dbalsom/seequa_chameleon/kicad/reference_images/under_sram_01.jpg

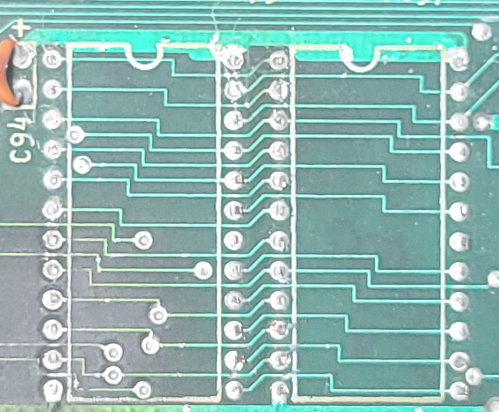
kicad/reference_images/under_sram_01.jpg
