dbalsom/seequa_chameleon/kicad/reference_images/under_6845.jpg

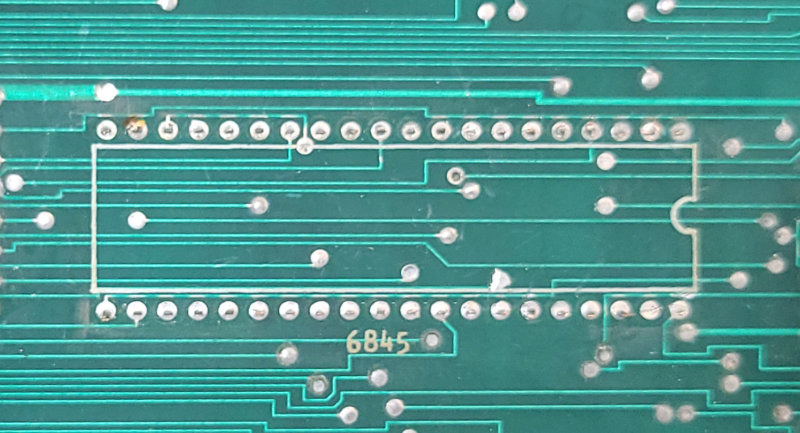
kicad/reference_images/under_6845.jpg
