dbalsom/seequa_chameleon/README.md

# The Seequa Chameleon

chameleon

The Chameleon was an interesting PC clone luggable. 

It had a Z80 and 8088 CPU, which could be switched between, allowing a Chameleon owner to use both MS-DOS and CP/M.

Forgoing the usual ISA expansion slots, it included a number of peripherals directly on the motherboard, including an integrated CGA-compatible video card with some interesting additions such as font SRAM and palette registers.

This project aims to produce schematics for the Chameleon by tracing out the motherboard in Kicad.

## Requirements

This project requires [KiCad version 9](https://www.kicad.org/download/).

## More info

For more info on the Chameleon, see the excellent [seequa.org](https://seequa.org/)

## Special Thanks

Thanks to Matthew Jones for nerd-sniping me with this fascinating and wonky machine.
