dbalsom/seequa_chameleon/kicad/reference_images/chameleon_front_04.jpg

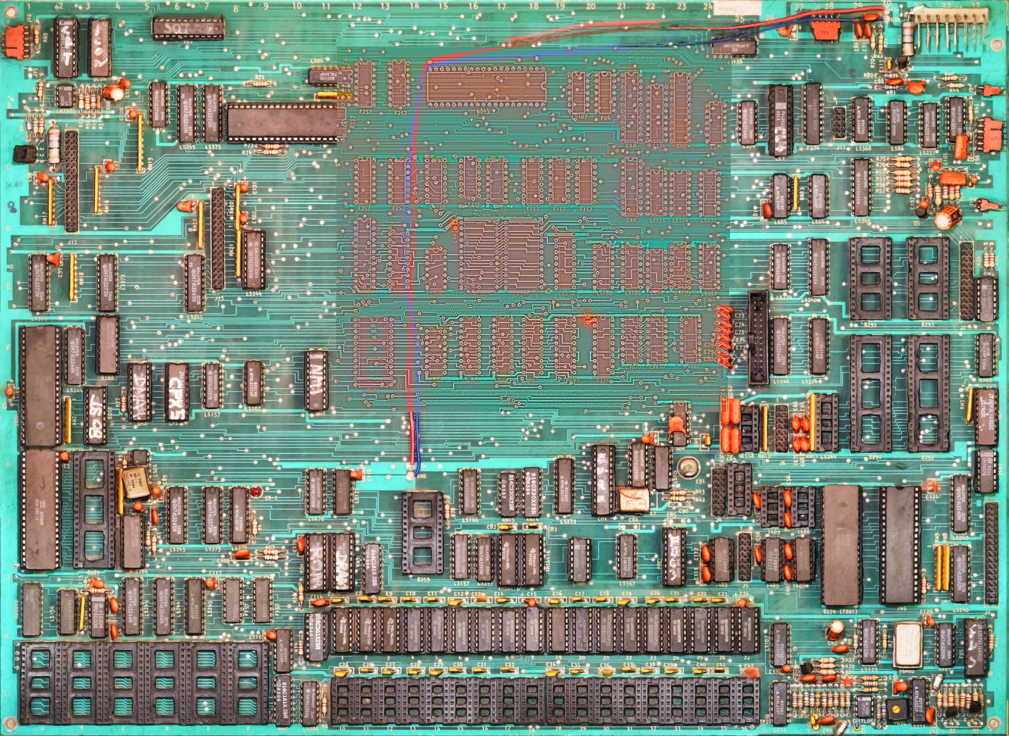
kicad/reference_images/chameleon_front_04.jpg
