dbalsom/seequa_chameleon/kicad/reference_images/chameleon_front_05.jpg

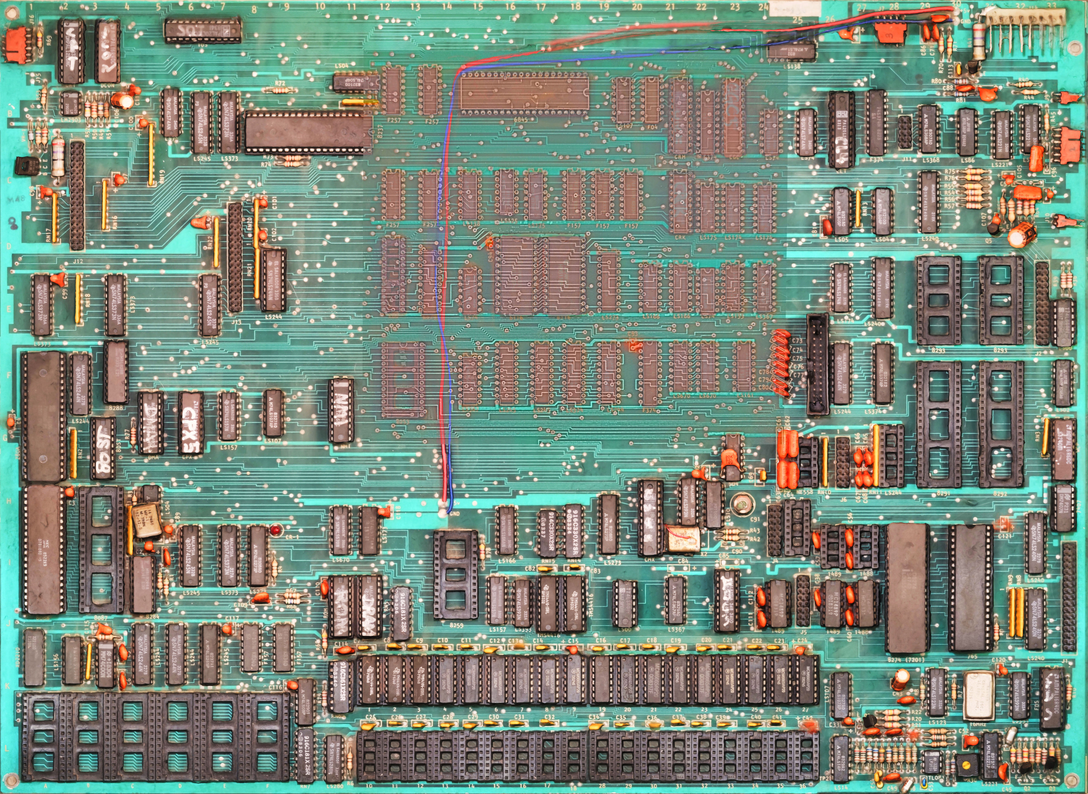
kicad/reference_images/chameleon_front_05.jpg
