dbalsom/seequa_chameleon/kicad/reference_images/chameleon_front_06.jpg

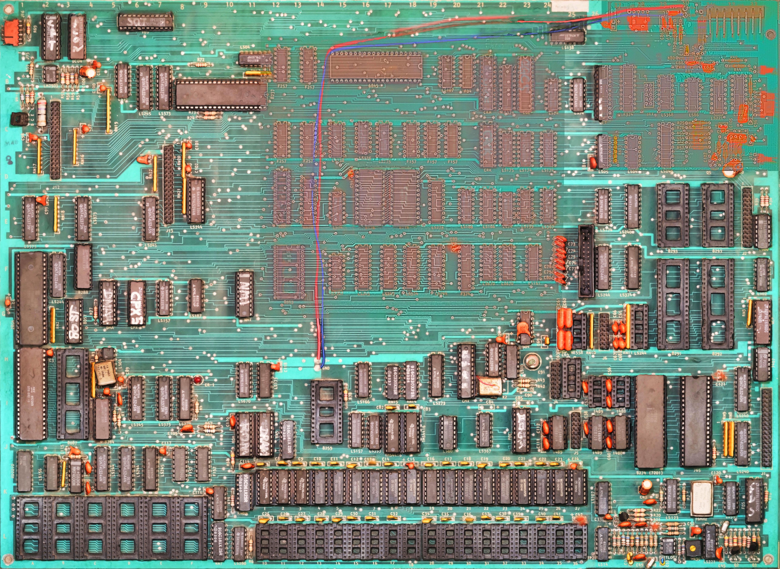
kicad/reference_images/chameleon_front_06.jpg
