dbalsom/seequa_chameleon/kicad/reference_images/schematic_background.png

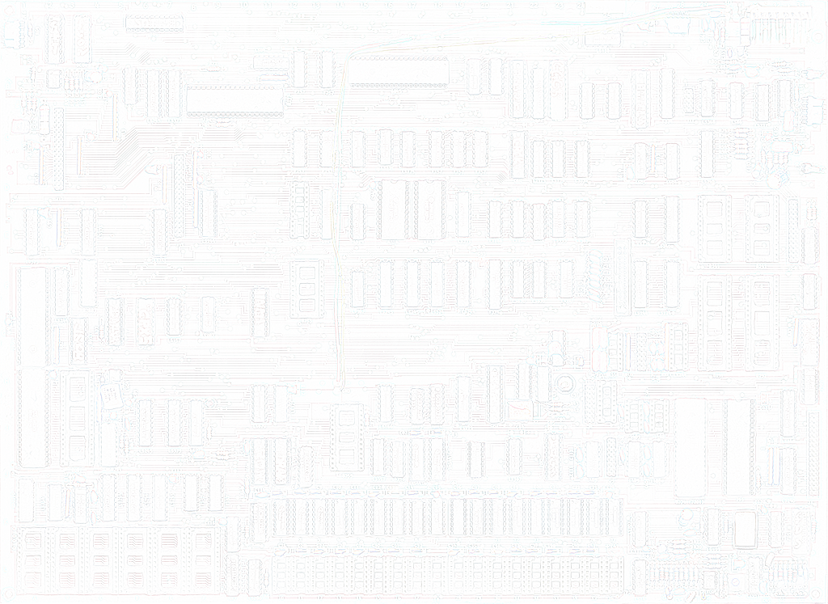
kicad/reference_images/schematic_background.png
