dbalsom/seequa_chameleon/kicad/reference_images/under_cpu_01.jpg

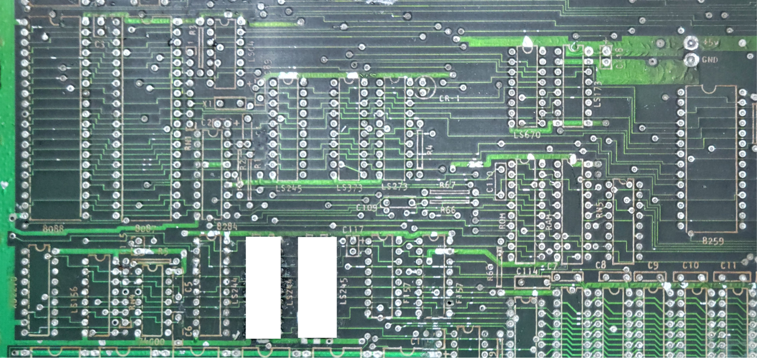
kicad/reference_images/under_cpu_01.jpg
