dbalsom/seequa_chameleon/kicad/reference_images/under_roms_01.jpg

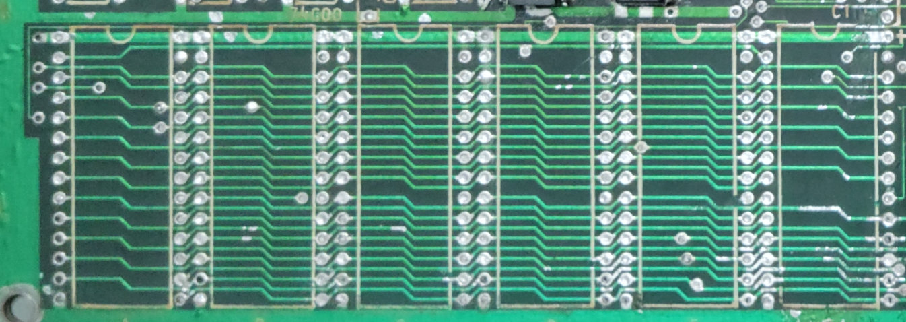
kicad/reference_images/under_roms_01.jpg
