dbalsom/seequa_chameleon/kicad/reference_images/under_tape_01.jpg

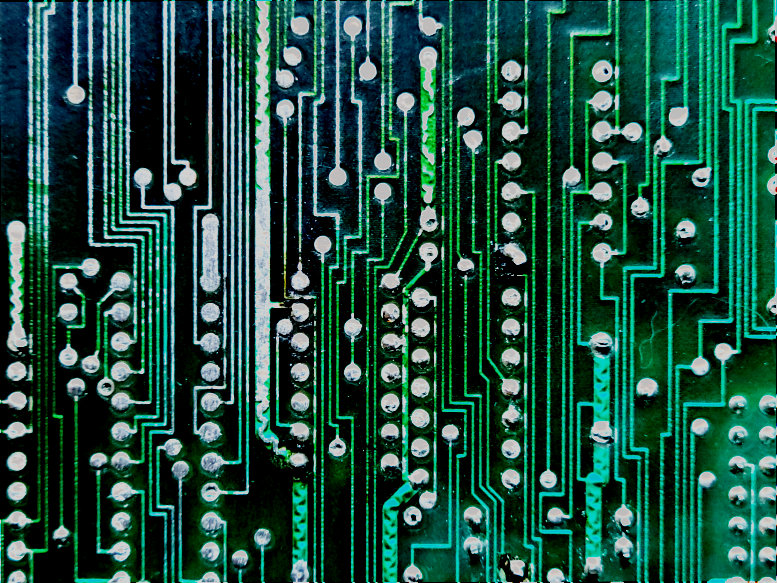
kicad/reference_images/under_tape_01.jpg
