dbalsom/seequa_chameleon/kicad/composite_video.kicad_sch

## KiCad design kicad/composite_video.kicad_sch (2026-05-13)

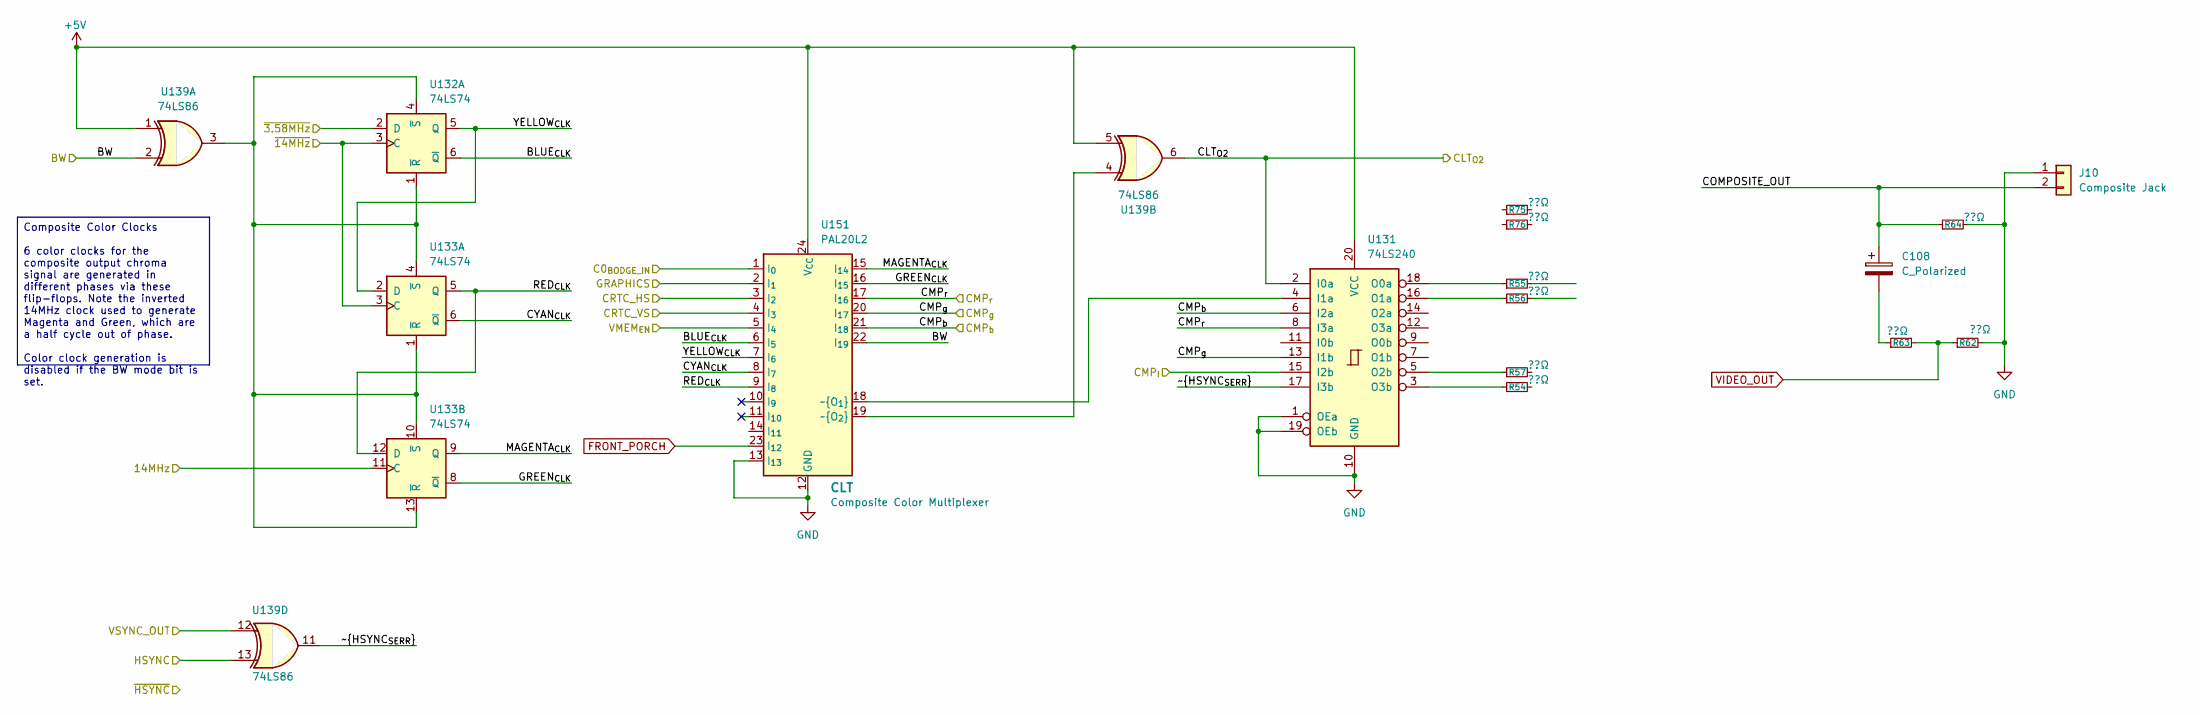
[picture p10: schematic composite_video.kicad_sch]

Parts:
C108: C_Polarized
J10: Composite Jack; PinHeader_1x02_P2.54mm_Horizontal
R54, R55, R56, R57, R62, R63, R64, R75, R76: ??Ω; R_Seequa_Resistor
U131: 74LS240; DIP-20_W7.62mm
U132, U133: 74LS74; DIP-14_W7.62mm
U139: 74LS86; DIP-14_W7.62mm
U151: PAL20L2; DIP-24_W7.62mm

Connections:
14MHz: U133.11 (C)
+5V: U131.20 (VCC), U139.1, U139.5, U151.24 (V_{CC})
BLUE_{CLK}: U132.6 (~Q), U151.6 (I_{5})
BW: U139.2, U151.22 (I_{19})
C0_{BODGE_IN}: U151.1 (I_{0})
CLT_{O2}: U131.2 (I0a), U139.6
CMP_{I}: U131.15 (I2b)
CMP_{b}: U131.6 (I2a), U151.21 (I_{18})
CMP_{g}: U131.13 (I1b), U151.20 (I_{17})
CMP_{r}: U131.8 (I3a), U151.17 (I_{16})
COMPOSITE_OUT: C108.1, J10.2, R64.1
CRTC_HS: U151.3 (I_{2})
CRTC_VS: U151.4 (I_{3})
CYAN_{CLK}: U133.6 (~Q), U151.8 (I_{7})
FRONT_PORCH: U151.23 (I_{12})
GND: J10.1, R62.2, R64.2, U131.1 (OEa), U131.10 (GND), U131.19 (OEb), U151.12 (GND), U151.13 (I_{13})
GRAPHICS: U151.2 (I_{1})
GREEN_{CLK}: U133.8 (~Q), U151.16 (I_{15})
HSYNC: U139.13
MAGENTA_{CLK}: U133.9 (Q), U151.15 (I_{14})
unnamed: C108.2, R63.1
unnamed: R54.1, U131.3 (O3b)
unnamed: R55.1, U131.18 (O0a)
unnamed: R56.1, U131.16 (O1a)
unnamed: R57.1, U131.5 (O2b)
unnamed: U131.4 (I1a), U151.18 (~O_{1})
unnamed: U132.1 (~R), U132.4 (~S), U133.1 (~R), U133.4 (~S), U133.10 (~S), U133.13 (~R), U139.3
unnamed: U139.4, U151.19 (~O_{2})
RED_{CLK}: U133.5 (Q), U133.12 (D), U151.9 (I_{8})
VIDEO_OUT: R62.1, R63.2
VMEM_{EN}: U151.5 (I_{4})
VSYNC_OUT: U139.12
YELLOW_{CLK}: U132.5 (Q), U133.2 (D), U151.7 (I_{6})
~3.58MHz: U132.2 (D)
~14MHz: U132.3 (C), U133.3 (C)
~HSYNC_{SERR}: U131.17 (I3b), U139.11

Notes on the sheet:
Composite Color Clocks 6 color clocks for the composite output chroma signal are generated in different phases via these flip-flops. Note the inverted 14MHz clock used to generate Magenta and Green, which are a half cycle out of phase. Color clock generation is disabled if the BW mode bit is set.
