dbalsom/seequa_chameleon/kicad/cpu.kicad_sch

## KiCad design kicad/cpu.kicad_sch (2026-05-13)

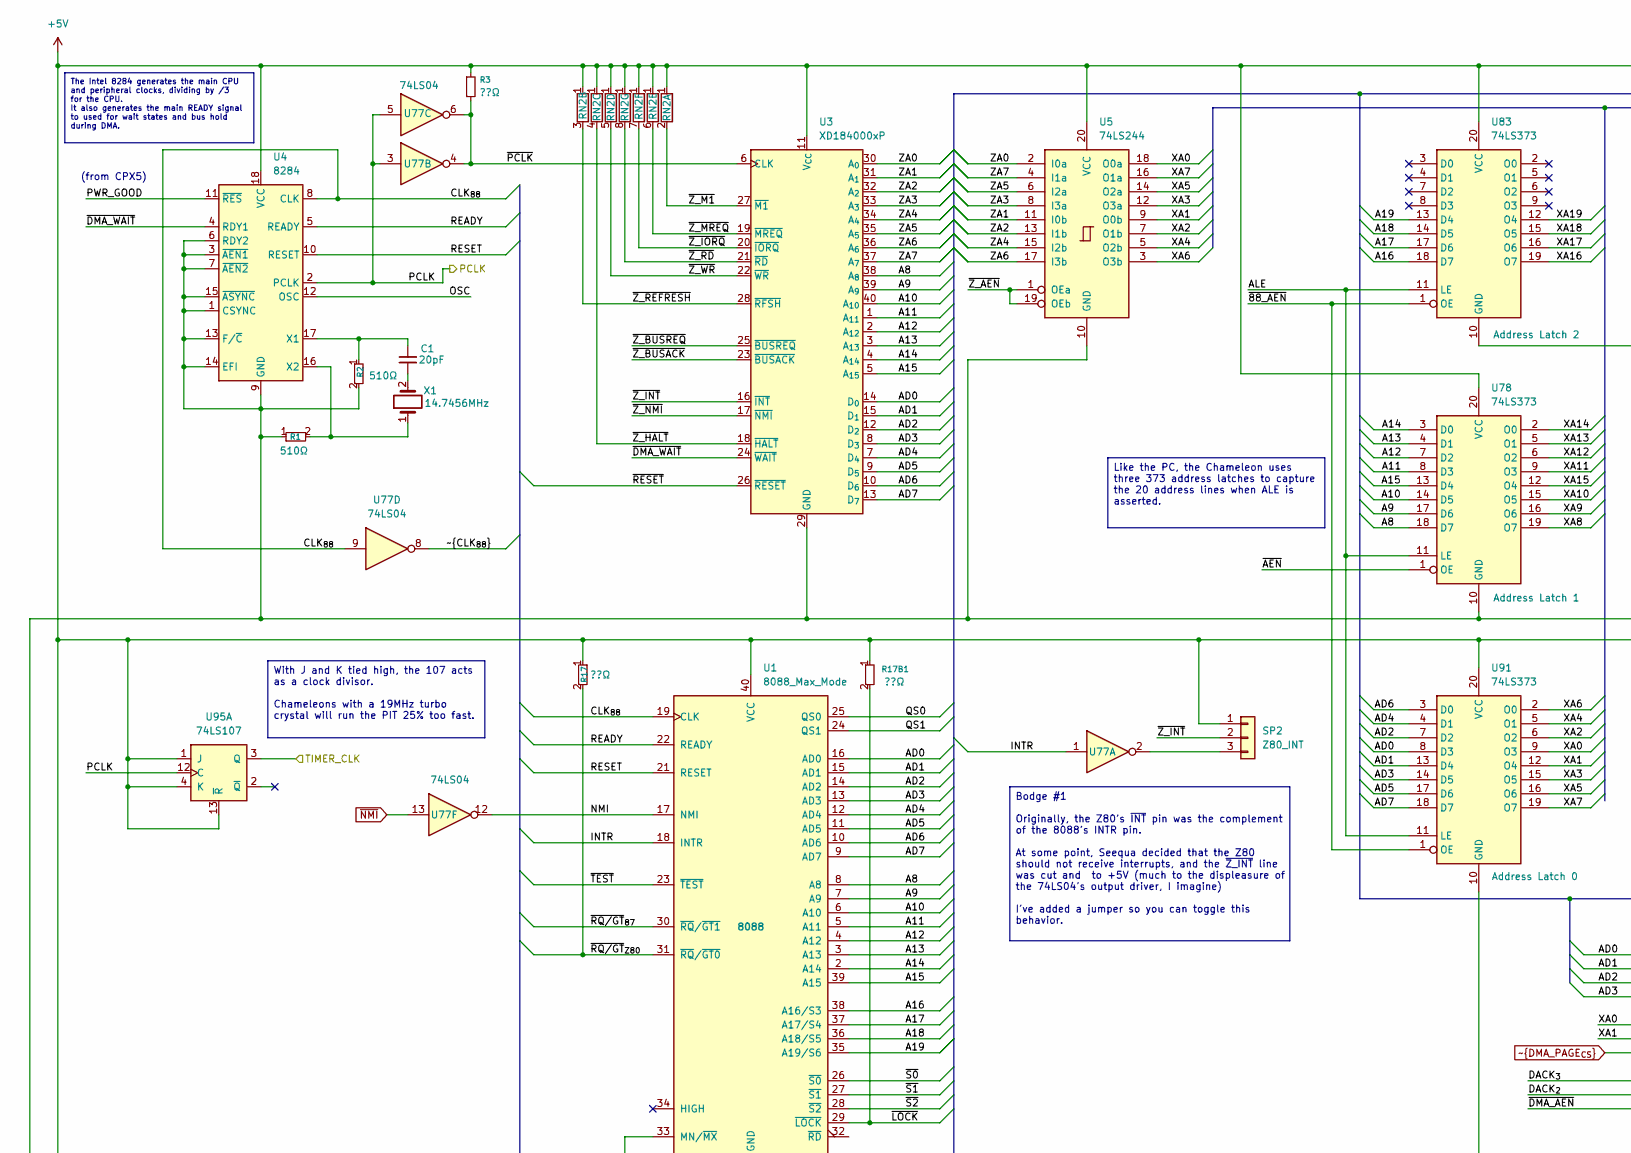
[picture p11: schematic cpu.kicad_sch, part in row 1, column 1]

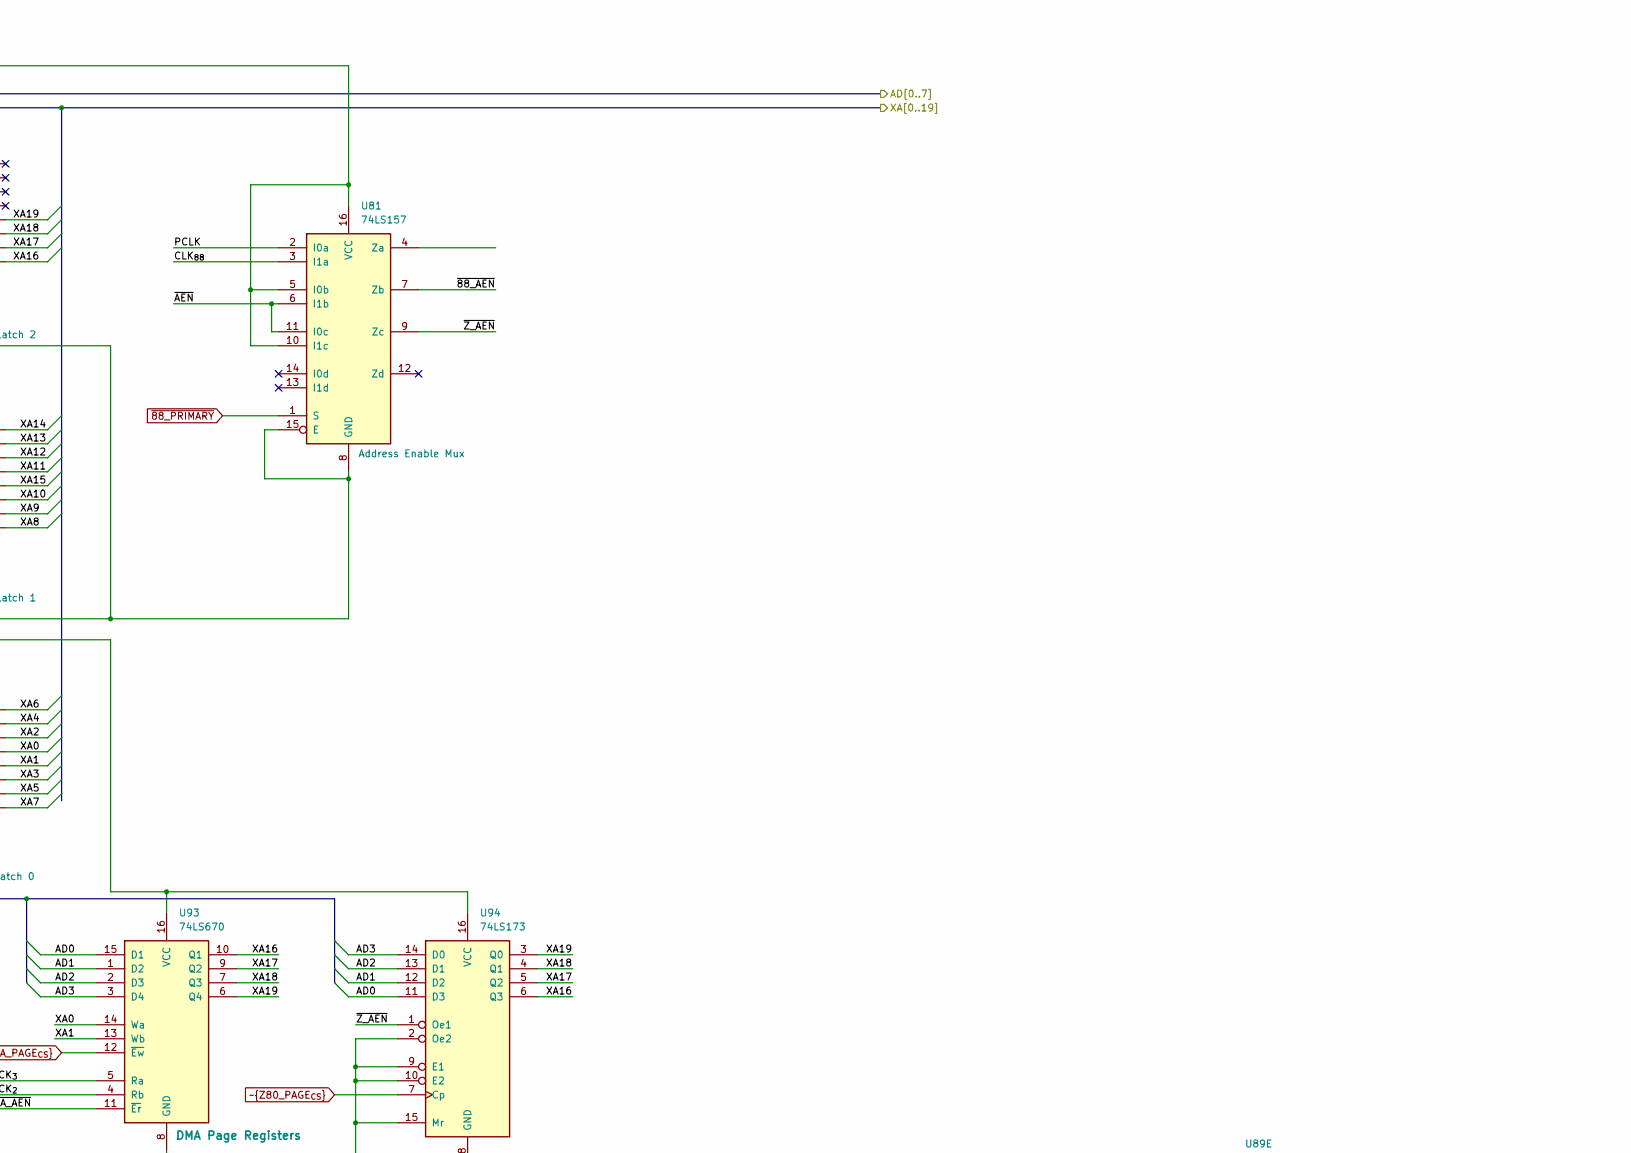
[picture p12: schematic cpu.kicad_sch, part in row 1, column 2]

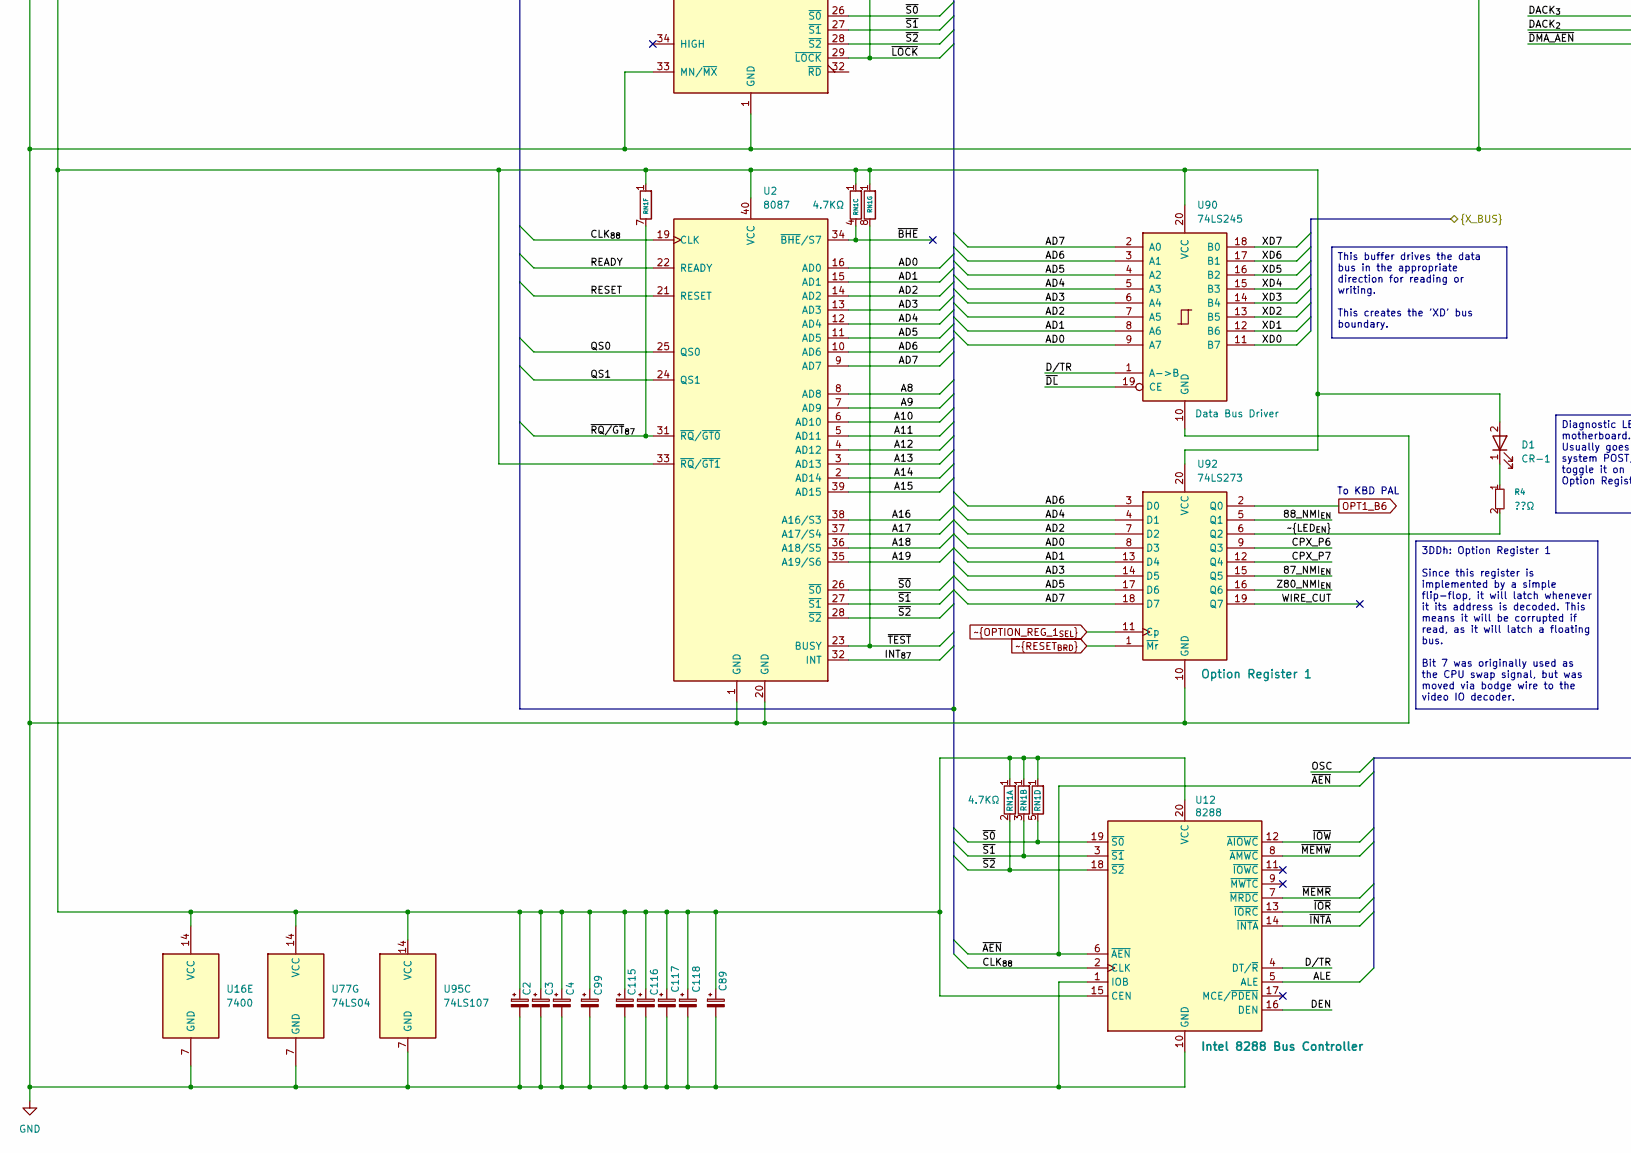
[picture p13: schematic cpu.kicad_sch, part in row 2, column 1]

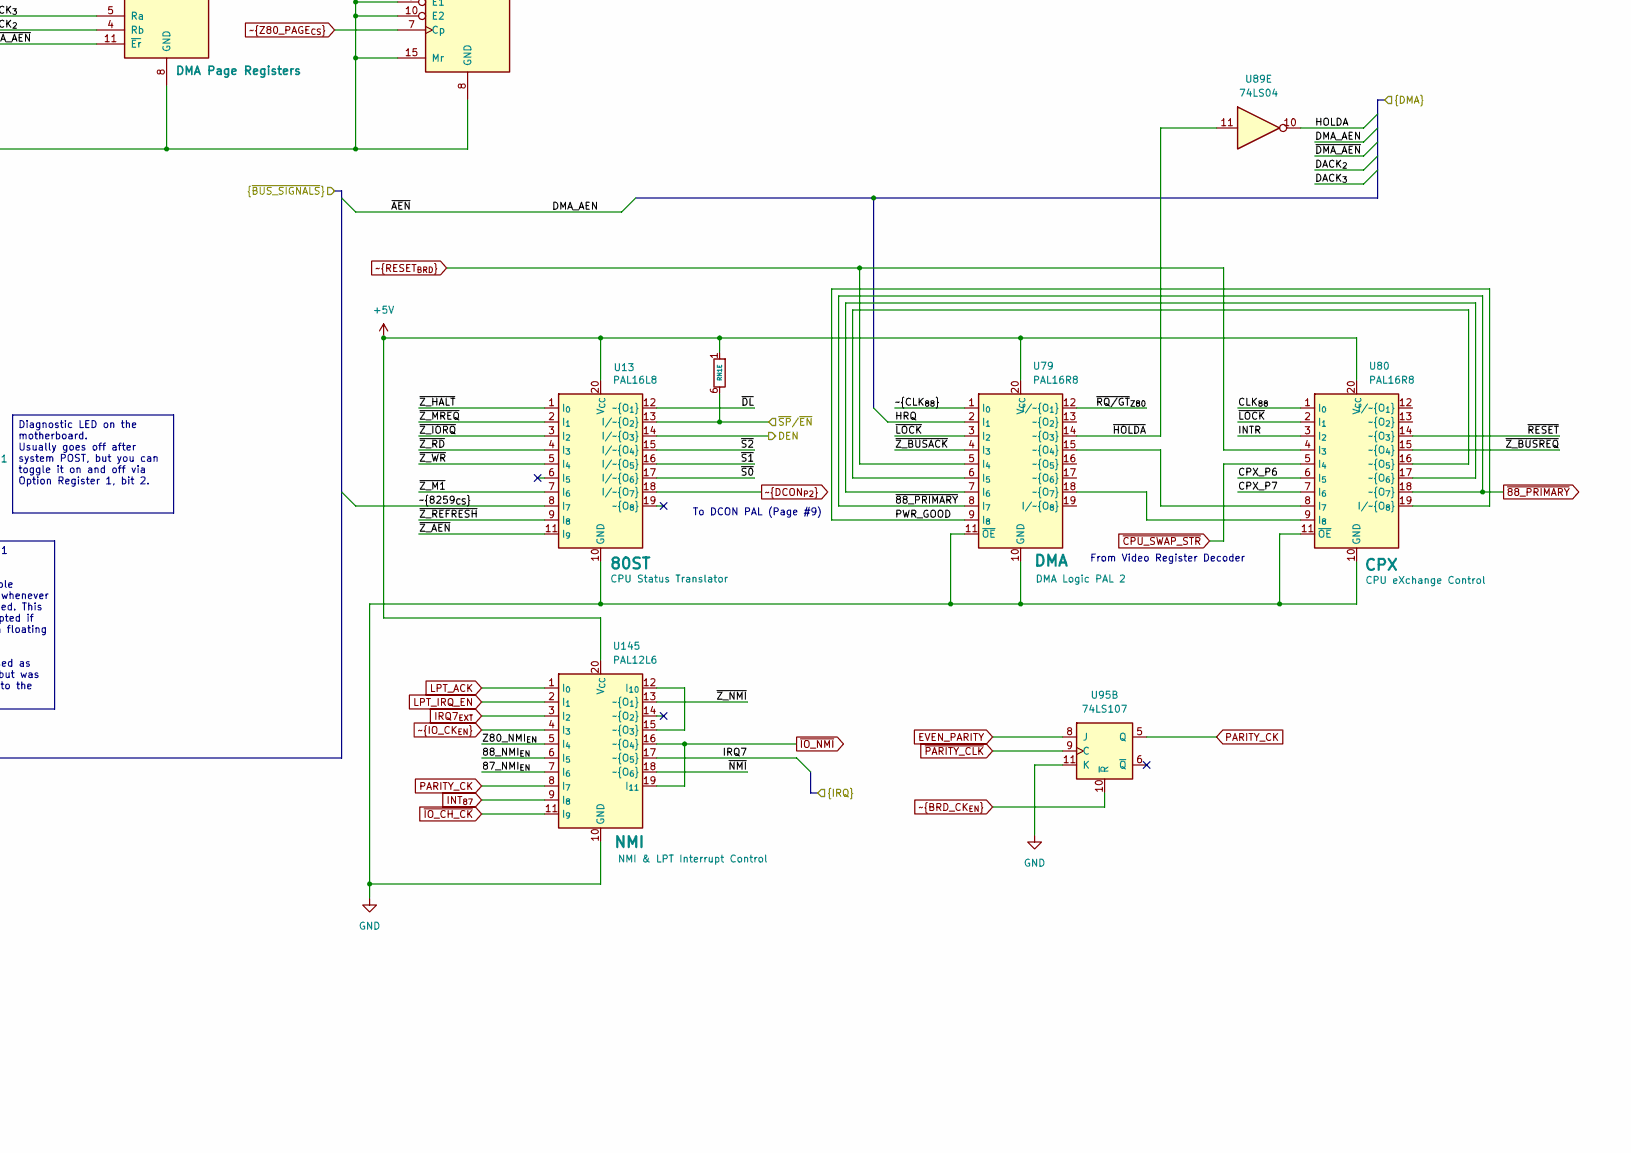
[picture p14: schematic cpu.kicad_sch, part in row 2, column 2]

Parts:
C1: 20pF; C_Seequa_Clock_Cap_6.35mm
C2, C3, C4, C99, C115, C116, C117, C118: 0.1uF; C_Seequa_Bypass_2.54mm
C89: C_Bypass_3.8mm; C_Seequa_Bypass_3.8mm
D1: CR-1; LED_D3.0mm
R1, R2: 510Ω; R_Seequa_Resistor
R3, R4, R17, R17B1: ??Ω; R_Seequa_Resistor
RN1: 4.7KΩ; R_Array_SIP8
RN2: 4.7K; R_Array_SIP8
SP2: Z80_INT; PinHeader_1x03_P2.54mm_Vertical
U1: 8088_Max_Mode; DIP-40_W15.24mm_Socket
U2: 8087; DIP-40_W15.24mm
U3: XD184000xP; DIP-40_W15.24mm
U4: 8284; DIP-18_W7.62mm
U5: 74LS244; DIP-20_W7.62mm
U12: 8288; DIP-20_W7.62mm
U13: PAL16L8; DIP-20_W7.62mm
U16: 7400; DIP-14_W7.62mm
U77, U89: 74LS04; DIP-14_W7.62mm
U78, U83, U91: 74LS373; DIP-20_W7.62mm
U79, U80: PAL16R8; DIP-20_W7.62mm
U81: 74LS157; DIP-16_W7.62mm
U90: 74LS245; DIP-20_W7.62mm
U92: 74LS273; DIP-20_W7.62mm
U93: 74LS670; DIP-16_W7.62mm
U94: 74LS173; DIP-16_W7.62mm
U95: 74LS107; DIP-14_W7.62mm
U145: PAL12L6; DIP-20_W7.62mm
X1: 14.7456MHz; Crystal_HC49-U_Vertical

Connections:
87_NMI_{EN}: U92.15 (Q5), U145.7 (I_{6})
88_NMI_{EN}: U92.5 (Q1), U145.6 (I_{5})
+5V: C2.1, C3.1, C4.1, C89.1, C99.1, C115.1, C116.1, C117.1, C118.1, D1.2 (A), R3.1, R17.1, R17B1.1, RN1.1 (R1), RN2.1 (R1), SP2.1, U1.40 (VCC), U2.33 (~RQ/~GT1), U2.40 (VCC), U3.11 (V_{CC}), U4.18 (VCC), U5.20 (VCC), U12.15 (CEN), U12.20 (VCC), U13.20 (V_{CC}), U16.14 (VCC), U77.14 (VCC), U78.20 (VCC), U79.20 (V_{CC}), U80.20 (V_{CC}), U81.5 (I0b), U81.10 (I1c), U81.16 (VCC), U83.20 (VCC), U90.20 (VCC), U91.20 (VCC), U92.20 (VCC), U93.16 (VCC), U94.16 (VCC), U95.1 (J), U95.4 (K), U95.13 (~R), U95.14 (VCC), U145.20 (V_{CC})
A8: U1.8 (A8), U2.8 (AD8), U3.38 (A_{8}), U78.18 (D7)
A9: U1.7 (A9), U2.7 (AD9), U3.39 (A_{9}), U78.17 (D6)
A10: U1.6 (A10), U2.6 (AD10), U3.40 (A_{10}), U78.14 (D5)
A11: U1.5 (A11), U2.5 (AD11), U3.1 (A_{11}), U78.8 (D3)
A12: U1.4 (A12), U2.4 (AD12), U3.2 (A_{12}), U78.7 (D2)
A13: U1.3 (A13), U2.3 (AD13), U3.3 (A_{13}), U78.4 (D1)
A14: U1.2 (A14), U2.2 (AD14), U3.4 (A_{14}), U78.3 (D0)
A15: U1.39 (A15), U2.39 (AD15), U3.5 (A_{15}), U78.13 (D4)
A16: U1.38 (A16/S3), U2.38 (A16/S3), U83.18 (D7)
A17: U1.37 (A17/S4), U2.37 (A17/S4), U83.17 (D6)
A18: U1.36 (A18/S5), U2.36 (A18/S5), U83.14 (D5)
A19: U1.35 (A19/S6), U2.35 (A19/S6), U83.13 (D4)
AD0: U1.16 (AD0), U2.16 (AD0), U3.14 (D_{0}), U90.9 (A7), U91.8 (D3), U92.8 (D3), U93.15 (D1), U94.11 (D3)
AD1: U1.15 (AD1), U2.15 (AD1), U3.15 (D_{1}), U90.8 (A6), U91.13 (D4), U92.13 (D4), U93.1 (D2), U94.12 (D2)
AD2: U1.14 (AD2), U2.14 (AD2), U3.12 (D_{2}), U90.7 (A5), U91.7 (D2), U92.7 (D2), U93.2 (D3), U94.13 (D1)
AD3: U1.13 (AD3), U2.13 (AD3), U3.8 (D_{3}), U90.6 (A4), U91.14 (D5), U92.14 (D5), U93.3 (D4), U94.14 (D0)
AD4: U1.12 (AD4), U2.12 (AD4), U3.7 (D_{4}), U90.5 (A3), U91.4 (D1), U92.4 (D1)
AD5: U1.11 (AD5), U2.11 (AD5), U3.9 (D_{5}), U90.4 (A2), U91.17 (D6), U92.17 (D6)
AD6: U1.10 (AD6), U2.10 (AD6), U3.10 (D_{6}), U90.3 (A1), U91.3 (D0), U92.3 (D0)
AD7: U1.9 (AD7), U2.9 (AD7), U3.13 (D_{7}), U90.2 (A0), U91.18 (D7), U92.18 (D7)
ALE: U12.5 (ALE), U78.11 (LE), U83.11 (LE), U91.11 (LE)
CLK_{88}: U1.19 (CLK), U2.19 (CLK), U4.8 (CLK), U12.2 (CLK), U77.9, U80.1 (I_{0}), U81.3 (I1a)
CPX_P6: U80.6 (I_{5}), U92.9 (Q3)
CPX_P7: U80.7 (I_{6}), U92.12 (Q4)
DACK_{2}: U93.4 (Rb)
DACK_{3}: U93.5 (Ra)
DEN: U12.16 (DEN), U13.14 (I/~O_{3})
DMA_AEN: U12.6 (~AEN), U78.1 (OE), U81.6 (I1b), U81.11 (I0c)
D/TR: U12.4 (DT/~R), U90.1 (A->B)
EVEN_PARITY: U95.8 (J)
GND: C2.2, C3.2, C4.2, C89.2, C99.2, C115.2, C116.2, C117.2, C118.2, R1.1, R2.2, U1.1 (GND), U1.20 (GND), U1.33 (MN/~MX), U2.1 (GND), U2.20 (GND), U3.29 (GND), U4.1 (CSYNC), U4.3 (~AEN1), U4.6 (RDY2), U4.7 (~AEN2), U4.9 (GND), U4.13 (F/~C), U4.14 (EFI), U4.15 (~ASYNC), U5.10 (GND), U12.1 (IOB), U12.10 (GND), U13.10 (GND), U16.7 (GND), U77.7 (GND), U78.10 (GND), U79.10 (GND), U79.11 (~OE), U80.10 (GND), U80.11 (~OE), U81.8 (GND), U81.15 (E), U83.10 (GND), U90.10 (GND), U91.10 (GND), U92.10 (GND), U93.8 (GND), U94.2 (Oe2), U94.8 (GND), U94.9 (E1), U94.10 (E2), U94.15 (Mr), U95.7 (GND), U95.11 (K), U145.10 (GND)
HOLDA: U89.10
HRQ: U79.2 (I_{1})
INTR: U1.18 (INTR), U77.1, U80.3 (I_{2})
INT_{87}: U2.32 (INT), U145.9 (I_{8})
IRQ7: U145.17 (~O_{5})
IRQ7_{EXT}: U145.3 (I_{2})
LPT_ACK: U145.1 (I_{0})
LPT_IRQ_EN: U145.2 (I_{1})
NMI: U1.17 (NMI), U77.12
unnamed: C1.1, X1.2
unnamed: C1.2, R2.1, U4.17 (X1)
unnamed: D1.1 (K), R4.1
unnamed: R1.2, U4.16 (X2), X1.1
unnamed: SP2.3, U77.2
unnamed: U79.6 (I_{5}), U80.16 (~O_{5})
unnamed: U79.7 (I_{6}), U80.17 (~O_{6})
unnamed: U79.15 (~O_{4}), U80.8 (I_{7})
unnamed: U79.18 (~O_{7}), U80.9 (I_{8})
unnamed: U145.12 (I_{10}), U145.15 (~O_{3})
OPT1_B6: U92.2 (Q0)
OSC: U4.12 (OSC)
PARITY_CK: U95.5 (Q), U145.8 (I_{7})
PCLK: U4.2 (PCLK), U77.3, U77.5, U81.2 (I0a), U95.12 (C)
PWR_GOOD: U4.11 (~RES), U79.9 (I_{8}), U80.19 (I/~O_{8})
QS0: U1.25 (QS0), U2.25 (QS0)
QS1: U1.24 (QS1), U2.24 (QS1)
READY: U1.22 (READY), U2.22 (READY), U4.5 (READY)
RESET: U1.21 (RESET), U2.21 (RESET), U4.10 (RESET)
TIMER_CLK: U95.3 (Q)
WIRE_CUT: U92.19 (Q7)
XA0: U5.18 (O0a), U91.9 (O3), U93.14 (Wa)
XA1: U5.9 (O0b), U91.12 (O4), U93.13 (Wb)
XA2: U5.7 (O1b), U91.6 (O2)
XA3: U5.12 (O3a), U91.15 (O5)
XA4: U5.5 (O2b), U91.5 (O1)
XA5: U5.14 (O2a), U91.16 (O6)
XA6: U5.3 (O3b), U91.2 (O0)
XA7: U5.16 (O1a), U91.19 (O7)
XA8: U78.19 (O7)
XA9: U78.16 (O6)
XA10: U78.15 (O5)
XA11: U78.9 (O3)
XA12: U78.6 (O2)
XA13: U78.5 (O1)
XA14: U78.2 (O0)
XA15: U78.12 (O4)
XA16: U83.19 (O7), U93.10 (Q1), U94.6 (Q3)
XA17: U83.16 (O6), U93.9 (Q2), U94.5 (Q2)
XA18: U83.15 (O5), U93.7 (Q3), U94.4 (Q1)
XA19: U83.12 (O4), U93.6 (Q4), U94.3 (Q0)
XD0: U90.11 (B7)
XD1: U90.12 (B6)
XD2: U90.13 (B5)
XD3: U90.14 (B4)
XD4: U90.15 (B3)
XD5: U90.16 (B2)
XD6: U90.17 (B1)
XD7: U90.18 (B0)
Z80_NMI_{EN}: U92.16 (Q6), U145.5 (I_{4})
ZA0: U3.30 (A_{0}), U5.2 (I0a)
ZA1: U3.31 (A_{1}), U5.11 (I0b)
ZA2: U3.32 (A_{2}), U5.13 (I1b)
ZA3: U3.33 (A_{3}), U5.8 (I3a)
ZA4: U3.34 (A_{4}), U5.15 (I2b)
ZA5: U3.35 (A_{5}), U5.6 (I2a)
ZA6: U3.36 (A_{6}), U5.17 (I3b)
ZA7: U3.37 (A_{7}), U5.4 (I1a)
~88_AEN: U81.7 (Zb), U83.1 (OE), U91.1 (OE)
~88_PRIMARY: U79.8 (I_{7}), U80.18 (~O_{7}), U81.1 (S)
~8259_{CS}: U13.8 (I_{7})
~BHE: RN1.4 (R3.2), U2.34 (~BHE/S7)
~BRD_CK_{EN}: U95.10 (~R)
~CLK_{88}: U77.8, U79.1 (I_{0})
~CPU_SWAP_STR: U80.5 (I_{4})
~DCON_{P2}: U13.18 (I/~O_{7})
~DL: U13.12 (~O_{1}), U90.19 (CE)
~DMA_AEN: U93.11 (~Er)
~DMA_PAGE_{CS}: U93.12 (~Ew)
~DMA_WAIT: U3.24 (~WAIT), U4.4 (RDY1)
~HOLDA: U79.14 (~O_{3}), U89.11
~INTA: U12.14 (~INTA)
~IOR: U12.13 (~IORC)
~IOW: U12.12 (~AIOWC)
~IO_CH_CK: U145.11 (I_{9})
~IO_CK_{EN}: U145.4 (I_{3})
~IO_NMI: U145.16 (~O_{4}), U145.19 (I_{11})
~LED_{EN}: R4.2, U92.6 (Q2)
~LOCK: R17B1.2, U1.29 (~LOCK), U79.3 (I_{2}), U80.2 (I_{1})
~MEMR: U12.7 (~MRDC)
~MEMW: U12.8 (~AMWC)
~NMI: U77.13, U145.18 (~O_{6})
~OPTION_REG_1_{SEL}: U92.11 (Cp)
~PARITY_CLK: U95.9 (C)
~PCLK: R3.2, U3.6 (CLK), U77.4, U77.6
~RESET_{BRD}: U79.5 (I_{4}), U80.4 (I_{3}), U92.1 (~Mr)
~RESET: U3.26 (~RESET), U80.14 (~O_{3})
~RQ/GT_{87}: RN1.7 (R6.2), U1.30 (~RQ/~GT1), U2.31 (~RQ/~GT0)
~RQ/GT_{Z80}: R17.2, U1.31 (~RQ/~GT0), U79.12 (I/~O_{1})
~S0: RN1.5 (R4.2), U1.26 (~S0), U2.26 (~S0), U12.19 (~S0), U13.17 (I/~O_{6})
~S1: RN1.3 (R2.2), U1.27 (~S1), U2.27 (~S1), U12.3 (~S1), U13.16 (I/~O_{5})
~S2: RN1.2 (R1.2), U1.28 (~S2), U2.28 (~S2), U12.18 (~S2), U13.15 (I/~O_{4})
~SP/~EN: RN1.6 (R5.2), U13.13 (I/~O_{2})
~TEST: RN1.8 (R7.2), U1.23 (~TEST), U2.23 (BUSY)
~Z80_PAGE_{CS}: U94.7 (Cp)
~Z_AEN: U5.1 (OEa), U5.19 (OEb), U13.11 (I_{9}), U81.9 (Zc), U94.1 (Oe1)
~Z_BUSACK: U3.23 (~BUSACK), U79.4 (I_{3})
~Z_BUSREQ: U3.25 (~BUSREQ), U80.15 (~O_{4})
~Z_HALT: RN2.4 (R3.2), U3.18 (~HALT), U13.1 (I_{0})
~Z_INT: SP2.2, U3.16 (~INT)
~Z_IORQ: RN2.7 (R6.2), U3.20 (~IORQ), U13.3 (I_{2})
~Z_M1: RN2.2 (R1.2), U3.27 (~M1), U13.7 (I_{6})
~Z_MREQ: RN2.6 (R5.2), U3.19 (~MREQ), U13.2 (I_{1})
~Z_NMI: U3.17 (~NMI), U145.13 (~O_{1})
~Z_RD: RN2.8 (R7.2), U3.21 (~RD), U13.4 (I_{3})
~Z_REFRESH: RN2.3 (R2.2), U3.28 (~RFSH), U13.9 (I_{8})
~Z_WR: RN2.5 (R4.2), U3.22 (~WR), U13.5 (I_{4})

Notes on the sheet:
To KBD PAL
From Video Register Decoder
To DCON PAL (Page #9)
(from CPX5)
With J and K tied high, the 107 acts as a clock divisor. Chameleons with a 19MHz turbo crystal will run the PIT 25% too fast.
3DDh: Option Register 1 Since this register is implemented by a simple flip-flop, it will latch whenever it its address is decoded. This means it will be corrupted if read, as it will latch a floating bus. Bit 7 was originally used as the CPU swap signal, but was moved via bodge wire to the video I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
The Intel 8284 generates the main CPU and peripheral clocks, dividing by /3 for the CPU. It also generates the main READY signal to used for wait states and bus hold during DMA.
Diagnostic LED on the motherboard. Usually goes off after system POST, but you can toggle it on and off via Option Register 1, bit 2.
Like the PC, the Chameleon uses three 373 address latches to capture the 20 address lines when ALE is asserted.
Bodge #1 Originally, the Z80's ~{INT} pin was the complement of the 8088's INTR pin. At some point, Seequa decided that the Z80 should not receive interrupts, and the ~{Z_INT} line was cut and to +5V (much to the displeasure of the 74LS04's output driver, I imagine) I've added a jumper so you can t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
This buffer drives the data bus in the appropriate direction for reading or writing. This creates the 'XD' bus boundary.
