dbalsom/seequa_chameleon/kicad/crtc.kicad_sch

## KiCad design kicad/crtc.kicad_sch (2026-05-13)

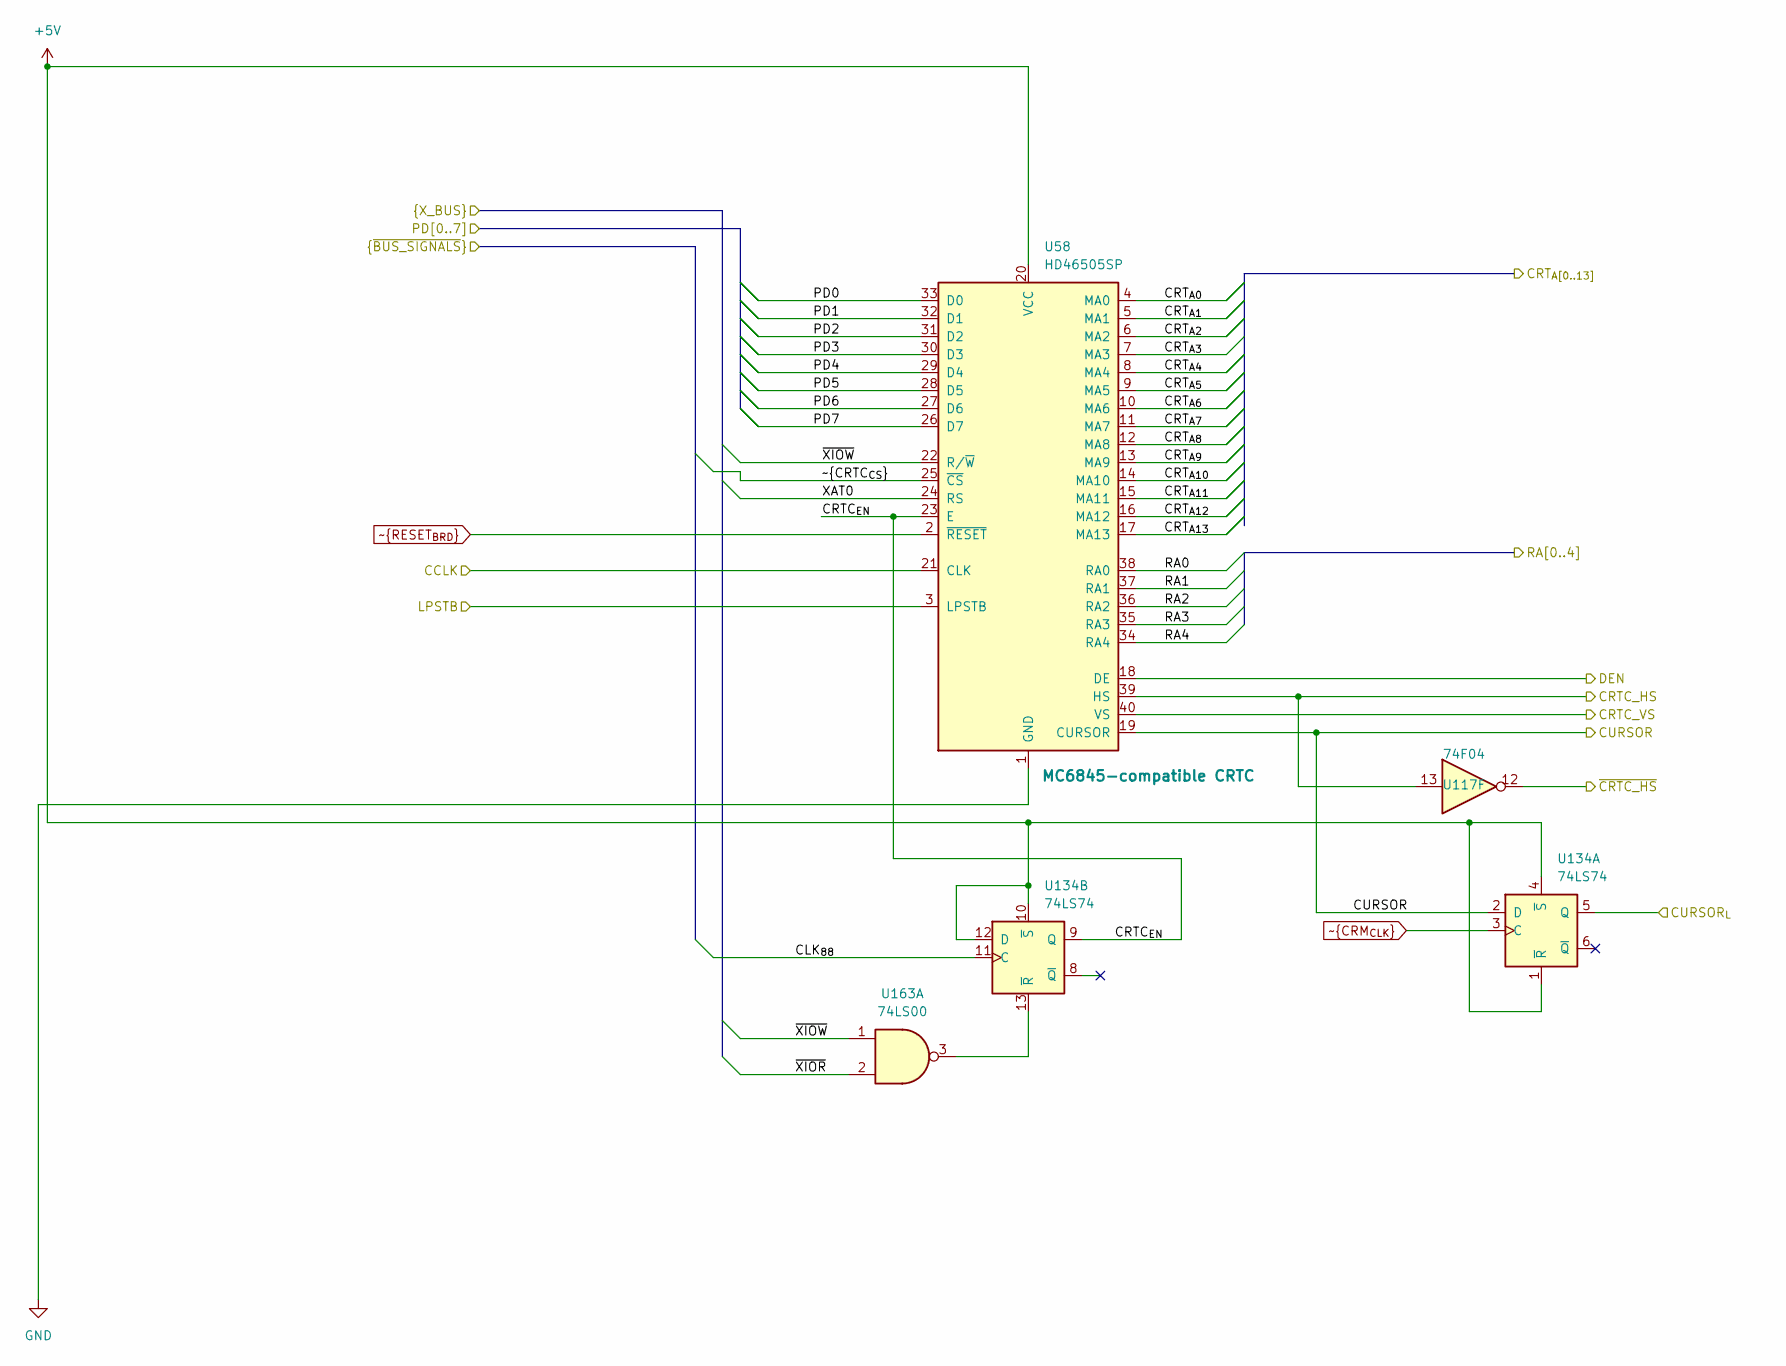
[picture p15: schematic crtc.kicad_sch]

Parts:
U58: HD46505SP; DIP-40_W15.24mm
U117: 74F04; DIP-14_W7.62mm
U134: 74LS74; DIP-14_W7.62mm
U163: 74LS00; DIP-14_W7.62mm_Socket

Connections:
+5V: U58.20 (VCC), U134.1 (~R), U134.4 (~S), U134.10 (~S), U134.12 (D)
CCLK: U58.21 (CLK)
CLK_{88}: U134.11 (C)
CRTC_HS: U58.39 (HS), U117.13
CRTC_VS: U58.40 (VS)
CRTC_{EN}: U58.23 (E), U134.9 (Q)
CRT_{A0}: U58.4 (MA0)
CRT_{A1}: U58.5 (MA1)
CRT_{A2}: U58.6 (MA2)
CRT_{A3}: U58.7 (MA3)
CRT_{A4}: U58.8 (MA4)
CRT_{A5}: U58.9 (MA5)
CRT_{A6}: U58.10 (MA6)
CRT_{A7}: U58.11 (MA7)
CRT_{A8}: U58.12 (MA8)
CRT_{A9}: U58.13 (MA9)
CRT_{A10}: U58.14 (MA10)
CRT_{A11}: U58.15 (MA11)
CRT_{A12}: U58.16 (MA12)
CRT_{A13}: U58.17 (MA13)
CURSOR: U58.19 (CURSOR), U134.2 (D)
CURSOR_{L}: U134.5 (Q)
DEN: U58.18 (DE)
GND: U58.1 (GND)
LPSTB: U58.3 (LPSTB)
unnamed: U134.13 (~R), U163.3
PD0: U58.33 (D0)
PD1: U58.32 (D1)
PD2: U58.31 (D2)
PD3: U58.30 (D3)
PD4: U58.29 (D4)
PD5: U58.28 (D5)
PD6: U58.27 (D6)
PD7: U58.26 (D7)
RA0: U58.38 (RA0)
RA1: U58.37 (RA1)
RA2: U58.36 (RA2)
RA3: U58.35 (RA3)
RA4: U58.34 (RA4)
XAT0: U58.24 (RS)
~CRM_{CLK}: U134.3 (C)
~CRTC_HS: U117.12
~CRTC_{CS}: U58.25 (~CS)
~RESET_{BRD}: U58.2 (~RESET)
~XIOR: U163.2
~XIOW: U58.22 (R/~W), U163.1
