dbalsom/seequa_chameleon/kicad/dma.kicad_sch

## KiCad design kicad/dma.kicad_sch (2026-05-13)

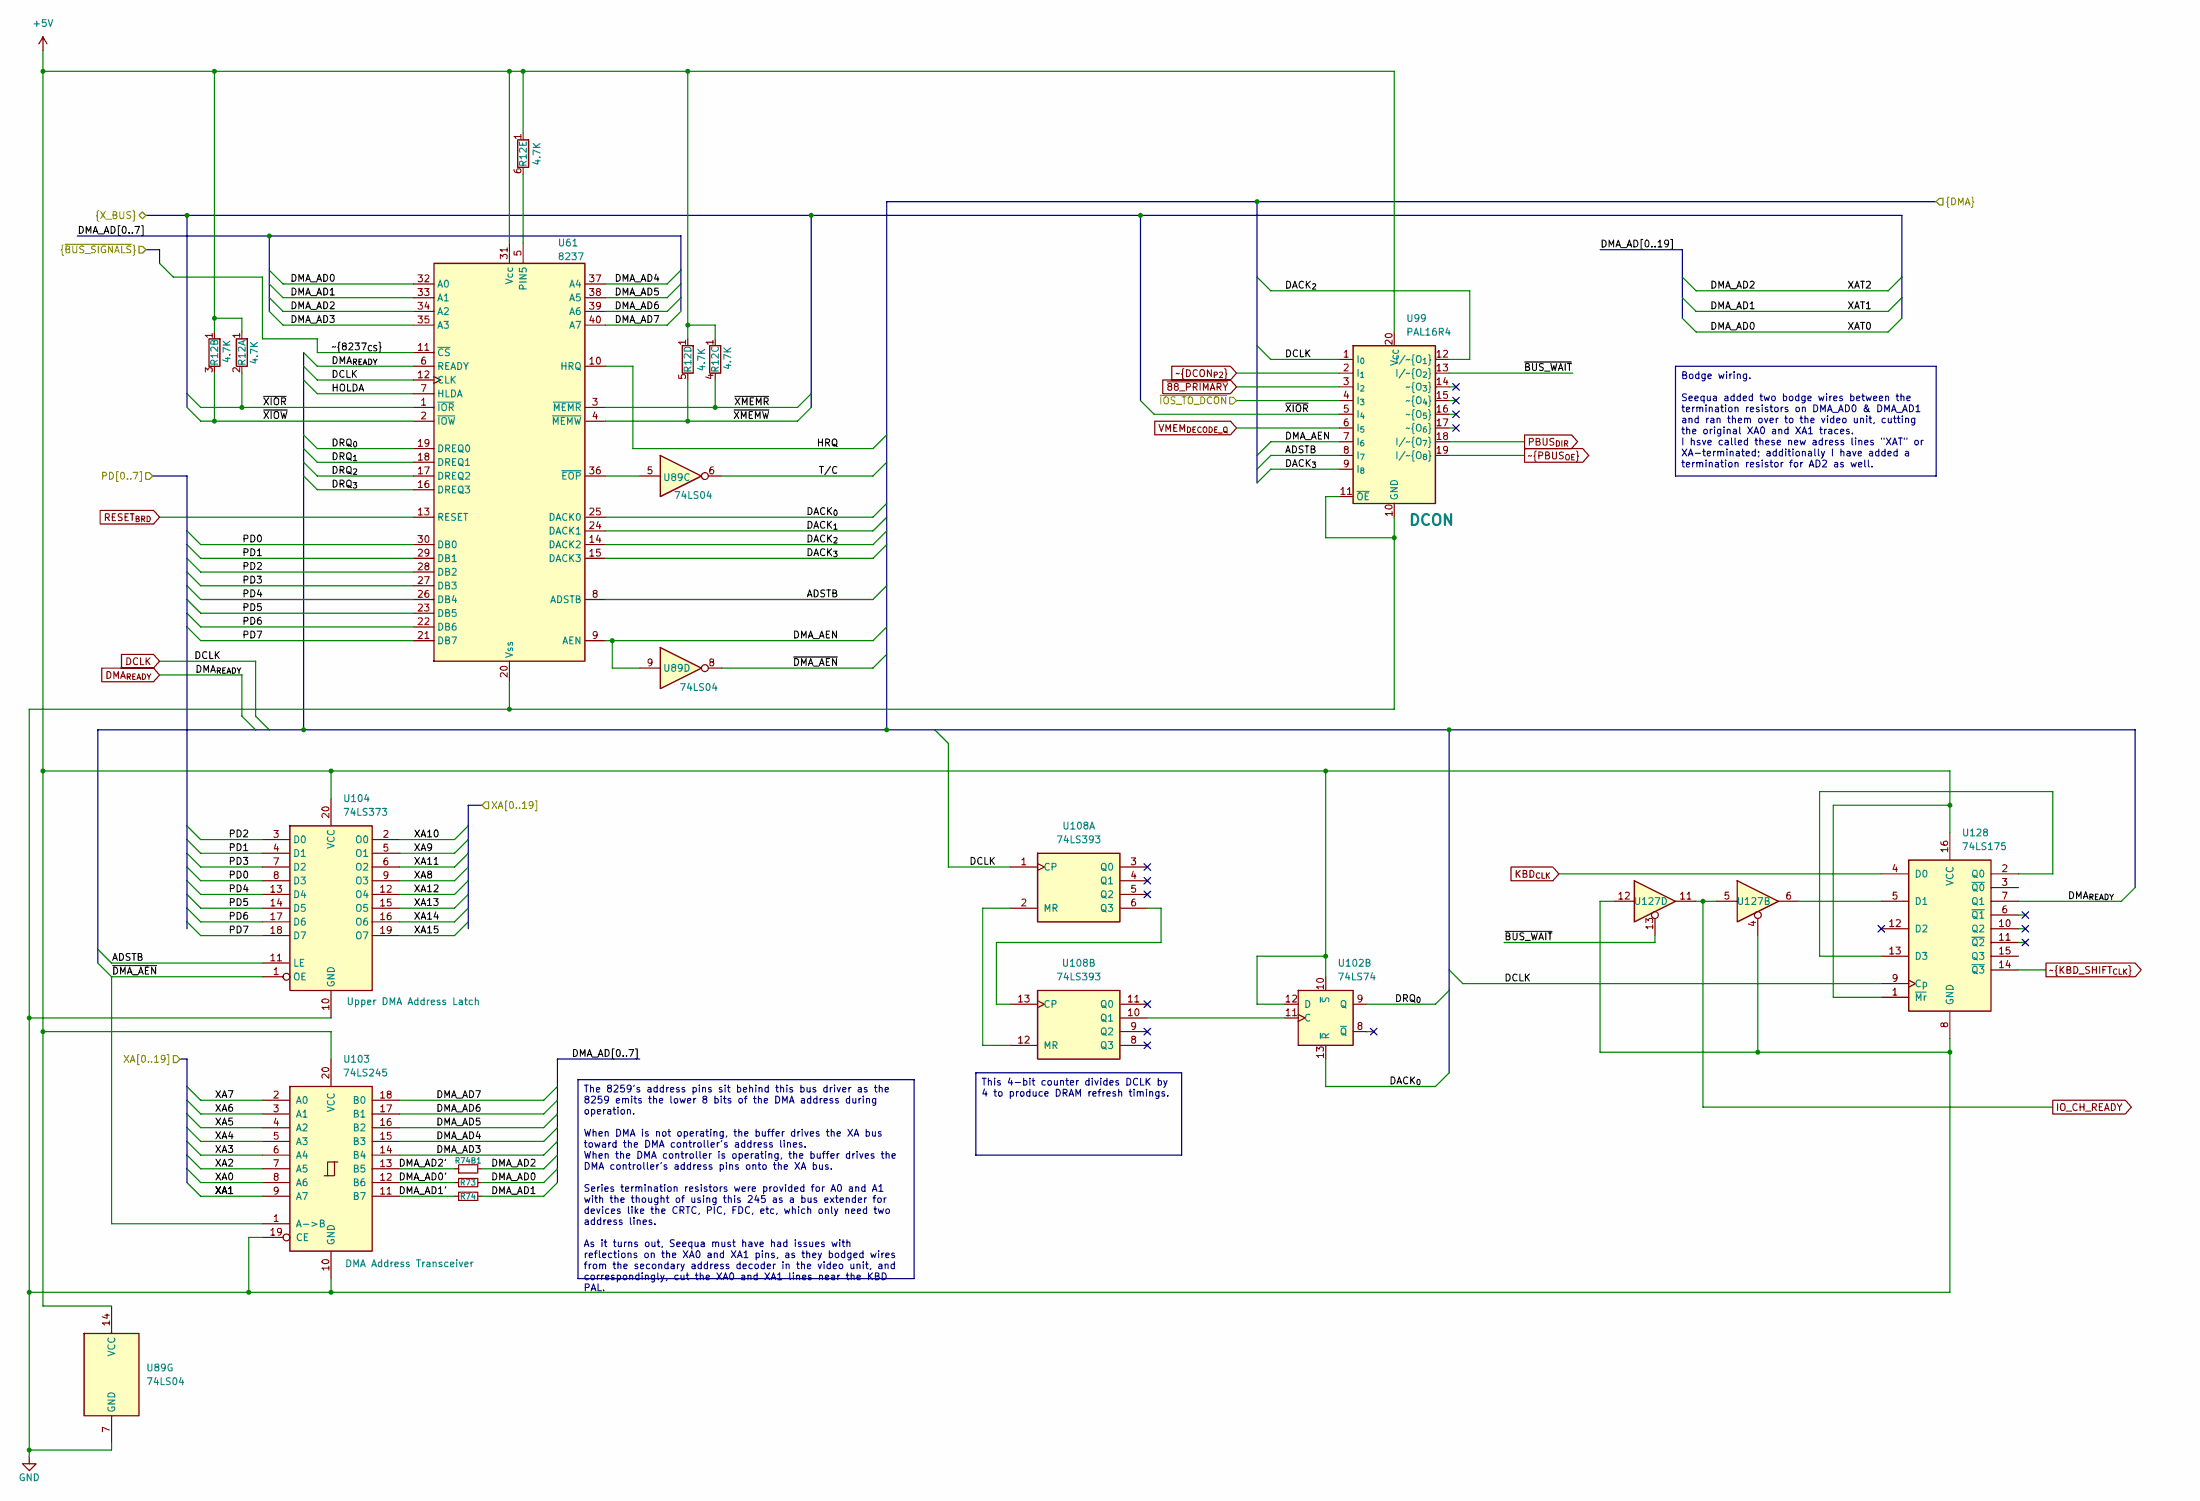
[picture p16: schematic dma.kicad_sch]

Parts:
R12: 4.7K; R_Array_SIP6
R73, R74, R74B1: R_Small; R_Seequa_Resistor
U61: 8237; DIP-40_W15.24mm
U89: 74LS04; DIP-14_W7.62mm
U99: PAL16R4; DIP-20_W7.62mm
U102: 74LS74; DIP-14_W7.62mm
U103: 74LS245; DIP-20_W7.62mm
U104: 74LS373; DIP-20_W7.62mm
U108: 74LS393; DIP-14_W7.62mm
U127: 74LS125; DIP-14_W7.62mm
U128: 74LS175; DIP-16_W7.62mm

Connections:
+5V: R12.1 (R1), U61.31 (Vcc), U89.14 (VCC), U99.20 (V_{CC}), U102.10 (~S), U102.12 (D), U103.20 (VCC), U104.20 (VCC), U128.1 (~Mr), U128.16 (VCC)
ADSTB: U61.8 (ADSTB), U99.8 (I_{7}), U104.11 (LE)
DACK_{0}: U61.25 (DACK0), U102.13 (~R)
DACK_{1}: U61.24 (DACK1)
DACK_{2}: U61.14 (DACK2), U99.12 (I/~O_{1})
DACK_{3}: U61.15 (DACK3), U99.9 (I_{8})
DCLK: U61.12 (CLK), U99.1 (I_{0}), U108.1 (CP), U128.9 (Cp)
DMA_AD0: R73.2, U61.32 (A0)
DMA_AD0': R73.1, U103.12 (B6)
DMA_AD1: R74.2, U61.33 (A1)
DMA_AD1': R74.1, U103.11 (B7)
DMA_AD2: R74B1.2, U61.34 (A2)
DMA_AD2': R74B1.1, U103.13 (B5)
DMA_AD3: U61.35 (A3), U103.14 (B4)
DMA_AD4: U61.37 (A4), U103.15 (B3)
DMA_AD5: U61.38 (A5), U103.16 (B2)
DMA_AD6: U61.39 (A6), U103.17 (B1)
DMA_AD7: U61.40 (A7), U103.18 (B0)
DMA_AEN: U61.9 (AEN), U89.9, U99.7 (I_{6})
DMA_{READY}: U61.6 (READY), U128.7 (Q1)
DRQ_{0}: U61.19 (DREQ0), U102.9 (Q)
DRQ_{1}: U61.18 (DREQ1)
DRQ_{2}: U61.17 (DREQ2)
DRQ_{3}: U61.16 (DREQ3)
GND: U61.20 (Vss), U89.7 (GND), U99.10 (GND), U99.11 (~OE), U103.10 (GND), U103.19 (CE), U104.10 (GND), U127.4, U127.12, U128.8 (GND)
HOLDA: U61.7 (HLDA)
HRQ: U61.10 (HRQ)
IO_CH_READY: U127.5, U127.11
KBD_{CLK}: U128.4 (D0)
unnamed: R12.6 (R5.2), U61.5 (PIN5)
unnamed: U61.36 (~EOP), U89.5
unnamed: U102.11 (C), U108.10 (Q1)
unnamed: U108.2 (MR), U108.12 (MR)
unnamed: U108.6 (Q3), U108.13 (CP)
unnamed: U127.6, U128.5 (D1)
unnamed: U128.2 (Q0), U128.13 (D3)
PBUS_{DIR}: U99.18 (I/~O_{7})
PD0: U61.30 (DB0), U104.8 (D3)
PD1: U61.29 (DB1), U104.4 (D1)
PD2: U61.28 (DB2), U104.3 (D0)
PD3: U61.27 (DB3), U104.7 (D2)
PD4: U61.26 (DB4), U104.13 (D4)
PD5: U61.23 (DB5), U104.14 (D5)
PD6: U61.22 (DB6), U104.17 (D6)
PD7: U61.21 (DB7), U104.18 (D7)
RESET_{BRD}: U61.13 (RESET)
T/C: U89.6
VMEM_{DECODE_Q}: U99.6 (I_{5})
XA0: U103.8 (A6)
XA1: U103.9 (A7)
XA2: U103.7 (A5)
XA3: U103.6 (A4)
XA4: U103.5 (A3)
XA5: U103.4 (A2)
XA6: U103.3 (A1)
XA7: U103.2 (A0)
XA8: U104.9 (O3)
XA9: U104.5 (O1)
XA10: U104.2 (O0)
XA11: U104.6 (O2)
XA12: U104.12 (O4)
XA13: U104.15 (O5)
XA14: U104.16 (O6)
XA15: U104.19 (O7)
~88_PRIMARY: U99.3 (I_{2})
~8237_{CS}: U61.11 (~CS)
~BUS_WAIT: U99.13 (I/~O_{2}), U127.13
~DCON_{P2}: U99.2 (I_{1})
~DMA_AEN: U89.8, U103.1 (A->B), U104.1 (OE)
~IOS_TO_DCON: U99.4 (I_{3})
~KBD_SHIFT_{CLK}: U128.14 (~Q3)
~PBUS_{OE}: U99.19 (I/~O_{8})
~XIOR: R12.2 (R1.2), U61.1 (~IOR), U99.5 (I_{4})
~XIOW: R12.3 (R2.2), U61.2 (~IOW)
~XMEMR: R12.4 (R3.2), U61.3 (~MEMR)
~XMEMW: R12.5 (R4.2), U61.4 (~MEMW)

Notes on the sheet:
The 8259's address pins sit behind this bus driver as the 8259 emits the lower 8 bits of the DMA address during operation. When DMA is not operating, the buffer drives the XA bus toward the DMA controller's address lines. When the DMA controller is operating, the buffer drives the DMA controller's 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
This 4-bit counter divides DCLK by 4 to produce DRAM refresh timings.
Bodge wiring. Seequa added two bodge wires between the termination resistors on DMA_AD0 & DMA_AD1 and ran them over to the video unit, cutting the original XA0 and XA1 traces. I hsve called these new adress lines "XAT" or XA-terminated; additionally I have added a termination resistor for AD2 as we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
