dbalsom/seequa_chameleon/kicad/expansion_headers.kicad_sch

## KiCad design kicad/expansion_headers.kicad_sch (2026-05-13)

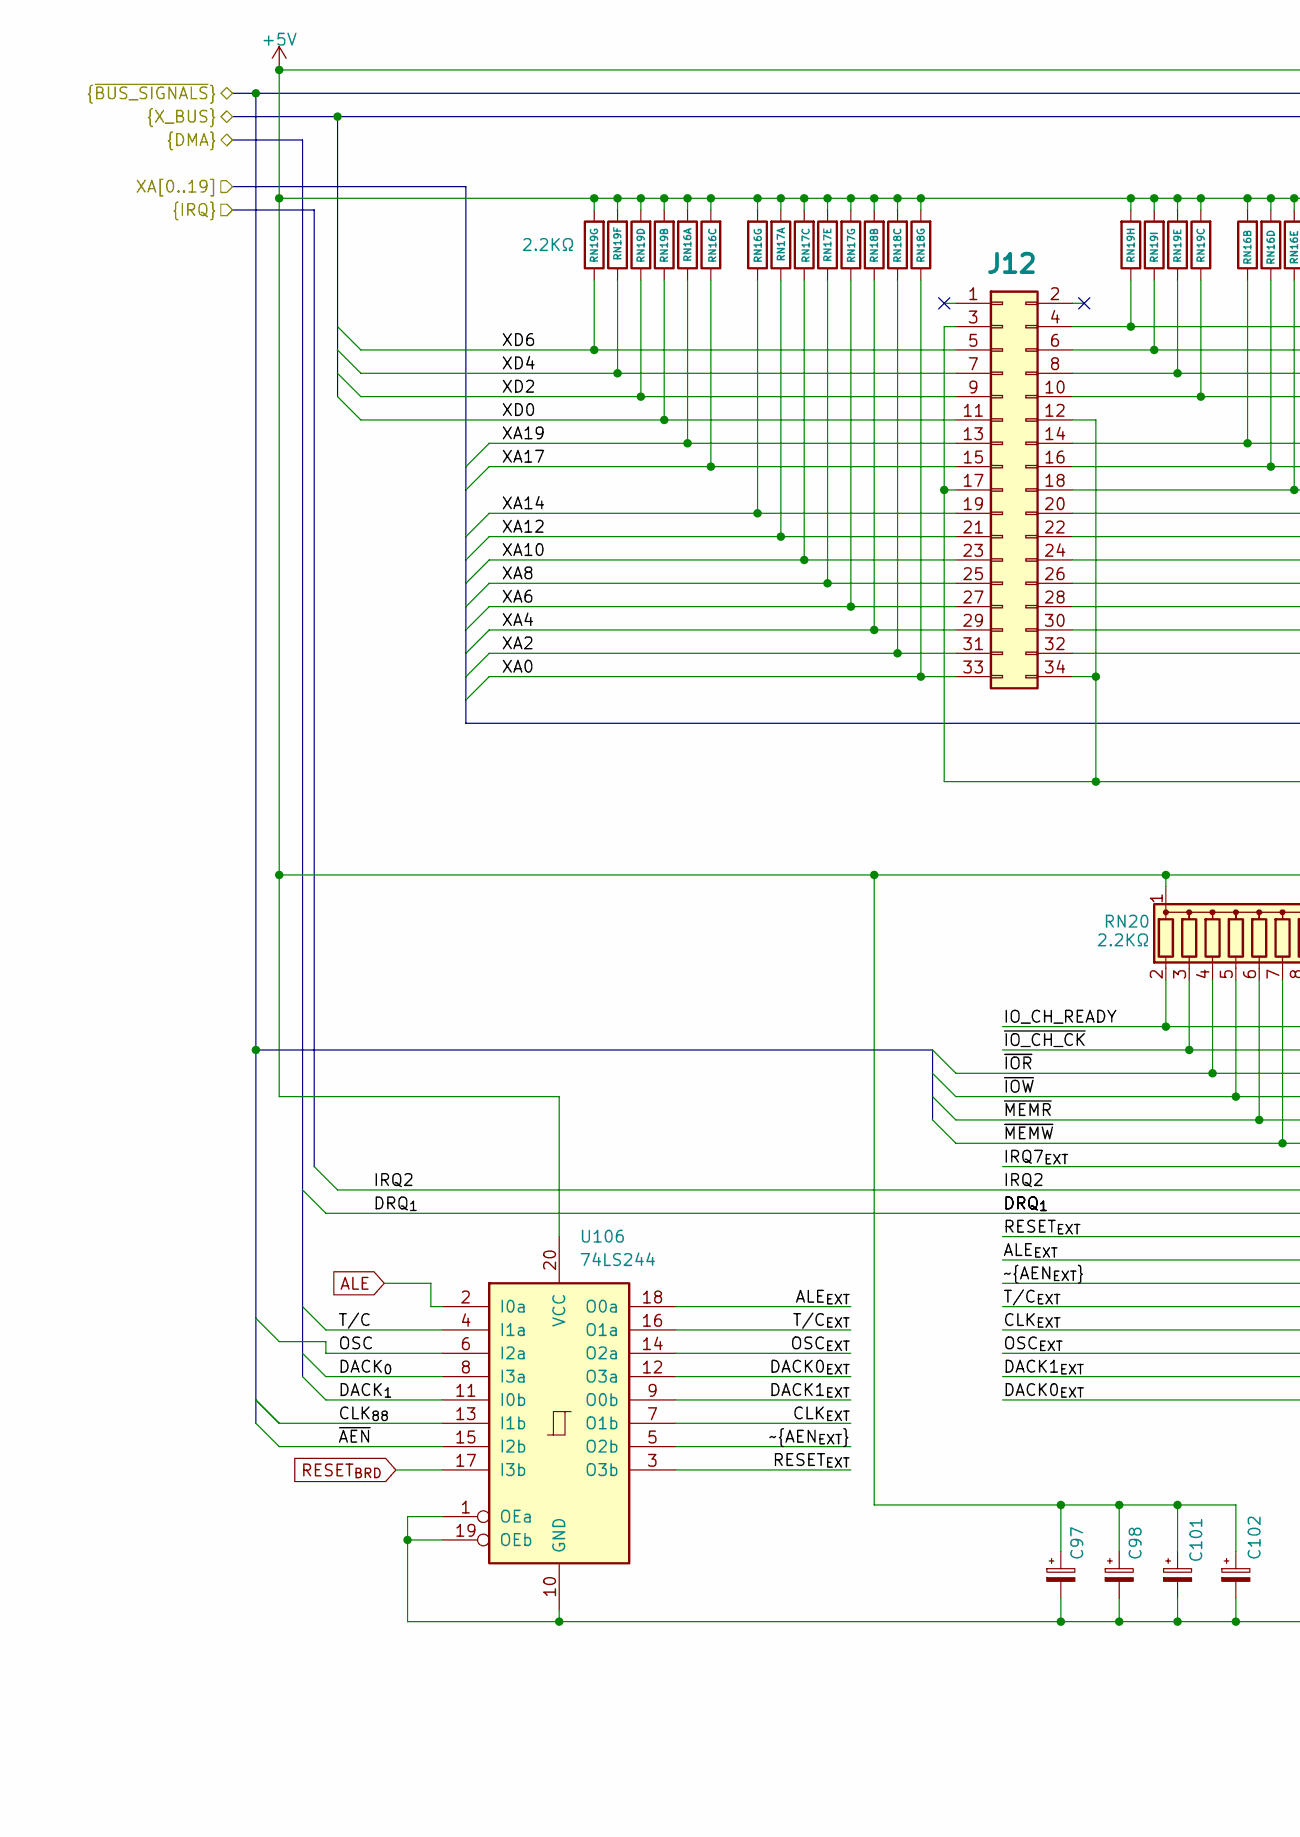
[picture p17: schematic expansion_headers.kicad_sch, part in row 1, column 1]

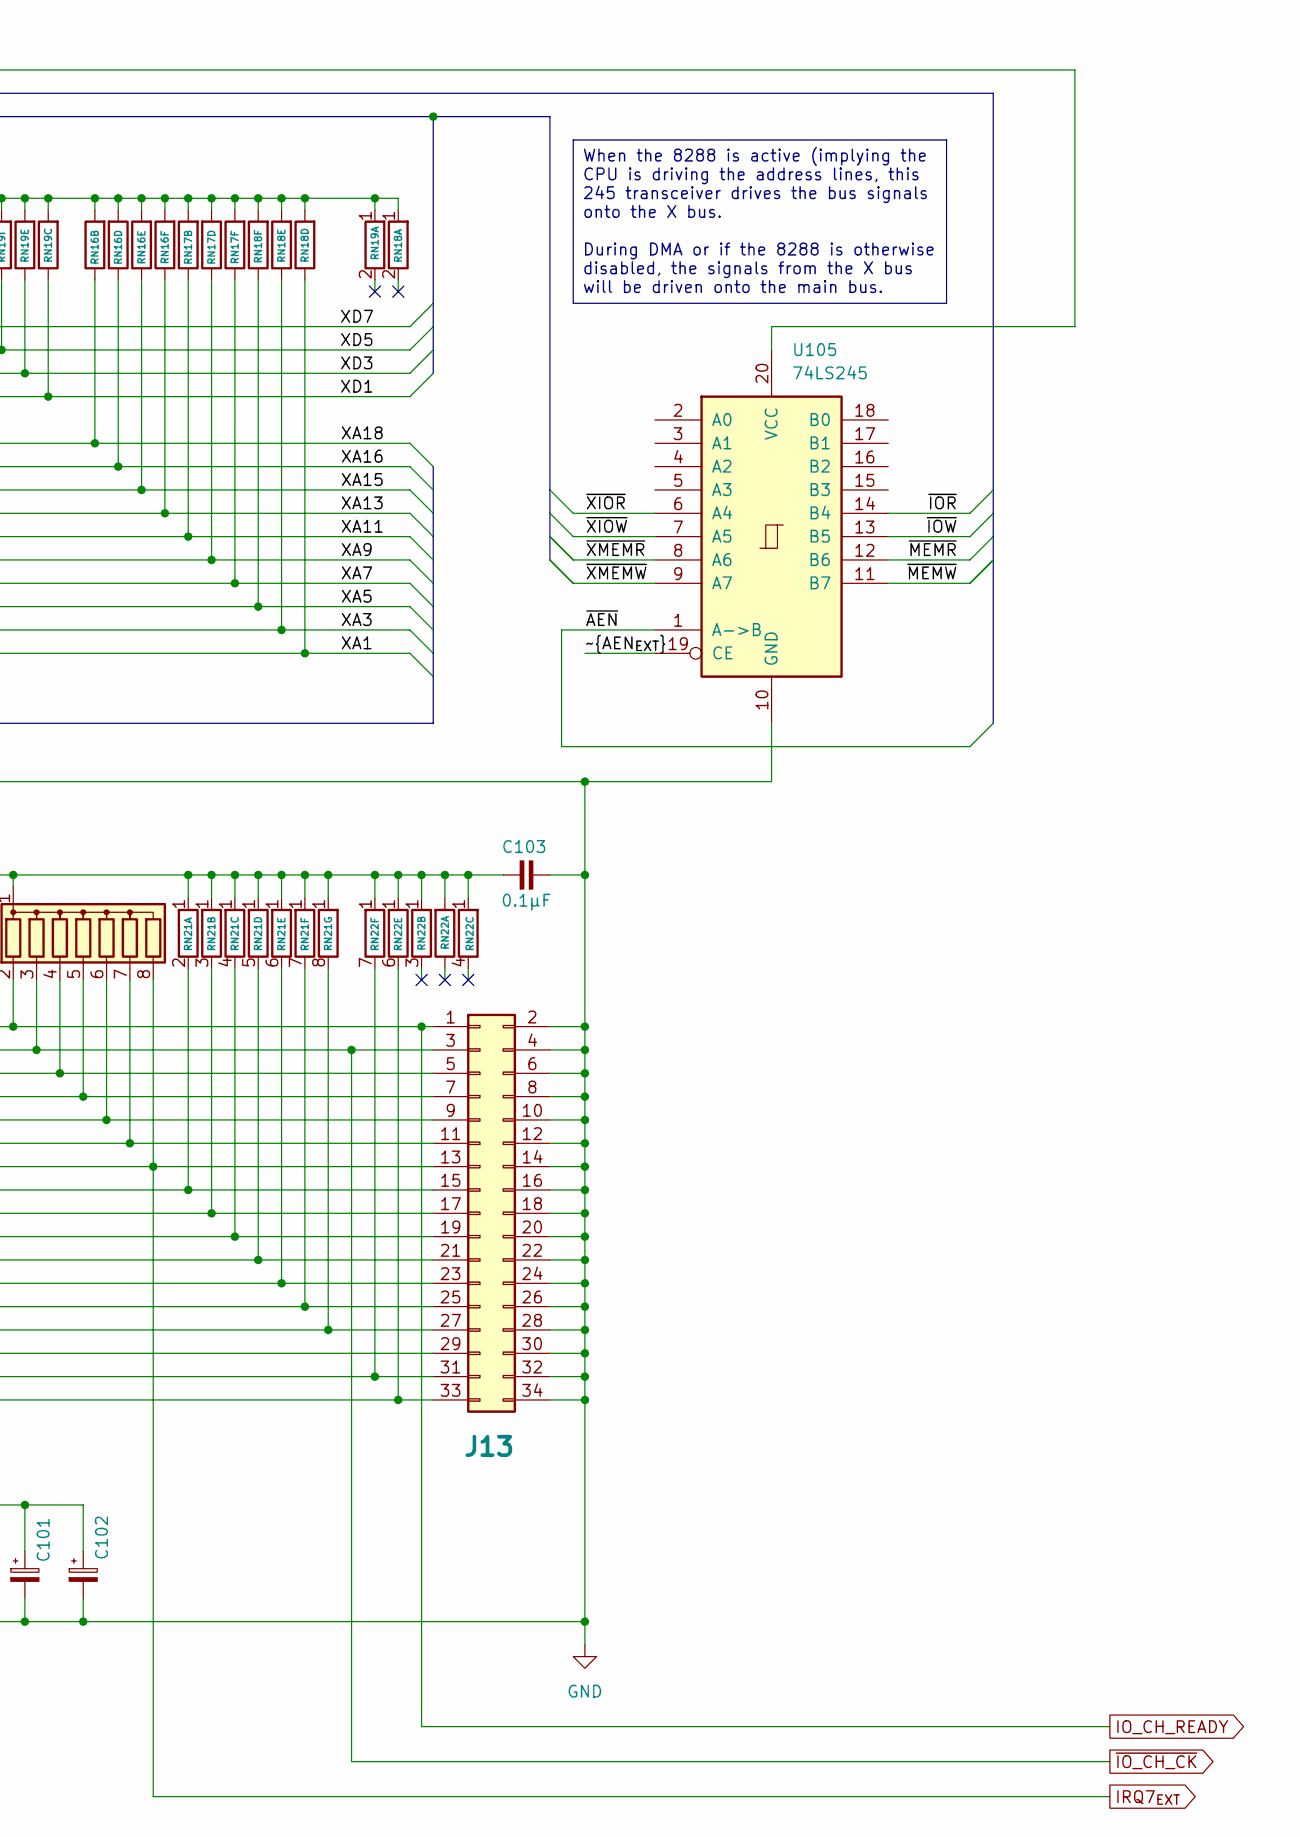
[picture p18: schematic expansion_headers.kicad_sch, part in row 1, column 2]

Parts:
C97, C98, C101, C102: C_Bypass_2.54mm; C_Seequa_Bypass_2.54mm
C103: 0.1μF; C_Seequa_Bypass_2.54mm
J12, J13: Conn_02x17_Odd_Even; PinHeader_2x17_P2.54mm_Vertical
RN16, RN18, RN21, RN22: 2.2K; R_Array_SIP8
RN17, RN20: 2.2KΩ; R_Array_SIP8
RN19: 2.2KΩ; R_Array_SIP10
U105: 74LS245; DIP-20_W7.62mm
U106: 74LS244; DIP-20_W7.62mm

Connections:
+5V: C97.1, C98.1, C101.1, C102.1, C103.1, RN16.1 (R1), RN17.1 (R1), RN18.1 (R1), RN19.1 (R1), RN20.1 (common), RN21.1 (R1), RN22.1 (R1), U105.20 (VCC), U106.20 (VCC)
ALE: U106.2 (I0a)
ALE_{EXT}: J13.21, RN21.5 (R4.2), U106.18 (O0a)
CLK_{88}: U106.13 (I1b)
CLK_{EXT}: J13.27, RN21.8 (R7.2), U106.7 (O1b)
DACK0_{EXT}: J13.33, RN22.6 (R5.2), U106.12 (O3a)
DACK1_{EXT}: J13.31, RN22.7 (R6.2), U106.9 (O0b)
DACK_{0}: U106.8 (I3a)
DACK_{1}: U106.11 (I0b)
DRQ_{1}: J13.17, RN21.3 (R2.2)
GND: C97.2, C98.2, C101.2, C102.2, C103.2, J12.3, J12.12, J12.17, J12.34, J13.2, J13.4, J13.6, J13.8, J13.10, J13.12, J13.14, J13.16, J13.18, J13.20, J13.22, J13.24, J13.26, J13.28, J13.30, J13.32, J13.34, U105.10 (GND), U106.1 (OEa), U106.10 (GND), U106.19 (OEb)
IO_CH_READY: J13.1, RN20.2 (R1)
IRQ2: J13.15, RN21.2 (R1.2)
IRQ7_{EXT}: J13.13, RN20.8 (R7)
OSC: U106.6 (I2a)
OSC_{EXT}: J13.29, U106.14 (O2a)
RESET_{BRD}: U106.17 (I3b)
RESET_{EXT}: J13.19, RN21.4 (R3.2), U106.3 (O3b)
T/C_{EXT}: J13.25, RN21.7 (R6.2), U106.16 (O1a)
T/C: U106.4 (I1a)
XA0: J12.33, RN18.8 (R7.2)
XA1: J12.32, RN18.5 (R4.2)
XA2: J12.31, RN18.4 (R3.2)
XA3: J12.30, RN18.6 (R5.2)
XA4: J12.29, RN18.3 (R2.2)
XA5: J12.28, RN18.7 (R6.2)
XA6: J12.27, RN17.8 (R7.2)
XA7: J12.26, RN17.7 (R6.2)
XA8: J12.25, RN17.6 (R5.2)
XA9: J12.24, RN17.5 (R4.2)
XA10: J12.23, RN17.4 (R3.2)
XA11: J12.22, RN17.3 (R2.2)
XA12: J12.21, RN17.2 (R1.2)
XA13: J12.20, RN16.7 (R6.2)
XA14: J12.19, RN16.8 (R7.2)
XA15: J12.18, RN16.6 (R5.2)
XA16: J12.16, RN16.5 (R4.2)
XA17: J12.15, RN16.4 (R3.2)
XA18: J12.14, RN16.3 (R2.2)
XA19: J12.13, RN16.2 (R1.2)
XD0: J12.11, RN19.3 (R2.2)
XD1: J12.10, RN19.4 (R3.2)
XD2: J12.9, RN19.5 (R4.2)
XD3: J12.8, RN19.6 (R5.2)
XD4: J12.7, RN19.7 (R6.2)
XD5: J12.6, RN19.10 (R9.2)
XD6: J12.5, RN19.8 (R7.2)
XD7: J12.4, RN19.9 (R8.2)
~AEN_{EXT}: J13.23, RN21.6 (R5.2), U105.19 (CE), U106.5 (O2b)
~AEN: U105.1 (A->B), U106.15 (I2b)
~IOR: J13.5, RN20.4 (R3), U105.14 (B4)
~IOW: J13.7, RN20.5 (R4), U105.13 (B5)
~IO_CH_CK: J13.3, RN20.3 (R2)
~MEMR: J13.9, RN20.6 (R5), U105.12 (B6)
~MEMW: J13.11, RN20.7 (R6), U105.11 (B7)
~XIOR: U105.6 (A4)
~XIOW: U105.7 (A5)
~XMEMR: U105.8 (A6)
~XMEMW: U105.9 (A7)

Notes on the sheet:
When the 8288 is active (implying the CPU is driving the address lines, this 245 transceiver drives the bus signals onto the X bus. During DMA or if the 8288 is otherwise disabled, the signals from the X bus will be driven onto the main bus.
