dbalsom/seequa_chameleon/kicad/fdc.kicad_sch

## KiCad design kicad/fdc.kicad_sch (2026-05-13)

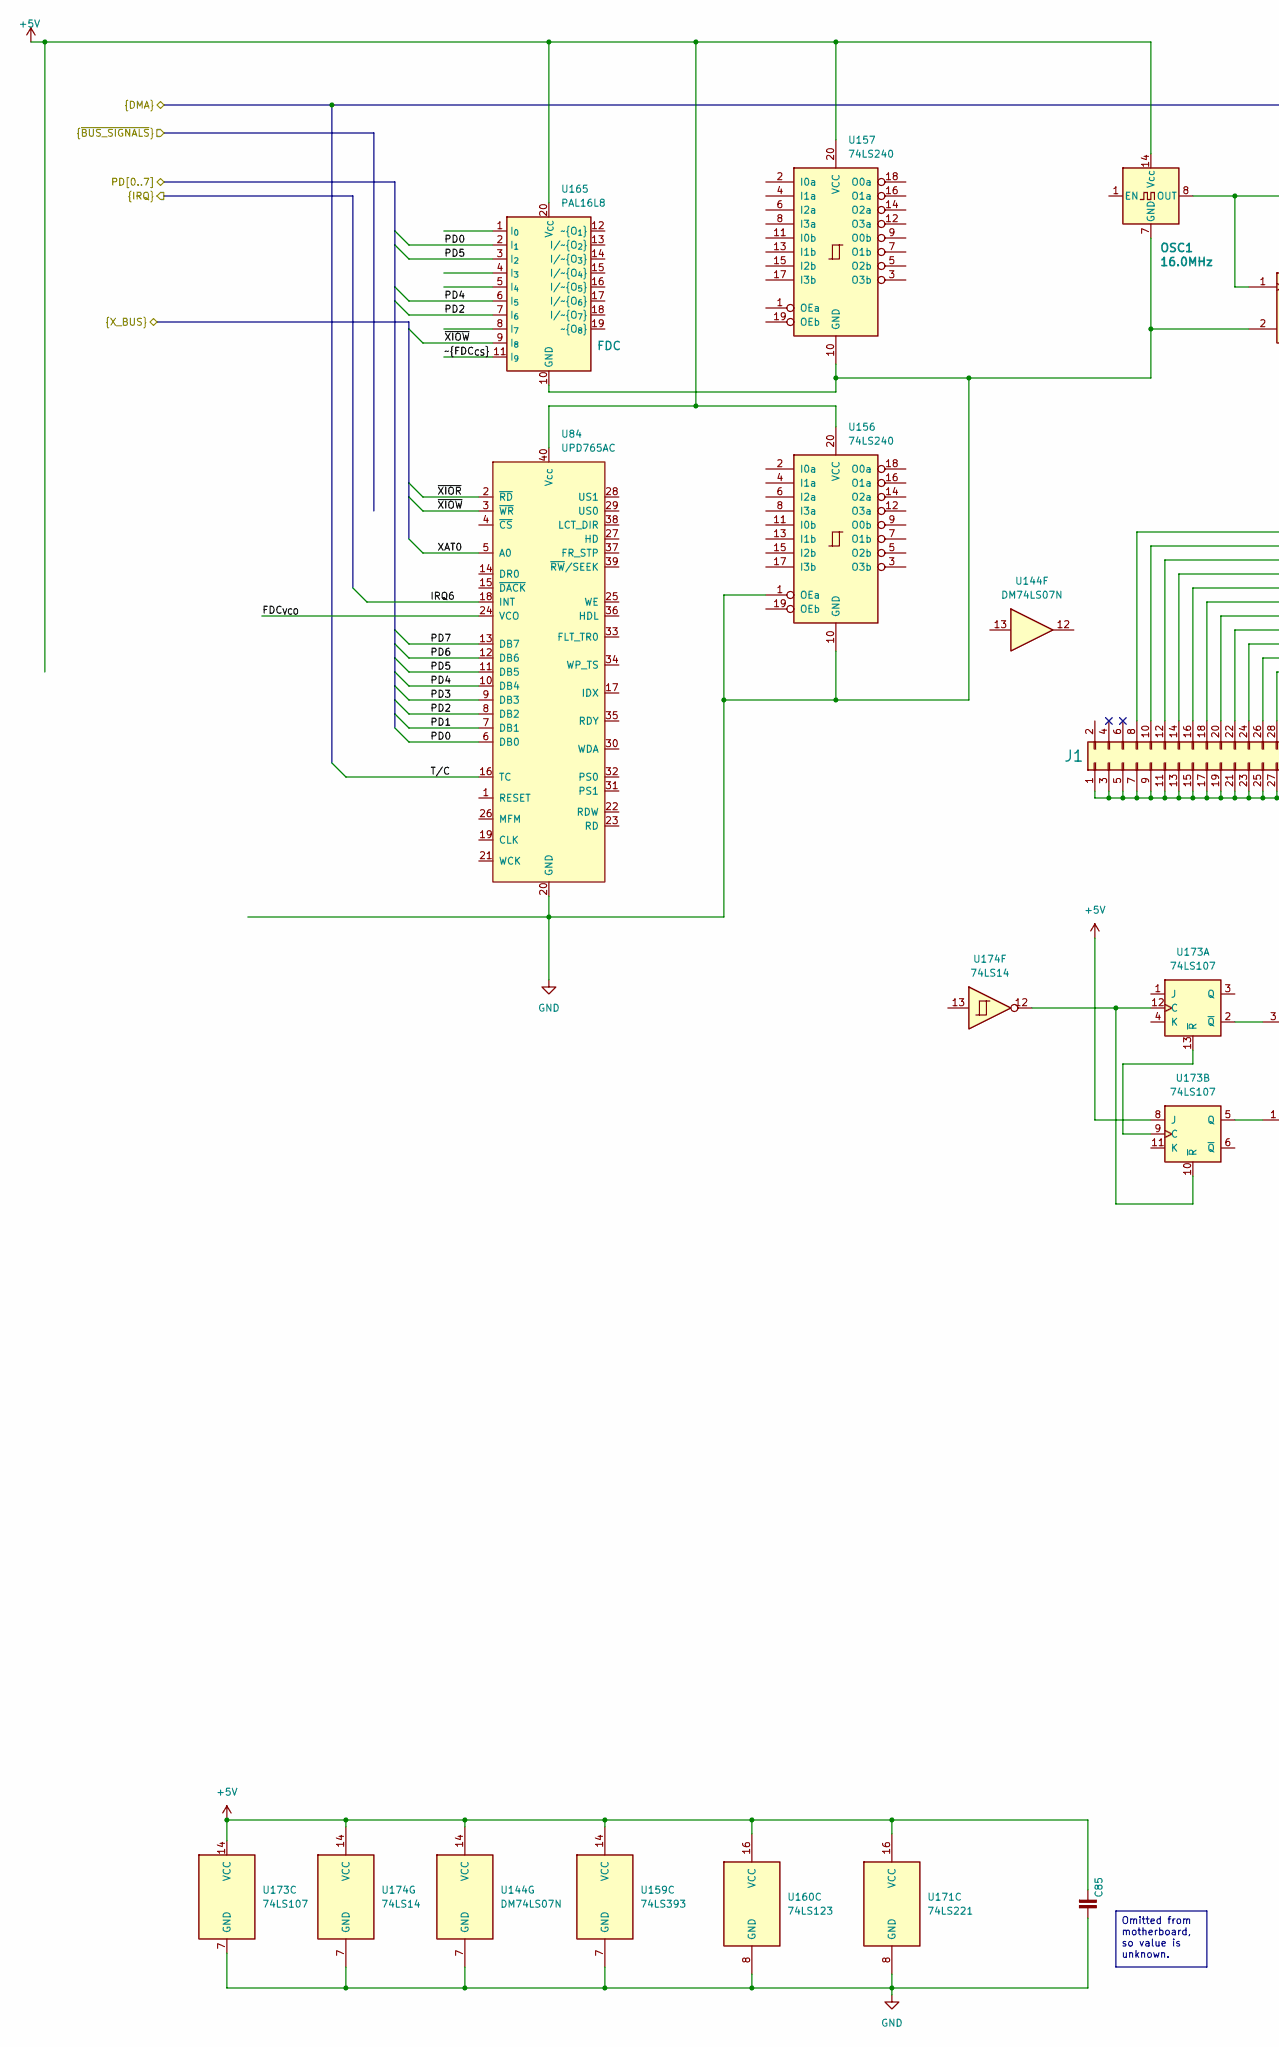
[picture p19: schematic fdc.kicad_sch, part in row 1, column 1]

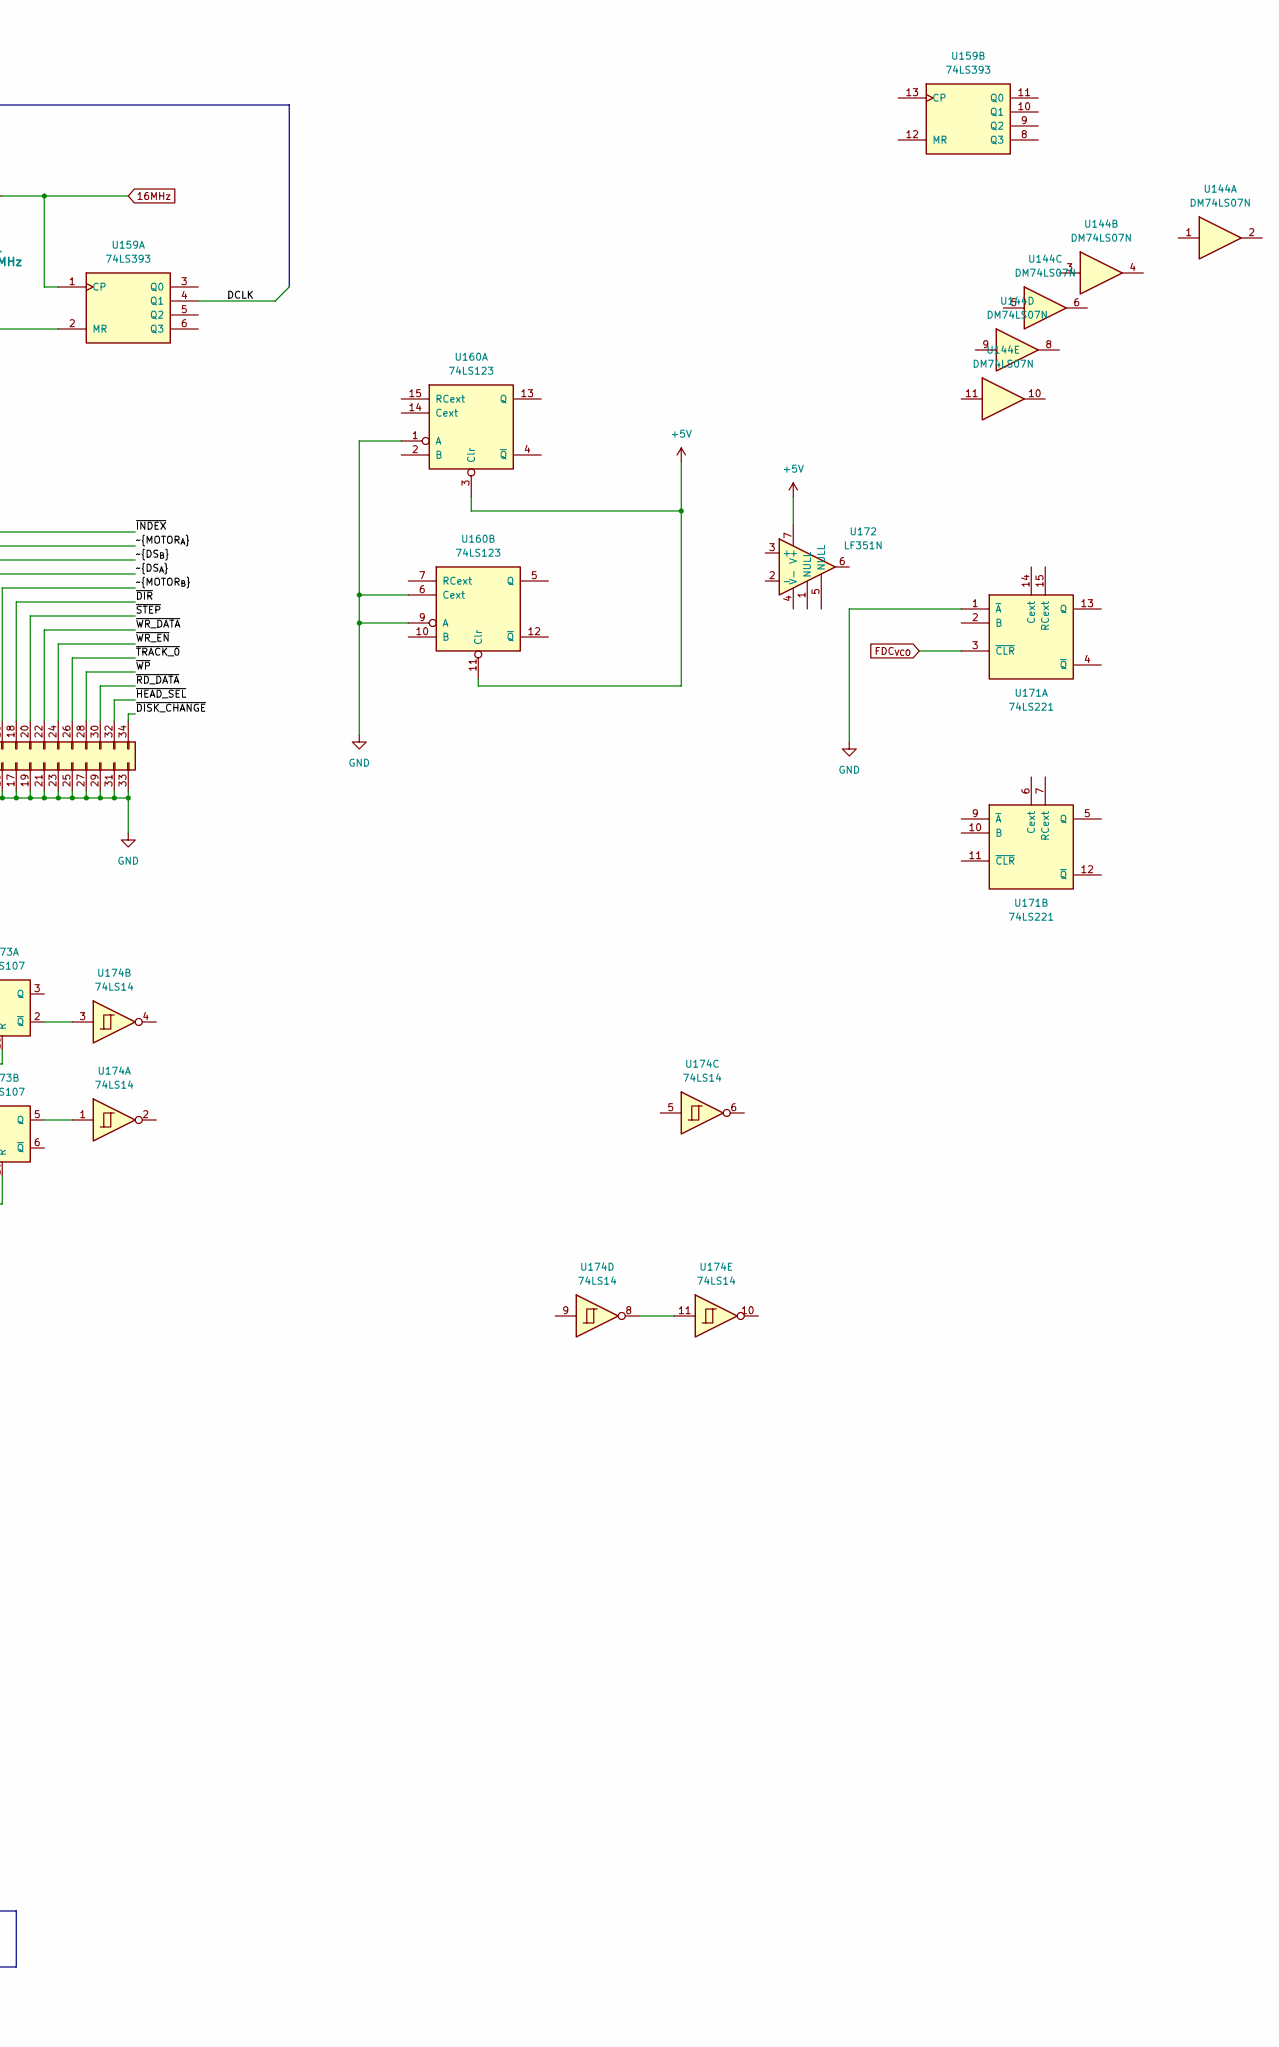
[picture p20: schematic fdc.kicad_sch, part in row 1, column 2]

Parts:
C85: C_Bypass_5mm; C_Seequa_Bypass_Film_5mm
J1: Conn_02x17_Odd_Even; PinHeader_2x17_P2.54mm_Vertical
OSC1: 16.0MHz; Oscillator_DIP-14
U84: UPD765AC; DIP-40_W15.24mm
U144: DM74LS07N; DIP-14_W7.62mm
U156, U157: 74LS240; DIP-20_W7.62mm
U159: 74LS393; DIP-14_W7.62mm
U160: 74LS123; DIP-16_W7.62mm
U165: PAL16L8; DIP-20_W7.62mm
U171: 74LS221; DIP-16_W7.62mm
U172: LF351N; DIP-8_W7.62mm
U173: 74LS107; DIP-14_W7.62mm
U174: 74LS14; DIP-14_W7.62mm

Connections:
16MHz: OSC1.8 (OUT), U159.1 (CP)
+5V: C85.1, OSC1.14 (Vcc), U84.40 (Vcc), U144.14 (VCC), U156.20 (VCC), U157.20 (VCC), U159.14 (VCC), U160.3 (Clr), U160.11 (Clr), U160.16 (VCC), U165.20 (V_{CC}), U171.16 (VCC), U172.7 (V+), U173.8 (J), U173.14 (VCC), U174.14 (VCC)
DCLK: U159.4 (Q1)
FDC_{VCO}: U84.24 (VCO), U171.3 (~CLR)
GND: C85.2, J1.1, J1.3, J1.5, J1.7, J1.9, J1.11, J1.13, J1.15, J1.17, J1.19, J1.21, J1.23, J1.25, J1.27, J1.29, J1.31, J1.33, OSC1.7 (GND), U84.20 (GND), U144.7 (GND), U156.1 (OEa), U156.10 (GND), U157.10 (GND), U159.2 (MR), U159.7 (GND), U160.1 (A), U160.6 (Cext), U160.8 (GND), U160.9 (A), U165.10 (GND), U171.1 (~A), U171.8 (GND), U173.7 (GND), U174.7 (GND)
IRQ6: U84.18 (INT)
unnamed: U173.2 (~Q), U174.3
unnamed: U173.5 (Q), U174.1
unnamed: U173.10 (~R), U173.12 (C), U174.12
unnamed: U173.9 (C), U173.13 (~R)
unnamed: U174.8, U174.11
PD0: U84.6 (DB0), U165.2 (I_{1})
PD1: U84.7 (DB1)
PD2: U84.8 (DB2), U165.7 (I_{6})
PD3: U84.9 (DB3)
PD4: U84.10 (DB4), U165.6 (I_{5})
PD5: U84.11 (DB5), U165.3 (I_{2})
PD6: U84.12 (DB6)
PD7: U84.13 (DB7)
T/C: U84.16 (TC)
XAT0: U84.5 (A0)
~DIR: J1.18
~DISK_CHANGE: J1.34
~DS_{A}: J1.14
~DS_{B}: J1.12
~FDC_{CS}: U165.11 (I_{9})
~HEAD_SEL: J1.32
~INDEX: J1.8
~MOTOR_{A}: J1.10
~MOTOR_{B}: J1.16
~RD_DATA: J1.30
~STEP: J1.20
~TRACK_0: J1.26
~WP: J1.28
~WR_DATA: J1.22
~WR_EN: J1.24
~XIOR: U84.2 (~RD)
~XIOW: U84.3 (~WR), U165.9 (I_{8})

Notes on the sheet:
Omitted from motherboard, so value is unknown.
