dbalsom/seequa_chameleon/kicad/font_sram.kicad_sch

## KiCad design kicad/font_sram.kicad_sch (2026-02-28)

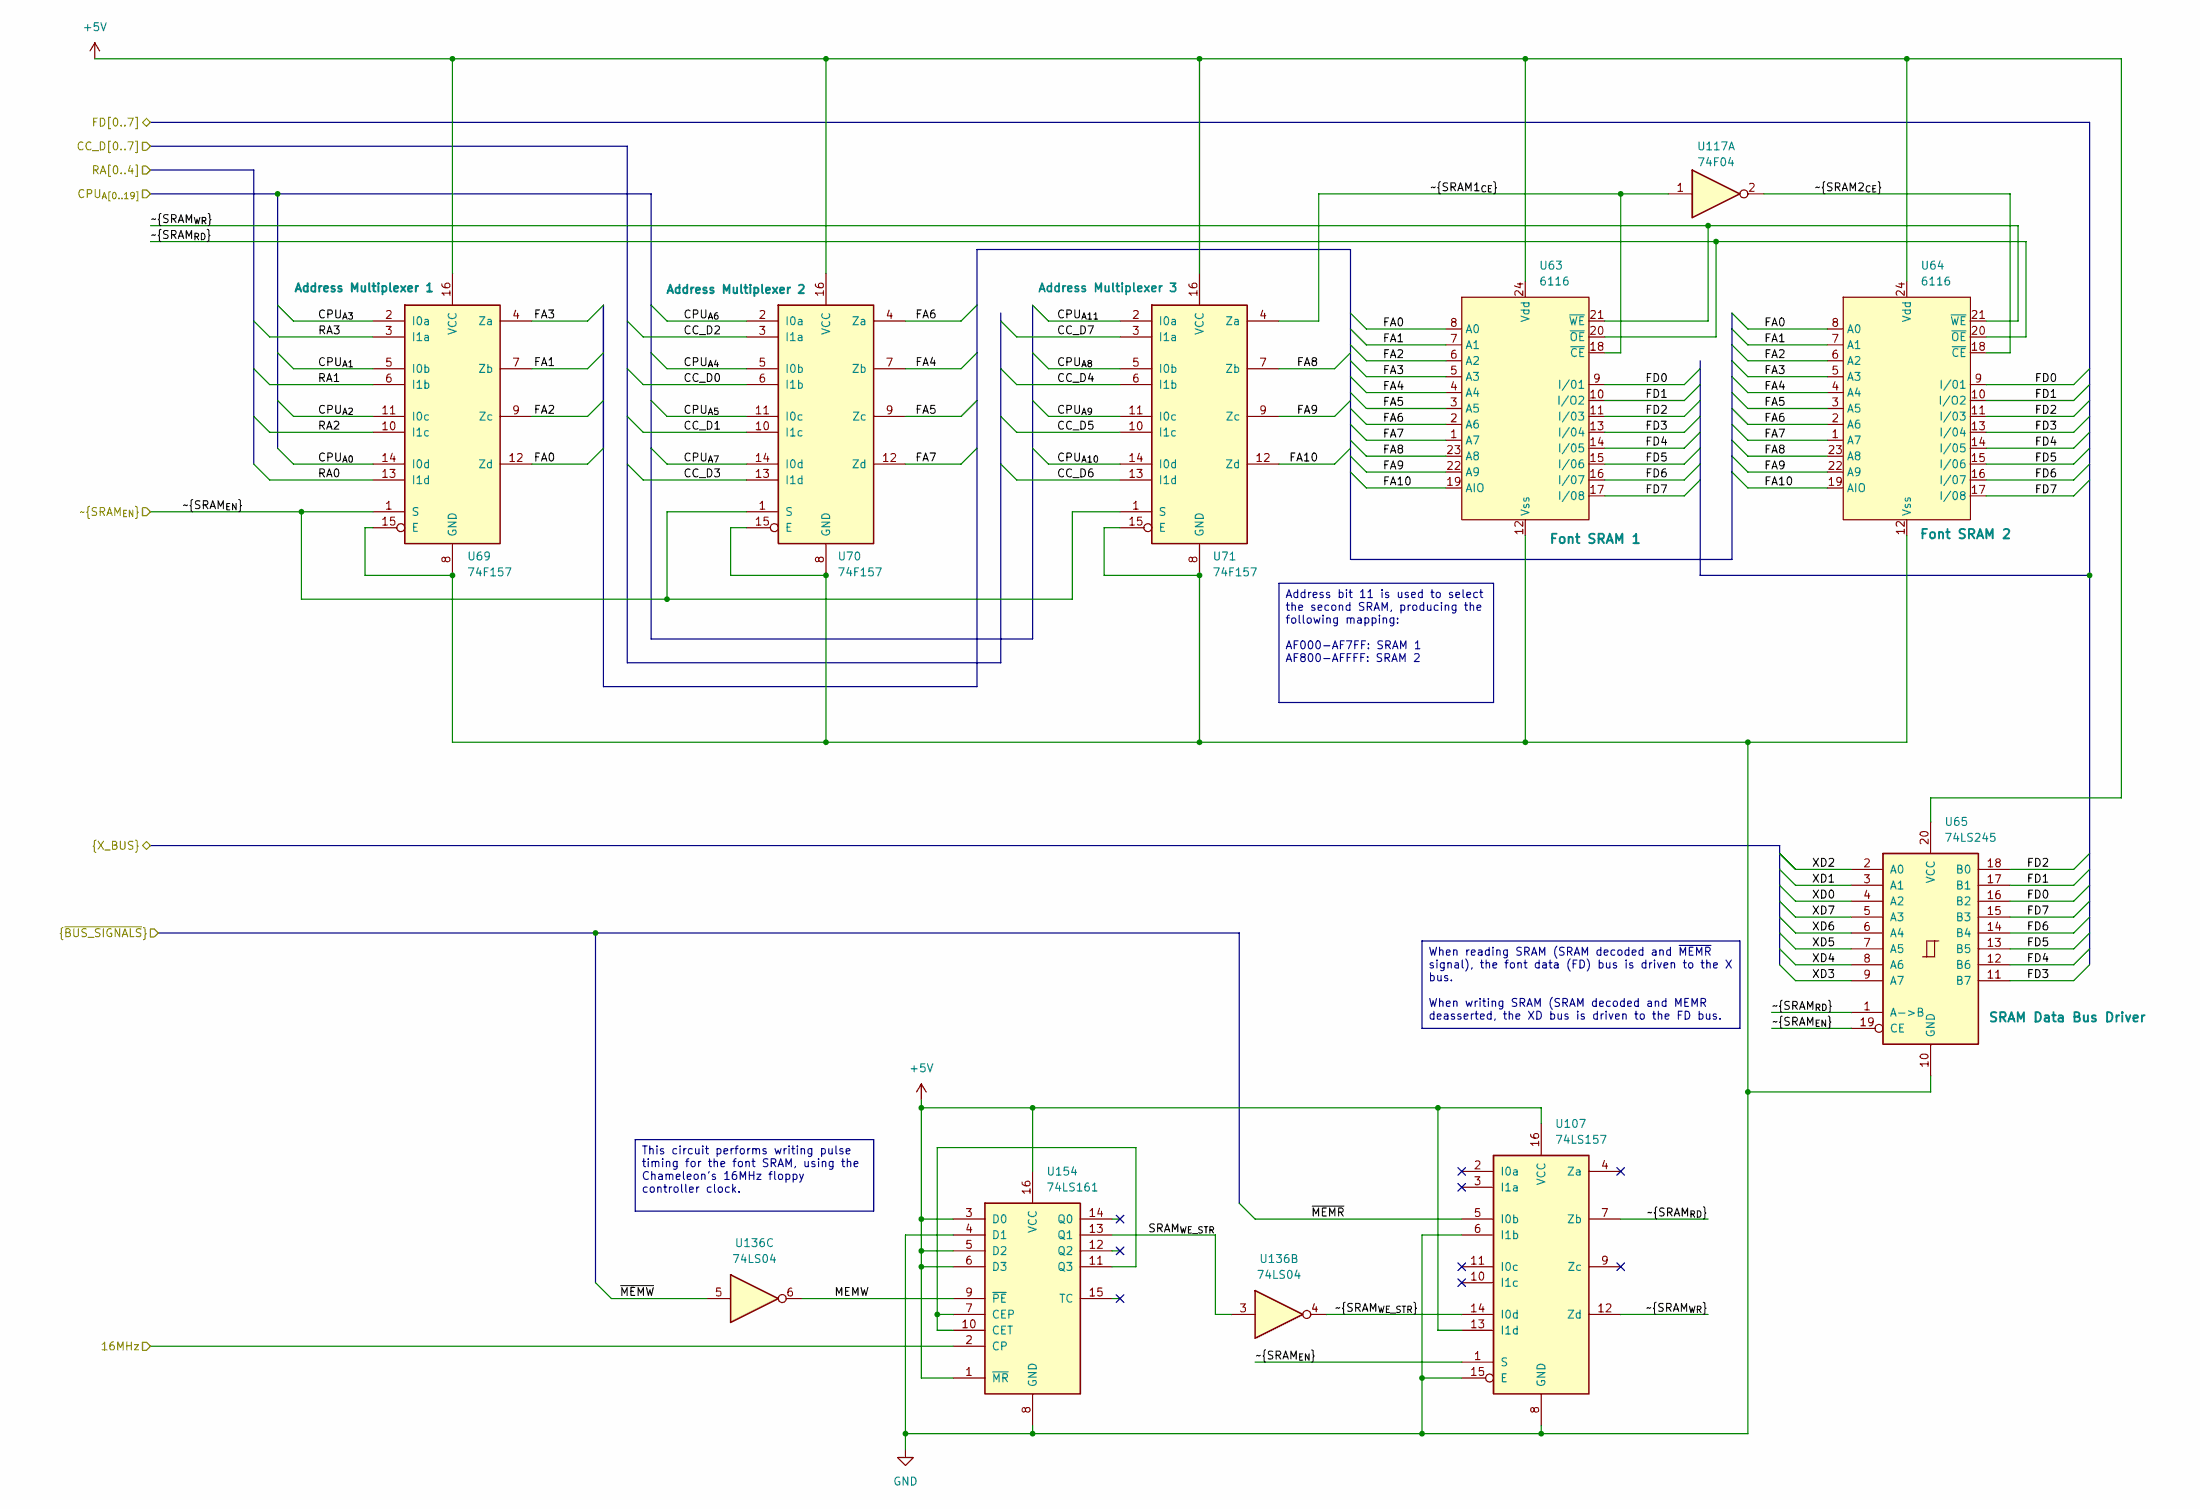
[picture p21: schematic font_sram.kicad_sch]

Parts:
U63, U64: 6116; DIP-24_W15.24mm
U65: 74LS245; DIP-20_W7.62mm
U69, U70, U71: 74F157; DIP-16_W7.62mm
U107: 74LS157; DIP-16_W7.62mm
U117: 74F04; DIP-14_W7.62mm
U136: 74LS04; DIP-14_W7.62mm
U154: 74LS161; DIP-16_W7.62mm

Connections:
16MHz: U154.2 (CP)
+5V: U63.24 (Vdd), U64.24 (Vdd), U65.20 (VCC), U69.16 (VCC), U70.16 (VCC), U71.16 (VCC), U107.13 (I1d), U107.16 (VCC), U154.1 (~MR), U154.3 (D0), U154.5 (D2), U154.6 (D3), U154.16 (VCC)
CC_D0: U70.6 (I1b)
CC_D1: U70.10 (I1c)
CC_D2: U70.3 (I1a)
CC_D3: U70.13 (I1d)
CC_D4: U71.6 (I1b)
CC_D5: U71.10 (I1c)
CC_D6: U71.13 (I1d)
CC_D7: U71.3 (I1a)
CPU_{A0}: U69.14 (I0d)
CPU_{A1}: U69.5 (I0b)
CPU_{A2}: U69.11 (I0c)
CPU_{A3}: U69.2 (I0a)
CPU_{A4}: U70.5 (I0b)
CPU_{A5}: U70.11 (I0c)
CPU_{A6}: U70.2 (I0a)
CPU_{A7}: U70.14 (I0d)
CPU_{A8}: U71.5 (I0b)
CPU_{A9}: U71.11 (I0c)
CPU_{A10}: U71.14 (I0d)
CPU_{A11}: U71.2 (I0a)
FA0: U63.8 (A0), U64.8 (A0), U69.12 (Zd)
FA1: U63.7 (A1), U64.7 (A1), U69.7 (Zb)
FA2: U63.6 (A2), U64.6 (A2), U69.9 (Zc)
FA3: U63.5 (A3), U64.5 (A3), U69.4 (Za)
FA4: U63.4 (A4), U64.4 (A4), U70.7 (Zb)
FA5: U63.3 (A5), U64.3 (A5), U70.9 (Zc)
FA6: U63.2 (A6), U64.2 (A6), U70.4 (Za)
FA7: U63.1 (A7), U64.1 (A7), U70.12 (Zd)
FA8: U63.23 (A8), U64.23 (A8), U71.7 (Zb)
FA9: U63.22 (A9), U64.22 (A9), U71.9 (Zc)
FA10: U63.19 (AIO), U64.19 (AIO), U71.12 (Zd)
FD0: U63.9 (I/01), U64.9 (I/01), U65.16 (B2)
FD1: U63.10 (I/O2), U64.10 (I/O2), U65.17 (B1)
FD2: U63.11 (I/03), U64.11 (I/03), U65.18 (B0)
FD3: U63.13 (I/04), U64.13 (I/04), U65.11 (B7)
FD4: U63.14 (I/05), U64.14 (I/05), U65.12 (B6)
FD5: U63.15 (I/06), U64.15 (I/06), U65.13 (B5)
FD6: U63.16 (I/07), U64.16 (I/07), U65.14 (B4)
FD7: U63.17 (I/08), U64.17 (I/08), U65.15 (B3)
GND: U63.12 (Vss), U64.12 (Vss), U65.10 (GND), U69.8 (GND), U69.15 (E), U70.8 (GND), U70.15 (E), U71.8 (GND), U71.15 (E), U107.6 (I1b), U107.8 (GND), U107.15 (E), U154.4 (D1), U154.8 (GND)
MEMW: U136.6, U154.9 (~PE)
unnamed: U154.7 (CEP), U154.10 (CET), U154.11 (Q3)
RA0: U69.13 (I1d)
RA1: U69.6 (I1b)
RA2: U69.10 (I1c)
RA3: U69.3 (I1a)
SRAM_{WE_STR}: U136.3, U154.13 (Q1)
XD0: U65.4 (A2)
XD1: U65.3 (A1)
XD2: U65.2 (A0)
XD3: U65.9 (A7)
XD4: U65.8 (A6)
XD5: U65.7 (A5)
XD6: U65.6 (A4)
XD7: U65.5 (A3)
~MEMR: U107.5 (I0b)
~MEMW: U136.5
~SRAM1_{CE}: U63.18 (~CE), U71.4 (Za), U117.1
~SRAM2_{CE}: U64.18 (~CE), U117.2
~SRAM_{EN}: U65.19 (CE), U69.1 (S), U70.1 (S), U71.1 (S), U107.1 (S)
~SRAM_{RD}: U63.20 (~OE), U64.20 (~OE), U65.1 (A->B), U107.7 (Zb)
~SRAM_{WE_STR}: U107.14 (I0d), U136.4
~SRAM_{WR}: U63.21 (~WE), U64.21 (~WE), U107.12 (Zd)

Notes on the sheet:
This circuit performs writing pulse timing for the font SRAM, using the Chameleon's 16MHz floppy controller clock.
Address bit 11 is used to select the second SRAM, producing the following mapping: AF000-AF7FF: SRAM 1 AF800-AFFFF: SRAM 2
When reading SRAM (SRAM decoded and ~{MEMR} signal), the font data (FD) bus is driven to the X bus. When writing SRAM (SRAM decoded and MEMR deasserted, the XD bus is driven to the FD bus.
