dbalsom/seequa_chameleon/kicad/gameport.kicad_sch

## KiCad design kicad/gameport.kicad_sch (2026-05-13)

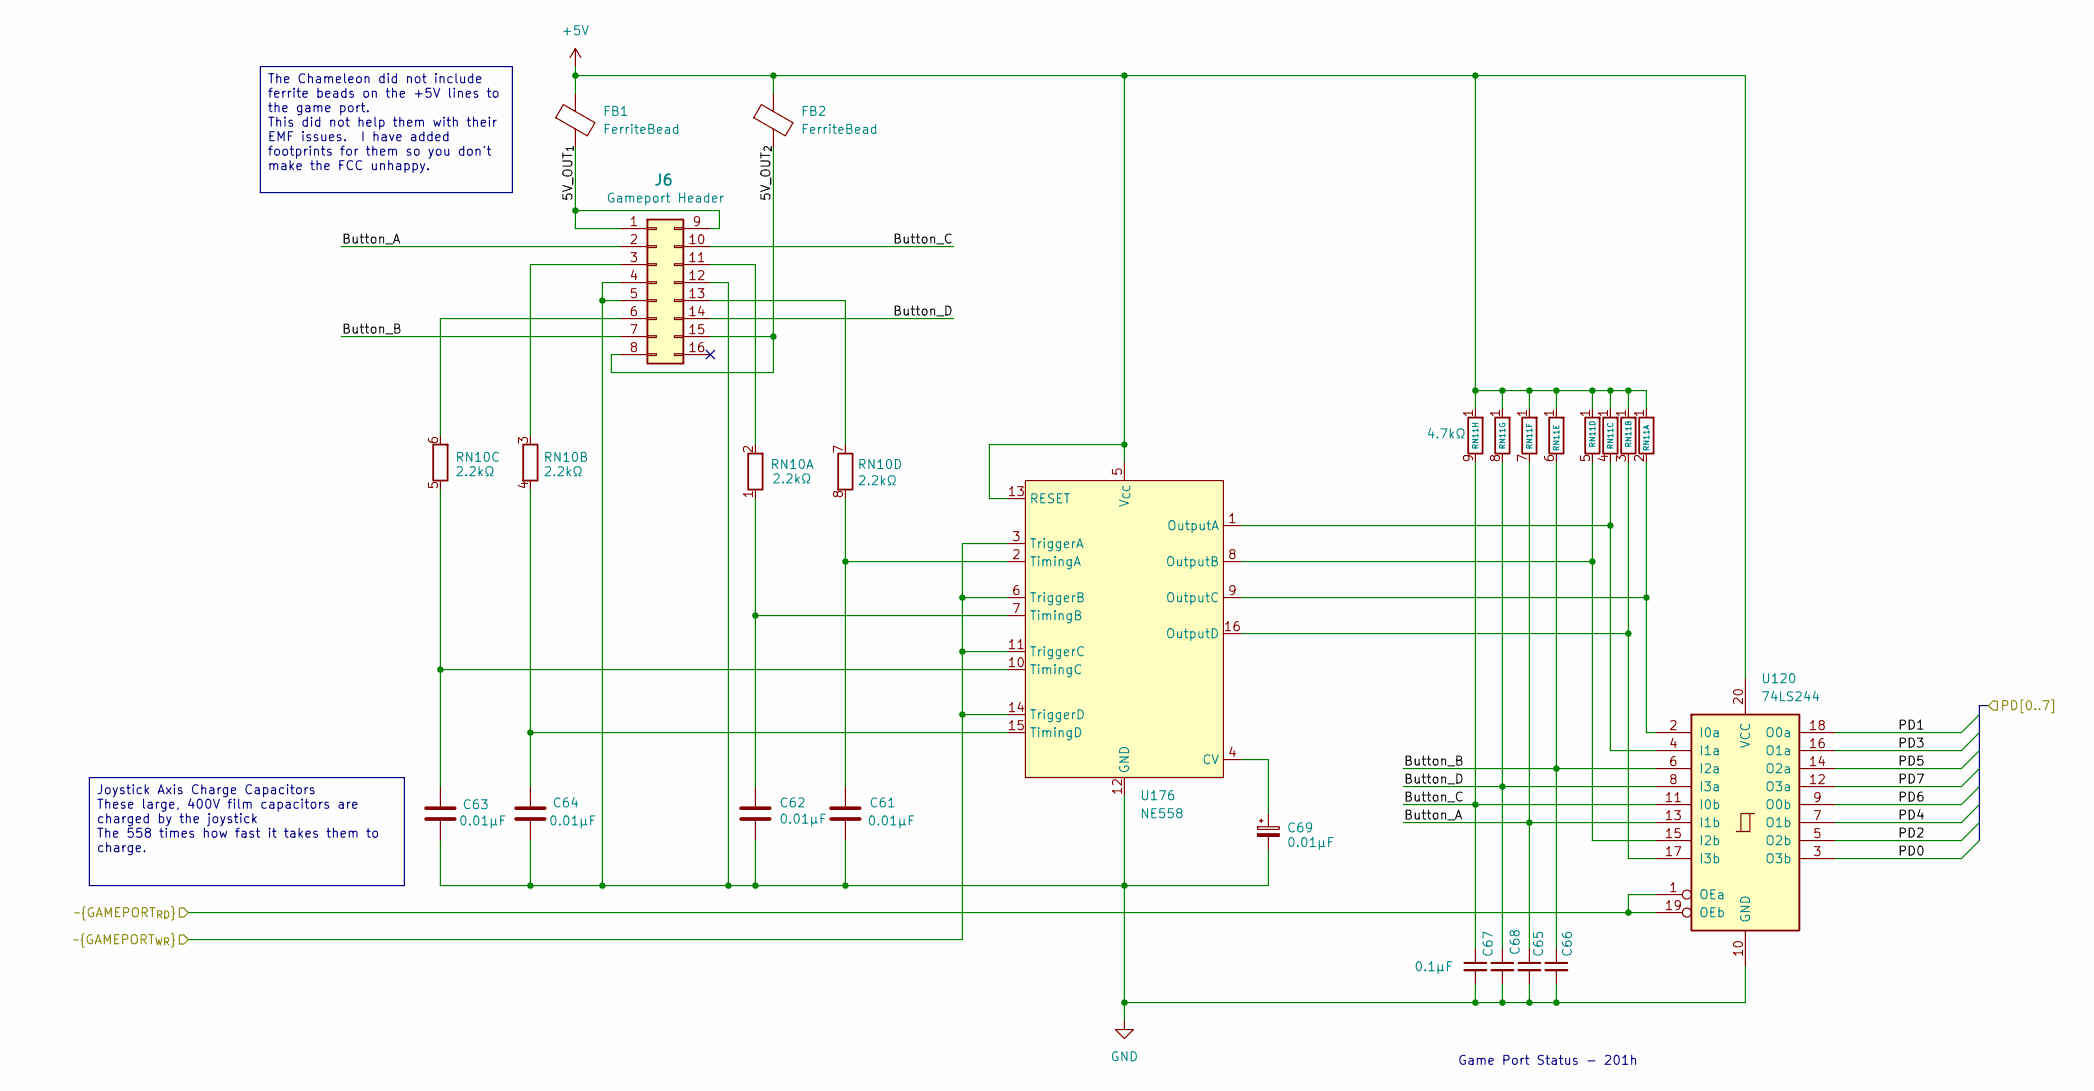
[picture p22: schematic gameport.kicad_sch]

Parts:
C61, C62, C63, C64: 0.01µF; C_Rect_L11.5mm_W2.0mm_P10.00mm_MKT
C65, C66, C68: C_Small; C_Seequa_Clock_Cap_6.35mm
C67: 0.1µF; C_Seequa_Clock_Cap_6.35mm
C69: 0.01µF; C_Seequa_Bypass_3.8mm
FB1, FB2: FerriteBead; L_Axial_L5.3mm_D2.2mm_P7.62mm_Horizontal_Vishay_IM-1
J6: Gameport Header; PinHeader_Gameport_Vertical
RN10: 2.2kΩ; R_Array_SIP8
RN11: 4.7kΩ; R_Array_SIP10
U120: 74LS244; DIP-20_W7.62mm_Socket
U176: NE558; DIP-16_W7.62mm

Connections:
5V_OUT_{1}: FB1.2, J6.1 (+5V), J6.9 (+5V)
5V_OUT_{2}: FB2.2, J6.8 (+5V), J6.15 (+5V)
+5V: FB1.1, FB2.1, RN11.1 (R1), U120.20 (VCC), U176.5 (V_{CC}), U176.13 (RESET)
Button_A: C65.1, J6.2 (Button_A), RN11.7 (R6.2), U120.13 (I1b)
Button_B: C66.1, J6.7 (Button_B), RN11.6 (R5.2), U120.6 (I2a)
Button_C: C67.1, J6.10 (Button_C), RN11.9 (R8.2), U120.11 (I0b)
Button_D: C68.1, J6.14 (Button_D), RN11.8 (R7.2), U120.8 (I3a)
GND: C61.2, C62.2, C63.2, C64.2, C65.2, C66.2, C67.2, C68.2, C69.2, J6.4 (GND), J6.5 (GND), J6.12 (GND), U120.10 (GND), U176.12 (GND)
unnamed: C61.1, RN10.8 (R4.2), U176.2 (TimingA)
unnamed: C62.1, RN10.1 (R1.1), U176.7 (TimingB)
unnamed: C63.1, RN10.5 (R3.1), U176.10 (TimingC)
unnamed: C64.1, RN10.4 (R2.2), U176.15 (TimingD)
unnamed: C69.1, U176.4 (CV)
unnamed: J6.3 (Position_A), RN10.3 (R2.1)
unnamed: J6.6 (Position_B), RN10.6 (R3.2)
unnamed: J6.11 (Position_C), RN10.2 (R1.2)
unnamed: J6.13 (Position_D), RN10.7 (R4.1)
unnamed: RN11.2 (R1.2), U120.2 (I0a), U176.9 (OutputC)
unnamed: RN11.3 (R2.2), U120.17 (I3b), U176.16 (OutputD)
unnamed: RN11.4 (R3.2), U120.4 (I1a), U176.1 (OutputA)
unnamed: RN11.5 (R4.2), U120.15 (I2b), U176.8 (OutputB)
PD0: U120.3 (O3b)
PD1: U120.18 (O0a)
PD2: U120.5 (O2b)
PD3: U120.16 (O1a)
PD4: U120.7 (O1b)
PD5: U120.14 (O2a)
PD6: U120.9 (O0b)
PD7: U120.12 (O3a)
~GAMEPORT_{RD}: U120.1 (OEa), U120.19 (OEb)
~GAMEPORT_{WR}: U176.3 (TriggerA), U176.6 (TriggerB), U176.11 (TriggerC), U176.14 (TriggerD)

Notes on the sheet:
Game Port Status - 201h
The Chameleon did not include ferrite beads on the +5V lines to the game port. This did not help them with their EMF issues. I have added footprints for them so you don't make the FCC unhappy.
Joystick Axis Charge Capacitors These large, 400V film capacitors are charged by the joystick The 558 times how fast it takes them to charge.
