dbalsom/seequa_chameleon/kicad/gpib.kicad_sch

## KiCad design kicad/gpib.kicad_sch (2026-05-13)

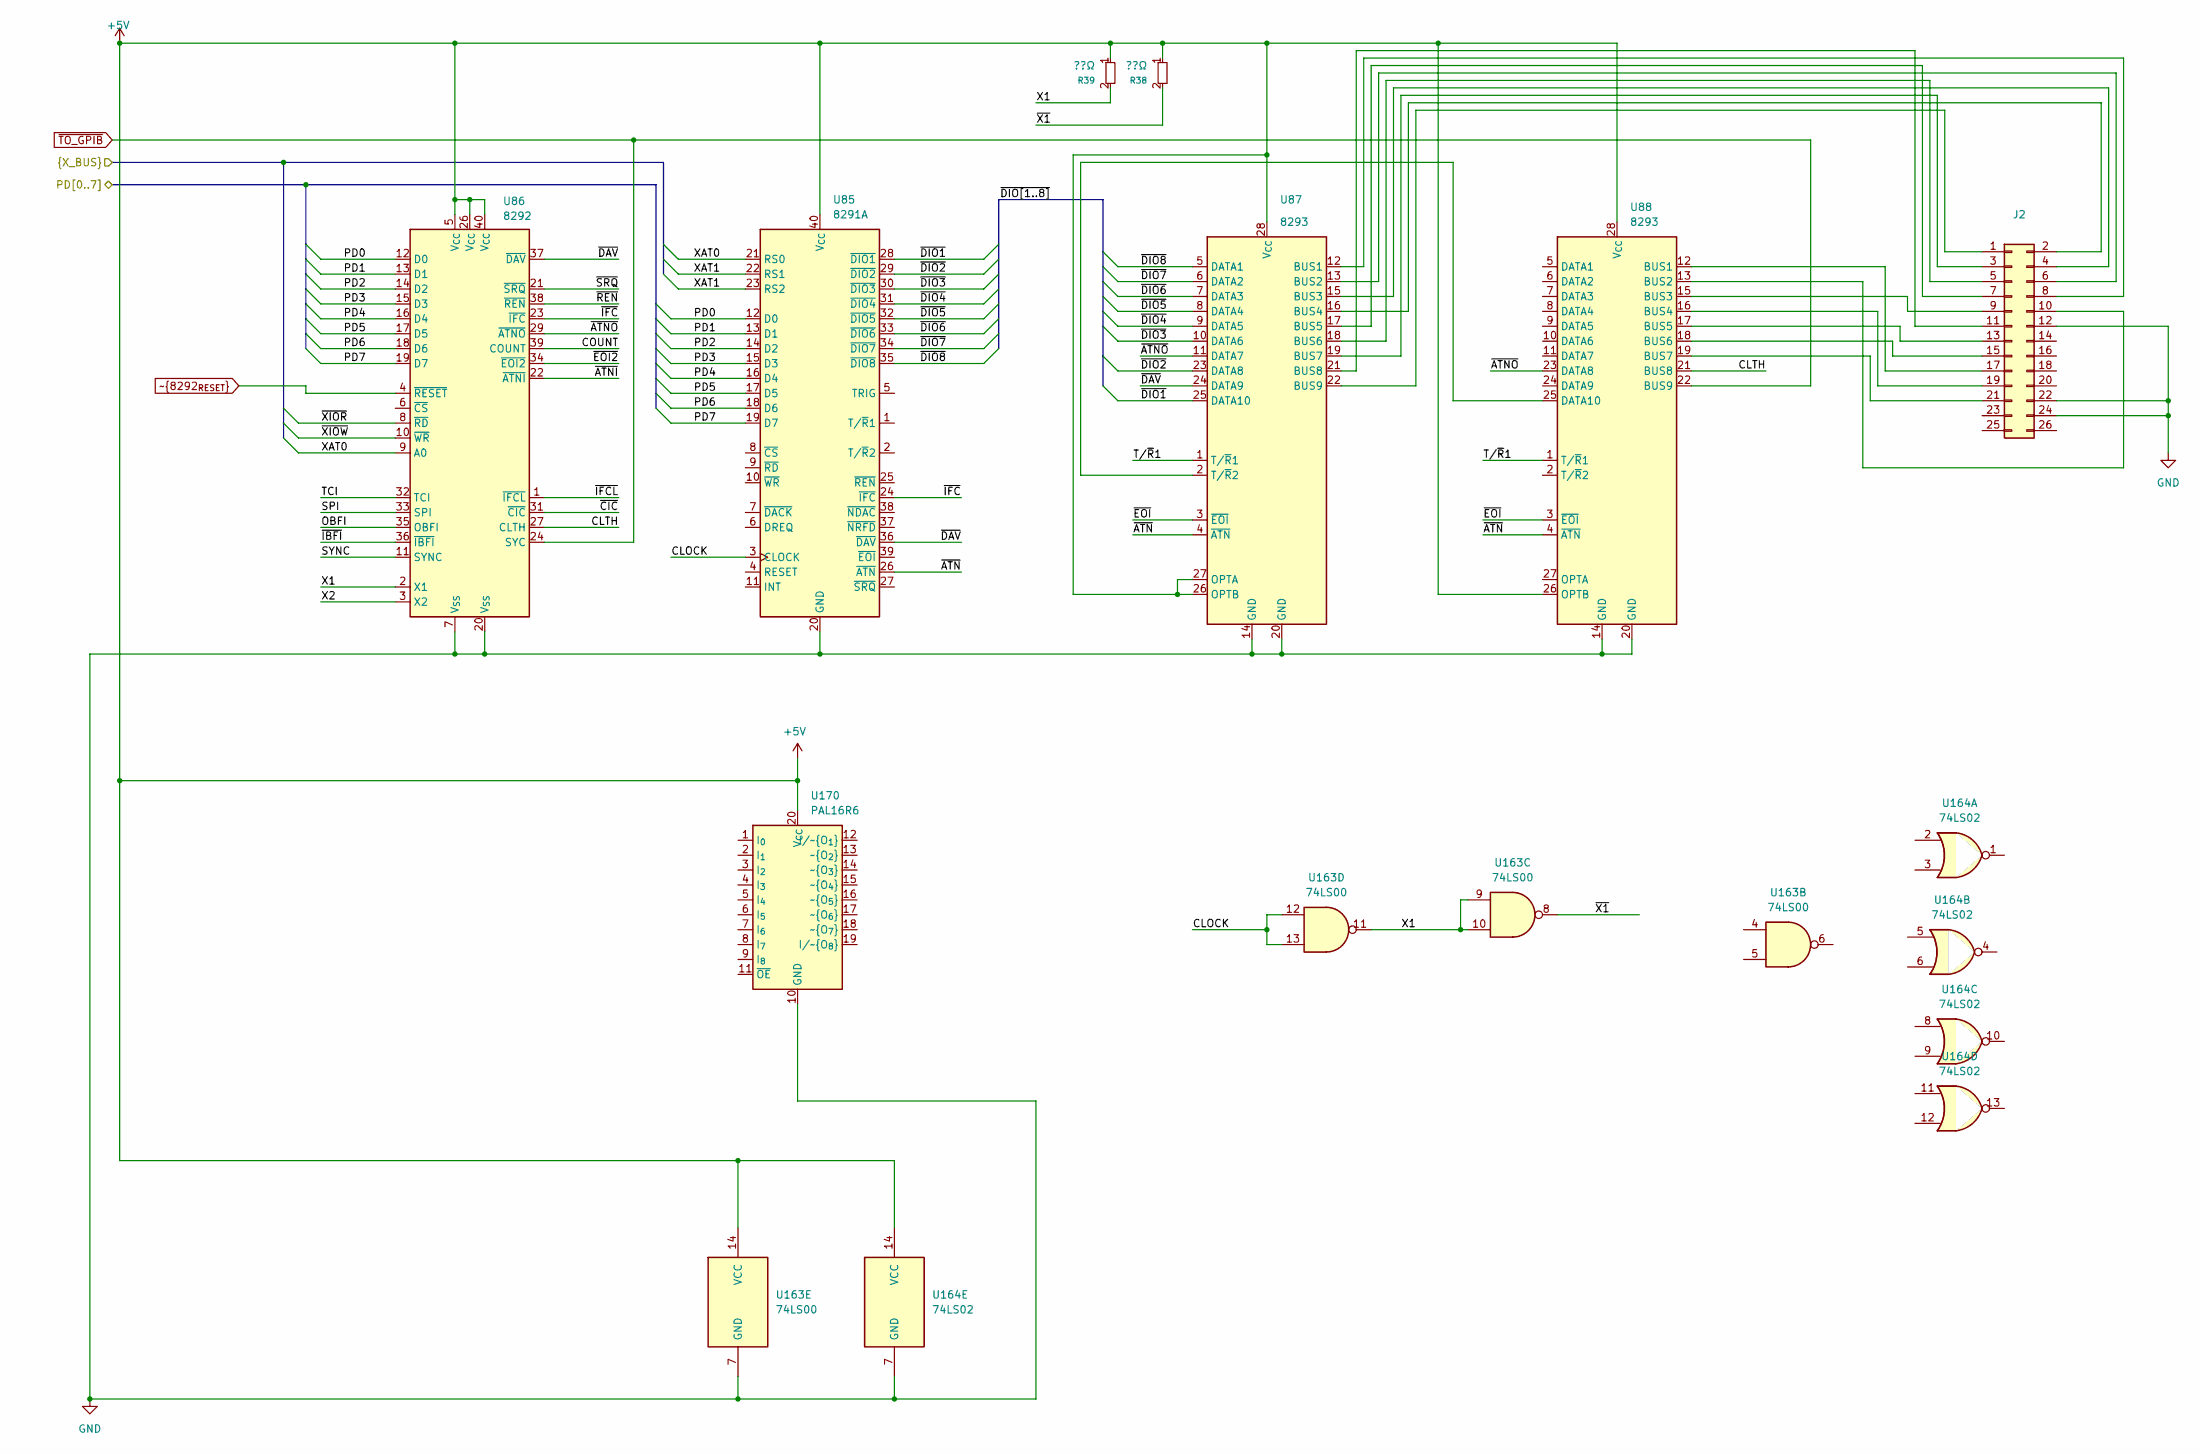
[picture p23: schematic gpib.kicad_sch]

Parts:
J2: Conn_02x13_Odd_Even; PinHeader_2x13_P2.54mm_Vertical
R38, R39: ??Ω; R_Seequa_Resistor
U85: 8291A; DIP-40_W15.24mm_Socket
U86: 8292; DIP-40_W15.24mm_Socket
U87, U88: 8293; DIP-28_W15.24mm
U163: 74LS00; DIP-14_W7.62mm_Socket
U164: 74LS02; DIP-14_W7.62mm
U170: PAL16R6; DIP-20_W7.62mm_Socket

Connections:
+5V: R38.1, R39.1, U85.40 (V_{CC}), U86.5 (V_{CC}), U86.26 (V_{CC}), U86.40 (V_{CC}), U87.26 (OPTB), U87.27 (OPTA), U87.28 (V_{CC}), U88.26 (OPTB), U88.28 (V_{CC}), U163.14 (VCC), U164.14 (VCC), U170.20 (V_{CC})
CLOCK: U85.3 (CLOCK), U163.12, U163.13
CLTH: U86.27 (CLTH), U88.21 (BUS8)
COUNT: U86.39 (COUNT)
GND: J2.12, J2.22, J2.24, U85.20 (GND), U86.7 (V_{SS}), U86.20 (V_{SS}), U87.14 (GND), U87.20 (GND), U88.14 (GND), U88.20 (GND), U163.7 (GND), U164.7 (GND), U170.10 (GND)
unnamed: J2.1, U87.22 (BUS9)
unnamed: J2.2, U87.16 (BUS4)
unnamed: J2.3, U87.19 (BUS7)
unnamed: J2.4, U87.15 (BUS3)
unnamed: J2.5, U87.18 (BUS6)
unnamed: J2.6, U87.13 (BUS2)
unnamed: J2.7, U87.17 (BUS5)
unnamed: J2.8, U87.12 (BUS1)
unnamed: J2.9, U88.15 (BUS3)
unnamed: J2.10, U88.13 (BUS2)
unnamed: J2.11, U87.21 (BUS8)
unnamed: J2.13, U88.17 (BUS5)
unnamed: J2.15, U88.18 (BUS6)
unnamed: J2.17, U88.12 (BUS1)
unnamed: J2.19, U88.16 (BUS4)
unnamed: J2.21, U88.19 (BUS7)
unnamed: U87.2 (T/~R2), U88.25 (DATA10)
OBFI: U86.35 (OBFI)
PD0: U85.12 (D0), U86.12 (D0)
PD1: U85.13 (D1), U86.13 (D1)
PD2: U85.14 (D2), U86.14 (D2)
PD3: U85.15 (D3), U86.15 (D3)
PD4: U85.16 (D4), U86.16 (D4)
PD5: U85.17 (D5), U86.17 (D5)
PD6: U85.18 (D6), U86.18 (D6)
PD7: U85.19 (D7), U86.19 (D7)
SPI: U86.33 (SPI)
SYNC: U86.11 (SYNC)
T/~R1: U87.1 (T/~R1), U88.1 (T/~R1)
TCI: U86.32 (TCI)
X1: R39.2, U86.2 (X1), U163.9, U163.10, U163.11
X2: U86.3 (X2)
XAT0: U85.21 (RS0), U86.9 (A0)
XAT1: U85.22 (RS1), U85.23 (RS2)
~8292_{RESET}: U86.4 (~RESET)
~ATNI: U86.22 (~ATNI)
~ATNO: U86.29 (~ATNO), U87.11 (DATA7), U88.23 (DATA8)
~ATN: U85.26 (~ATN), U87.4 (~ATN), U88.4 (~ATN)
~CIC: U86.31 (~CIC)
~DAV: U85.36 (~DAV), U86.37 (~DAV), U87.24 (DATA9)
~DIO1: U85.28 (~DIO1), U87.25 (DATA10)
~DIO2: U85.29 (~DIO2), U87.23 (DATA8)
~DIO3: U85.30 (~DIO3), U87.10 (DATA6)
~DIO4: U85.31 (~DIO4), U87.9 (DATA5)
~DIO5: U85.32 (~DIO5), U87.8 (DATA4)
~DIO6: U85.33 (~DIO6), U87.7 (DATA3)
~DIO7: U85.34 (~DIO7), U87.6 (DATA2)
~DIO8: U85.35 (~DIO8), U87.5 (DATA1)
~EOI2: U86.34 (~EOI2)
~EOI: U87.3 (~EOI), U88.3 (~EOI)
~IBFI: U86.36 (~IBFI)
~IFCL: U86.1 (~IFCL)
~IFC: U85.24 (~IFC), U86.23 (~IFC)
~REN: U86.38 (~REN)
~SRQ: U86.21 (~SRQ)
~TO_GPIB: U86.24 (SYC), U88.22 (BUS9)
~X1: R38.2, U163.8
~XIOR: U86.8 (~RD)
~XIOW: U86.10 (~WR)
