dbalsom/seequa_chameleon/kicad/io_decode.kicad_sch

## KiCad design kicad/io_decode.kicad_sch (2026-05-13)

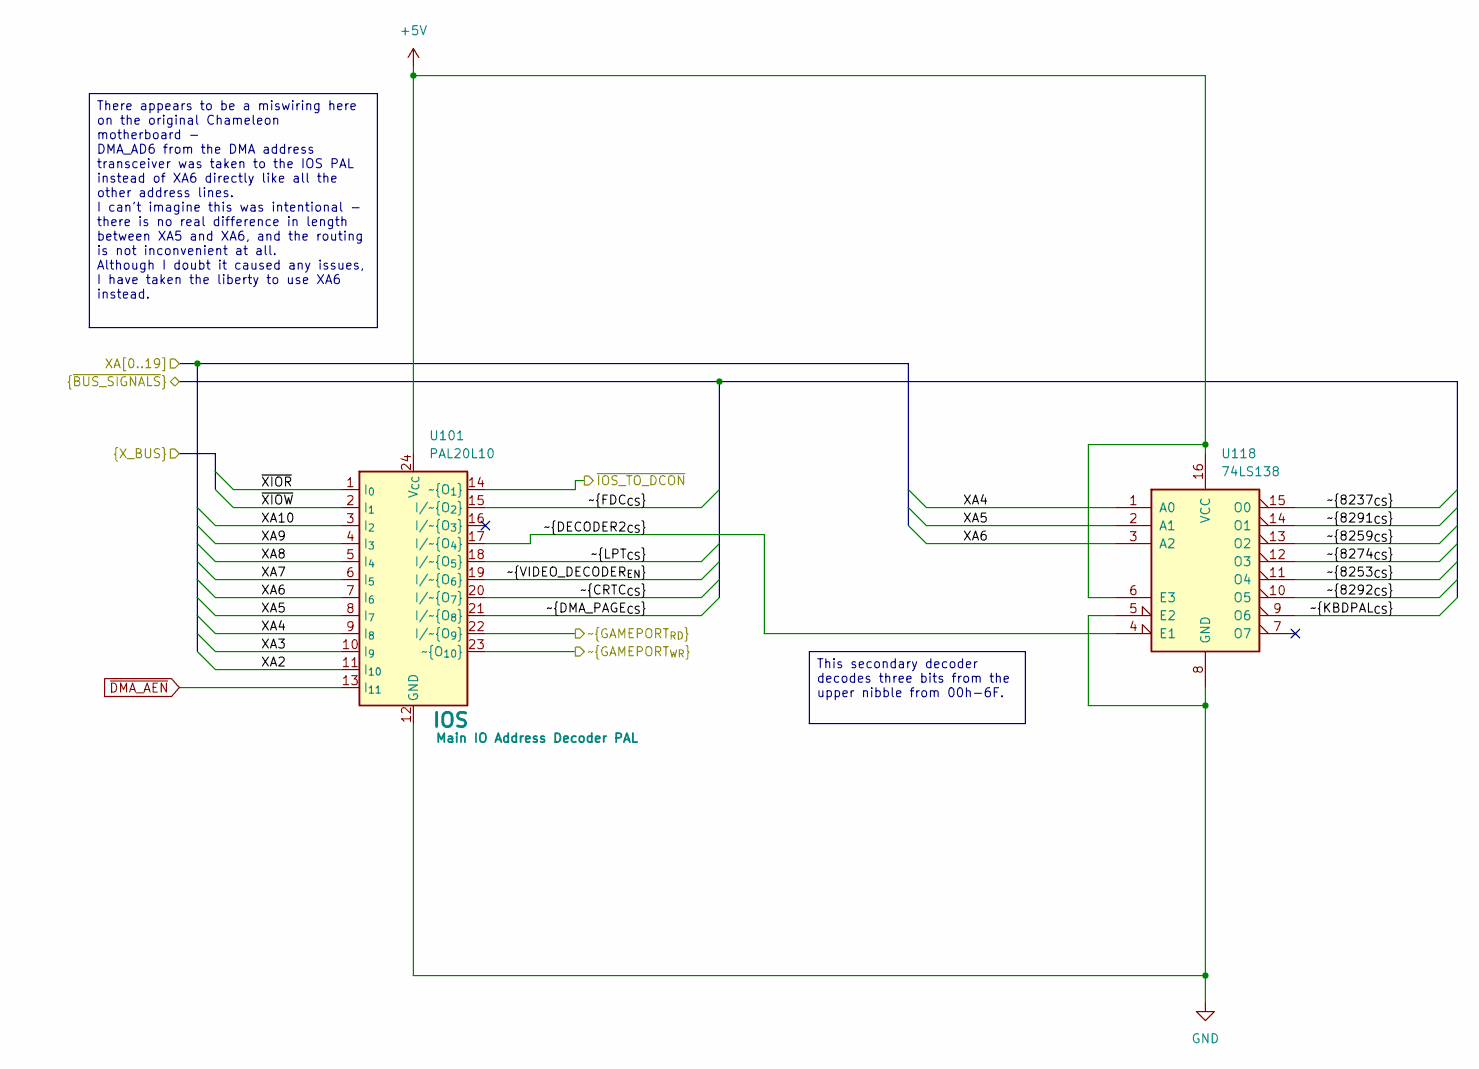
[picture p24: schematic io_decode.kicad_sch]

Parts:
U101: PAL20L10; DIP-24_W7.62mm
U118: 74LS138; DIP-16_W7.62mm

Connections:
+5V: U101.24 (V_{CC}), U118.6 (E3), U118.16 (VCC)
GND: U101.12 (GND), U118.5 (E2), U118.8 (GND)
XA2: U101.11 (I_{10})
XA3: U101.10 (I_{9})
XA4: U101.9 (I_{8}), U118.1 (A0)
XA5: U101.8 (I_{7}), U118.2 (A1)
XA6: U101.7 (I_{6}), U118.3 (A2)
XA7: U101.6 (I_{5})
XA8: U101.5 (I_{4})
XA9: U101.4 (I_{3})
XA10: U101.3 (I_{2})
~8237_{CS}: U118.15 (O0)
~8253_{CS}: U118.11 (O4)
~8259_{CS}: U118.13 (O2)
~8274_{CS}: U118.12 (O3)
~8291_{CS}: U118.14 (O1)
~8292_{CS}: U118.10 (O5)
~CRTC_{CS}: U101.20 (I/~O_{7})
~DECODER2_{CS}: U101.17 (I/~O_{4}), U118.4 (E1)
~DMA_AEN: U101.13 (I_{11})
~DMA_PAGE_{CS}: U101.21 (I/~O_{8})
~FDC_{CS}: U101.15 (I/~O_{2})
~GAMEPORT_{RD}: U101.22 (I/~O_{9})
~GAMEPORT_{WR}: U101.23 (~O_{10})
~IOS_TO_DCON: U101.14 (~O_{1})
~KBDPAL_{CS}: U118.9 (O6)
~LPT_{CS}: U101.18 (I/~O_{5})
~VIDEO_DECODER_{EN}: U101.19 (I/~O_{6})
~XIOR: U101.1 (I_{0})
~XIOW: U101.2 (I_{1})

Notes on the sheet:
This secondary decoder decodes three bits from the upper nibble from 00h-6F.
There appears to be a miswiring here on the original Chameleon motherboard - DMA_AD6 from the DMA address transceiver was taken to the IOS PAL instead of XA6 directly like all the other address lines. I can't imagine this was intentional - there is no real difference in length between XA5 and XA6, 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
