dbalsom/seequa_chameleon/kicad/keyboard.kicad_sch

## KiCad design kicad/keyboard.kicad_sch (2026-05-13)

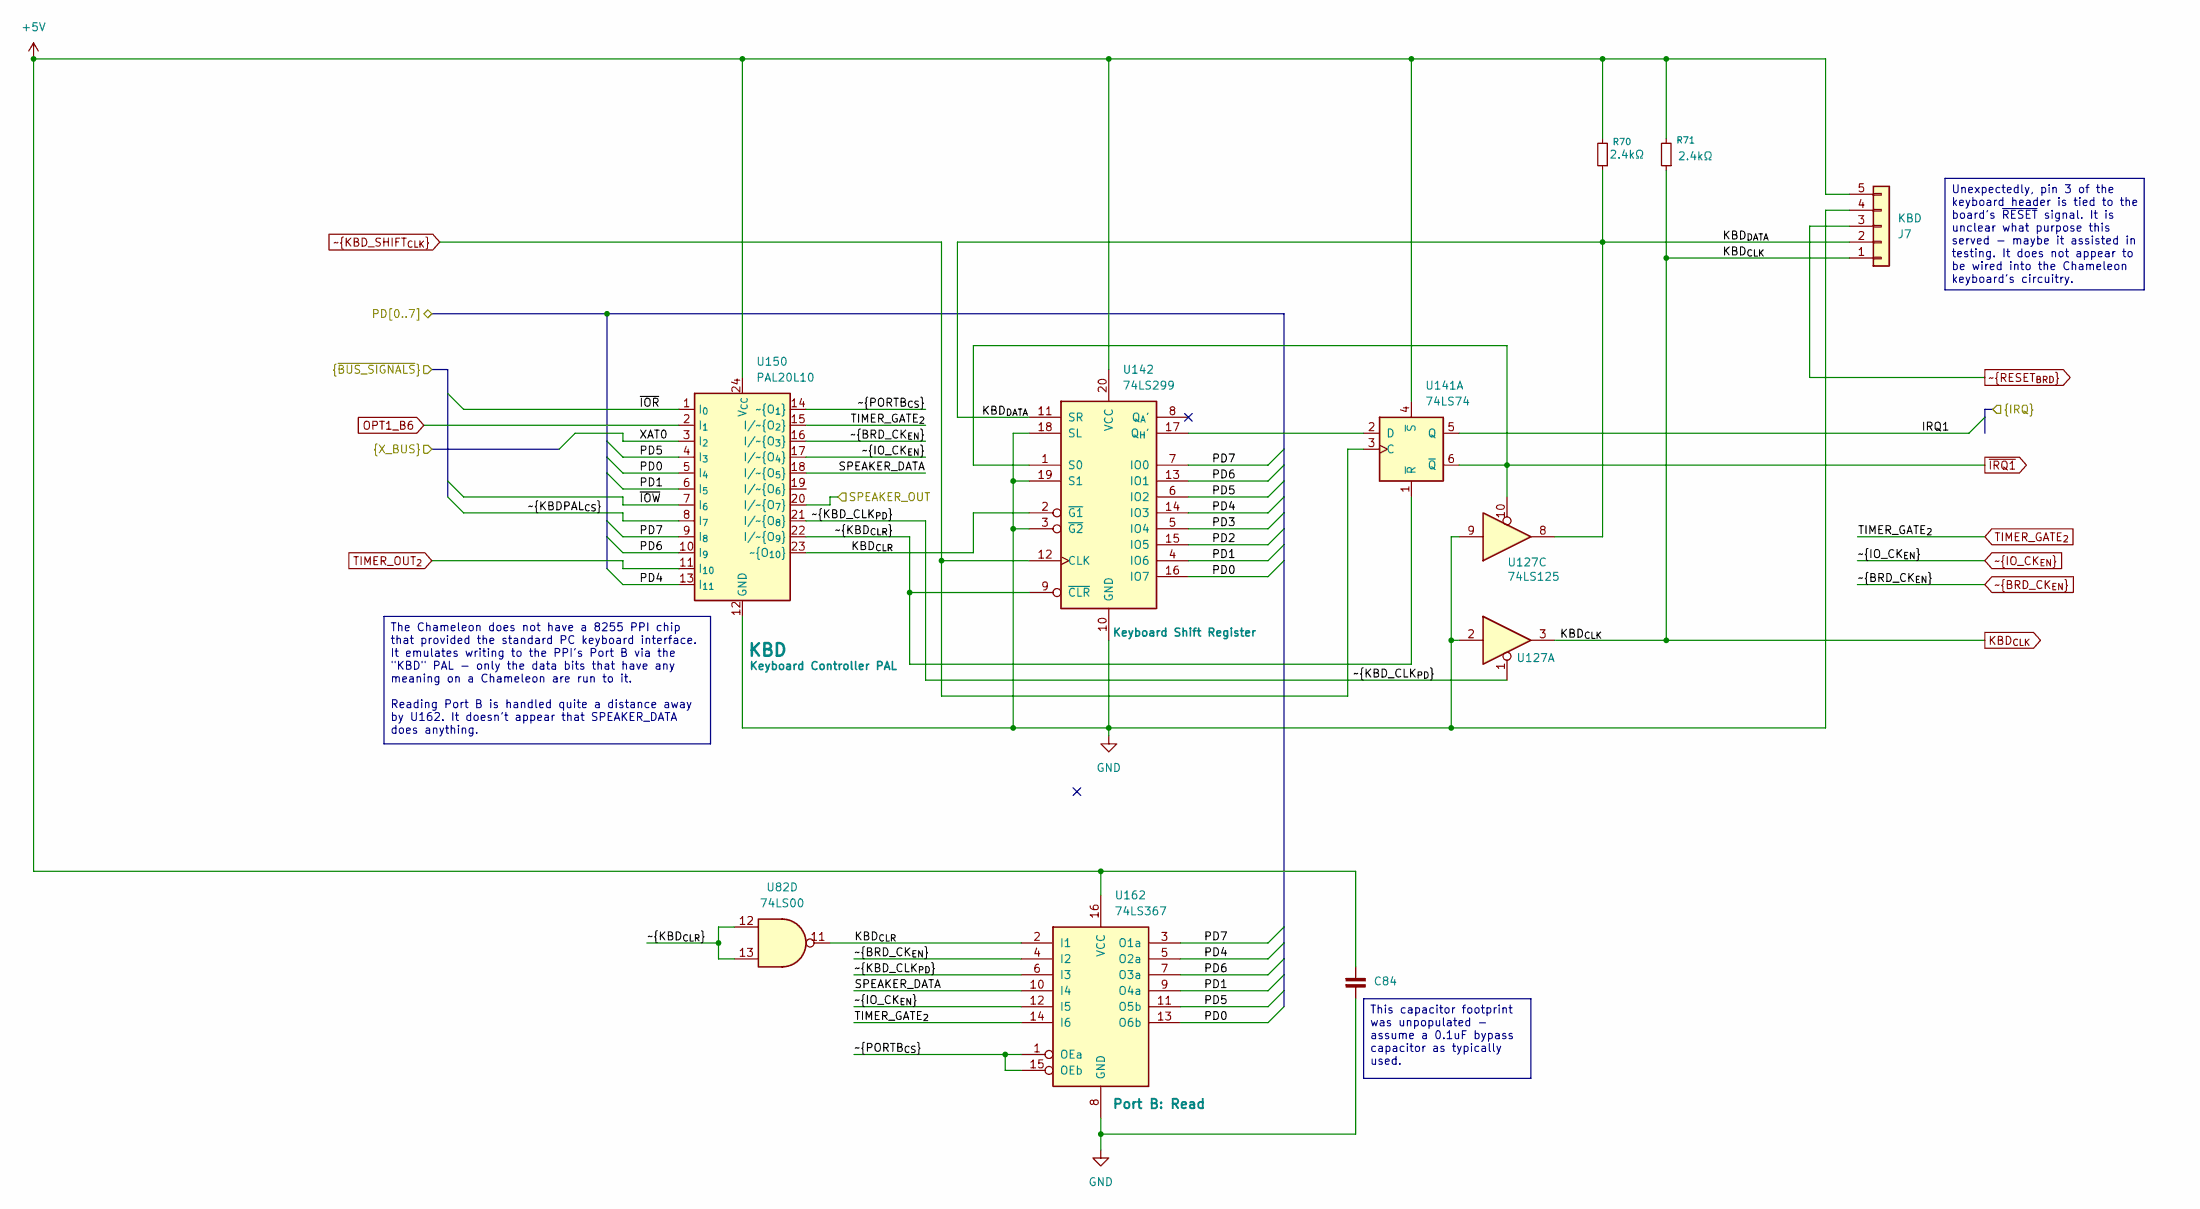
[picture p25: schematic keyboard.kicad_sch]

Parts:
C84: C_Bypass_5mm; C_Seequa_Bypass_Film_5mm
J7: KBD; PinHeader_1x05_P2.54mm_Horizontal
R70, R71: 2.4kΩ; R_Seequa_Resistor
U82: 74LS00; DIP-14_W7.62mm
U127: 74LS125; DIP-14_W7.62mm
U141: 74LS74; DIP-14_W7.62mm
U142: 74LS299; DIP-20_W7.62mm
U150: PAL20L10; DIP-24_W7.62mm
U162: 74LS367; DIP-16_W7.62mm

Connections:
+5V: C84.1, J7.5, R70.2, R71.2, U141.4 (~S), U142.20 (VCC), U150.24 (V_{CC}), U162.16 (VCC)
GND: C84.2, J7.4, U127.2, U127.9, U142.3 (~G2), U142.10 (GND), U142.18 (SL), U142.19 (S1), U150.12 (GND), U162.8 (GND)
IRQ1: U141.5 (Q)
KBD_{CLK}: J7.1, R71.1, U127.3
KBD_{CLR}: U82.11, U142.2 (~G1), U150.23 (~O_{10}), U162.2 (I1)
KBD_{DATA}: J7.2, R70.1, U127.8, U142.11 (SR)
unnamed: U141.2 (D), U142.17 (Q_{H}')
OPT1_B6: U150.2 (I_{1})
PD0: U142.16 (IO7), U150.5 (I_{4}), U162.13 (O6b)
PD1: U142.4 (IO6), U150.6 (I_{5}), U162.9 (O4a)
PD2: U142.15 (IO5)
PD3: U142.5 (IO4)
PD4: U142.14 (IO3), U150.13 (I_{11}), U162.5 (O2a)
PD5: U142.6 (IO2), U150.4 (I_{3}), U162.11 (O5b)
PD6: U142.13 (IO1), U150.10 (I_{9}), U162.7 (O3a)
PD7: U142.7 (IO0), U150.9 (I_{8}), U162.3 (O1a)
SPEAKER_DATA: U150.18 (I/~O_{5}), U162.10 (I4)
SPEAKER_OUT: U150.20 (I/~O_{7})
TIMER_GATE_{2}: U150.15 (I/~O_{2}), U162.14 (I6)
TIMER_OUT_{2}: U150.11 (I_{10})
XAT0: U150.3 (I_{2})
~BRD_CK_{EN}: U150.16 (I/~O_{3}), U162.4 (I2)
~IOR: U150.1 (I_{0})
~IOW: U150.7 (I_{6})
~IO_CK_{EN}: U150.17 (I/~O_{4}), U162.12 (I5)
~IRQ1: U127.10, U141.6 (~Q), U142.1 (S0)
~KBDPAL_{CS}: U150.8 (I_{7})
~KBD_CLK_{PD}: U127.1, U150.21 (I/~O_{8}), U162.6 (I3)
~KBD_SHIFT_{CLK}: U141.3 (C), U142.12 (CLK)
~KBD_{CLR}: U82.12, U82.13, U141.1 (~R), U142.9 (~CLR), U150.22 (I/~O_{9})
~PORTB_{CS}: U150.14 (~O_{1}), U162.1 (OEa), U162.15 (OEb)
~RESET_{BRD}: J7.3

Notes on the sheet:
The Chameleon does not have a 8255 PPI chip that provided the standard PC keyboard interface. It emulates writing to the PPI's Port B via the "KBD" PAL - only the data bits that have any meaning on a Chameleon are run to it. Reading Port B is handled quite a distance away by U162. It doesn't appear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
Unexpectedly, pin 3 of the keyboard header is tied to the board's ~{RESET} signal. It is unclear what purpose this served - maybe it assisted in testing. It does not appear to be wired into the Chameleon keyboard's circuitry.
This capacitor footprint was unpopulated - assume a 0.1uF bypass capacitor as typically used.
