dbalsom/seequa_chameleon/kicad/lightpen.kicad_sch

## KiCad design kicad/lightpen.kicad_sch (2026-02-26)

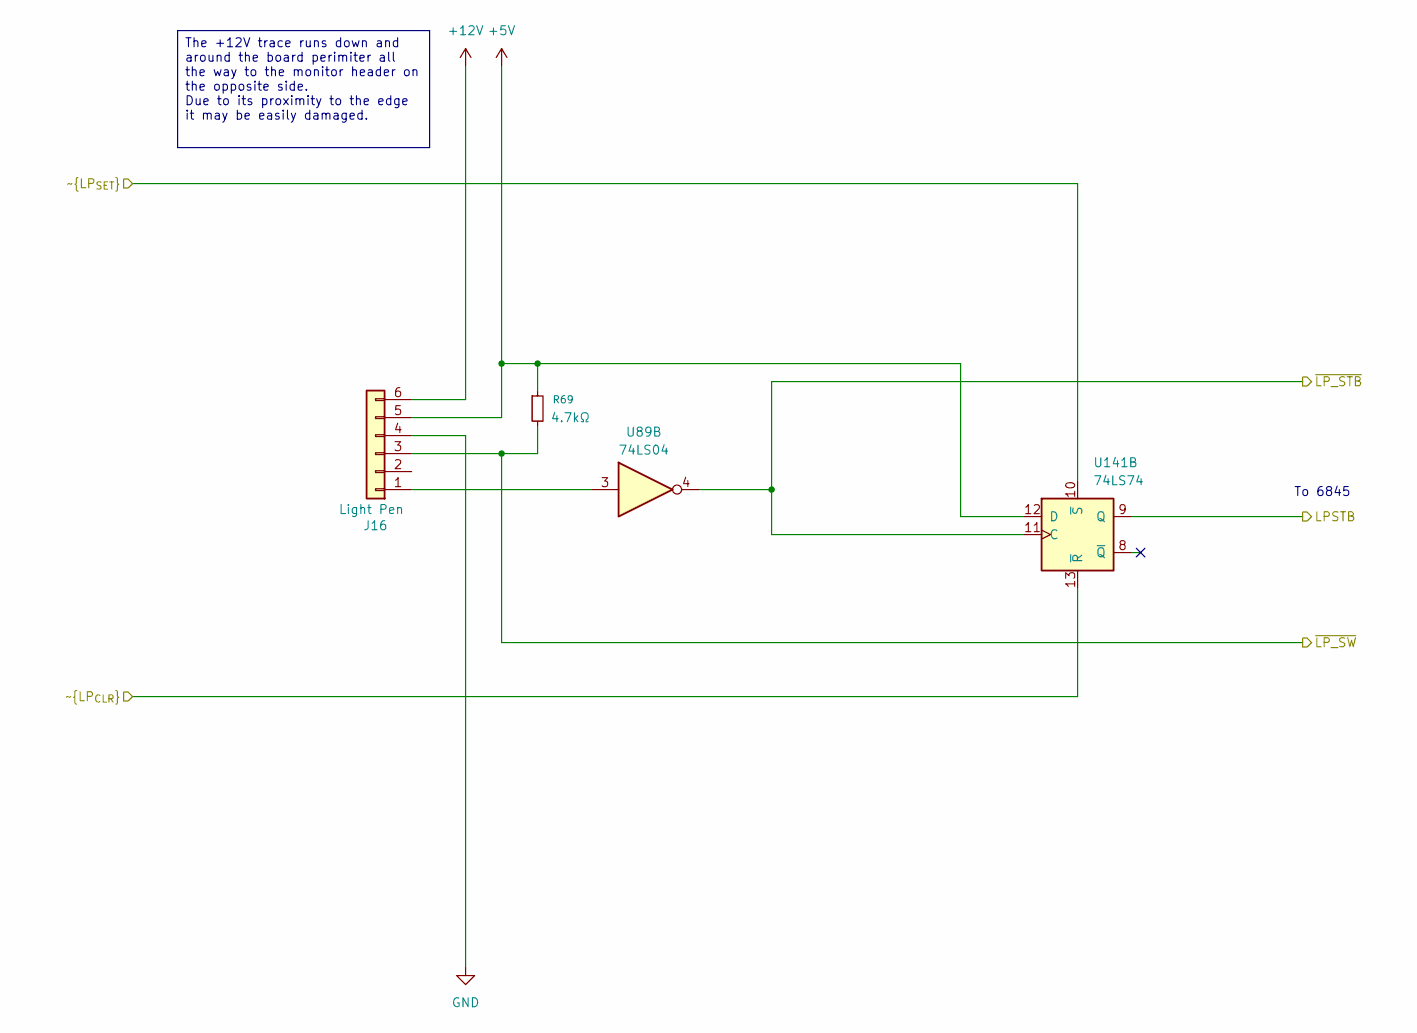
[picture p26: schematic lightpen.kicad_sch]

Parts:
J16: Light Pen; PinHeader_1x06_P2.54mm_Horizontal
R69: 4.7kΩ; R_Seequa_Resistor
U89: 74LS04; DIP-14_W7.62mm
U141: 74LS74; DIP-14_W7.62mm

Connections:
+5V: J16.5, R69.1, U141.12 (D)
+12V: J16.6
GND: J16.4
LPSTB: U141.9 (Q)
unnamed: J16.1, U89.3
~LP_STB: U89.4, U141.11 (C)
~LP_SW: J16.3, R69.2
~LP_{CLR}: U141.13 (~R)
~LP_{SET}: U141.10 (~S)

Notes on the sheet:
To 6845
The +12V trace runs down and around the board perimiter all the way to the monitor header on the opposite side. Due to its proximity to the edge it may be easily damaged.
