dbalsom/seequa_chameleon/kicad/palette_regs.kicad_sch

## KiCad design kicad/palette_regs.kicad_sch (2026-05-13)

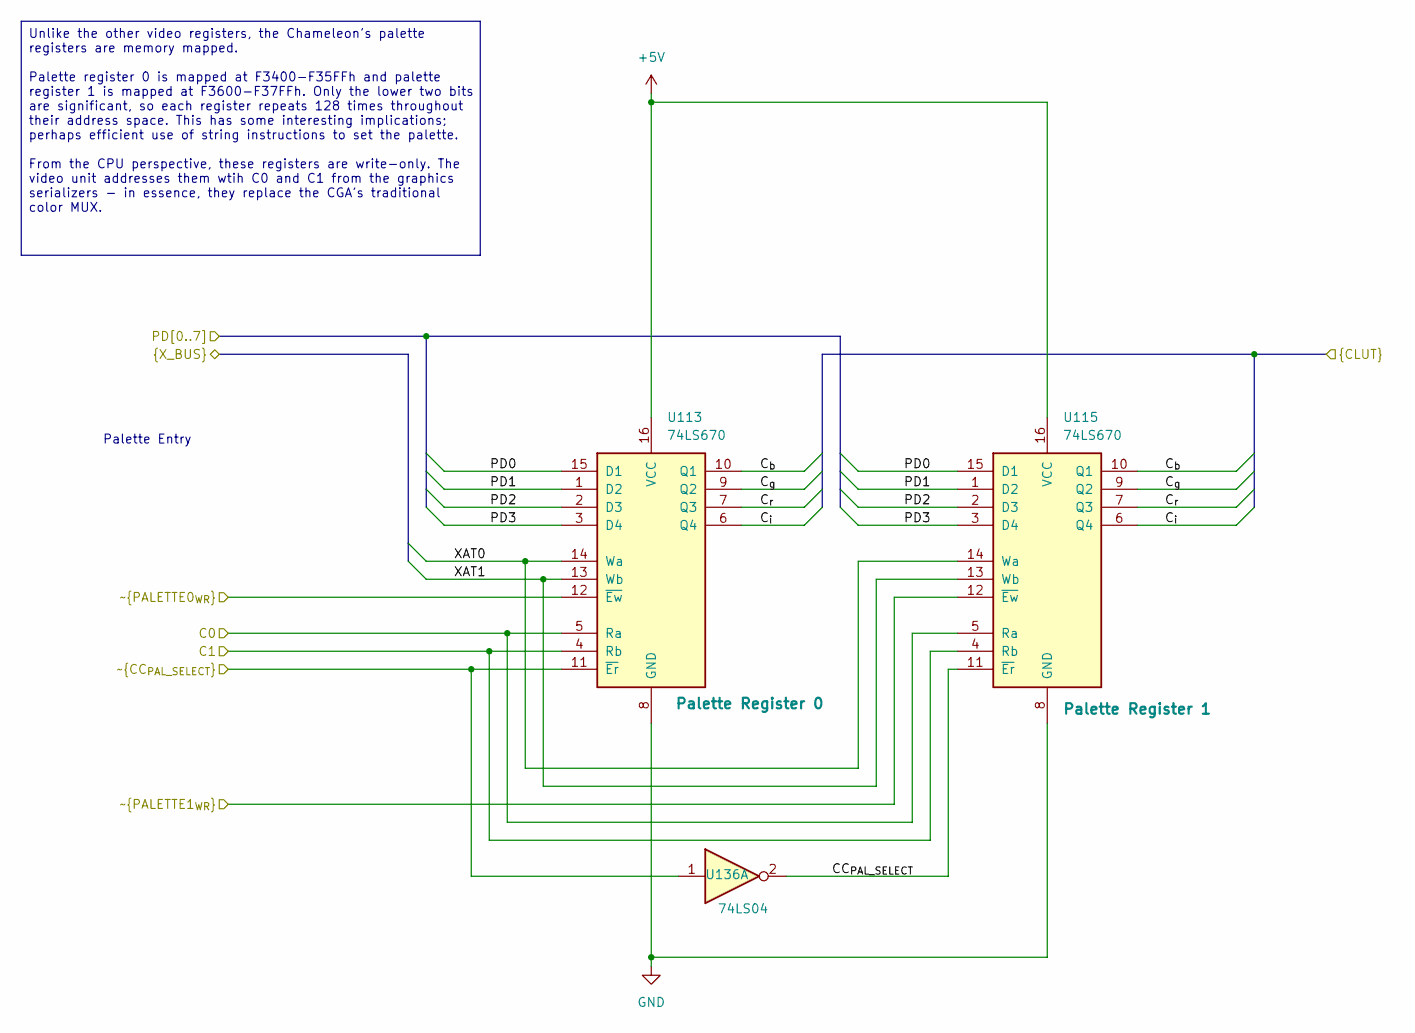
[picture p27: schematic palette_regs.kicad_sch]

Parts:
U113, U115: 74LS670; DIP-16_W7.62mm
U136: 74LS04; DIP-14_W7.62mm

Connections:
+5V: U113.16 (VCC), U115.16 (VCC)
C0: U113.5 (Ra), U115.5 (Ra)
C1: U113.4 (Rb), U115.4 (Rb)
CC_{PAL_SELECT}: U115.11 (~Er), U136.2
C_{b}: U113.10 (Q1), U115.10 (Q1)
C_{g}: U113.9 (Q2), U115.9 (Q2)
C_{i}: U113.6 (Q4), U115.6 (Q4)
C_{r}: U113.7 (Q3), U115.7 (Q3)
GND: U113.8 (GND), U115.8 (GND)
PD0: U113.15 (D1), U115.15 (D1)
PD1: U113.1 (D2), U115.1 (D2)
PD2: U113.2 (D3), U115.2 (D3)
PD3: U113.3 (D4), U115.3 (D4)
XAT0: U113.14 (Wa), U115.14 (Wa)
XAT1: U113.13 (Wb), U115.13 (Wb)
~CC_{PAL_SELECT}: U113.11 (~Er), U136.1
~PALETTE0_{WR}: U113.12 (~Ew)
~PALETTE1_{WR}: U115.12 (~Ew)

Notes on the sheet:
Palette Entry
Unlike the other video registers, the Chameleon's palette registers are memory mapped. Palette register 0 is mapped at F3400-F35FFh and palette register 1 is mapped at F3600-F37FFh. Only the lower two bits are significant, so each register repeats 128 times throughout their address space. This has 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
