dbalsom/seequa_chameleon/kicad/parallel.kicad_sch

## KiCad design kicad/parallel.kicad_sch (2026-05-13)

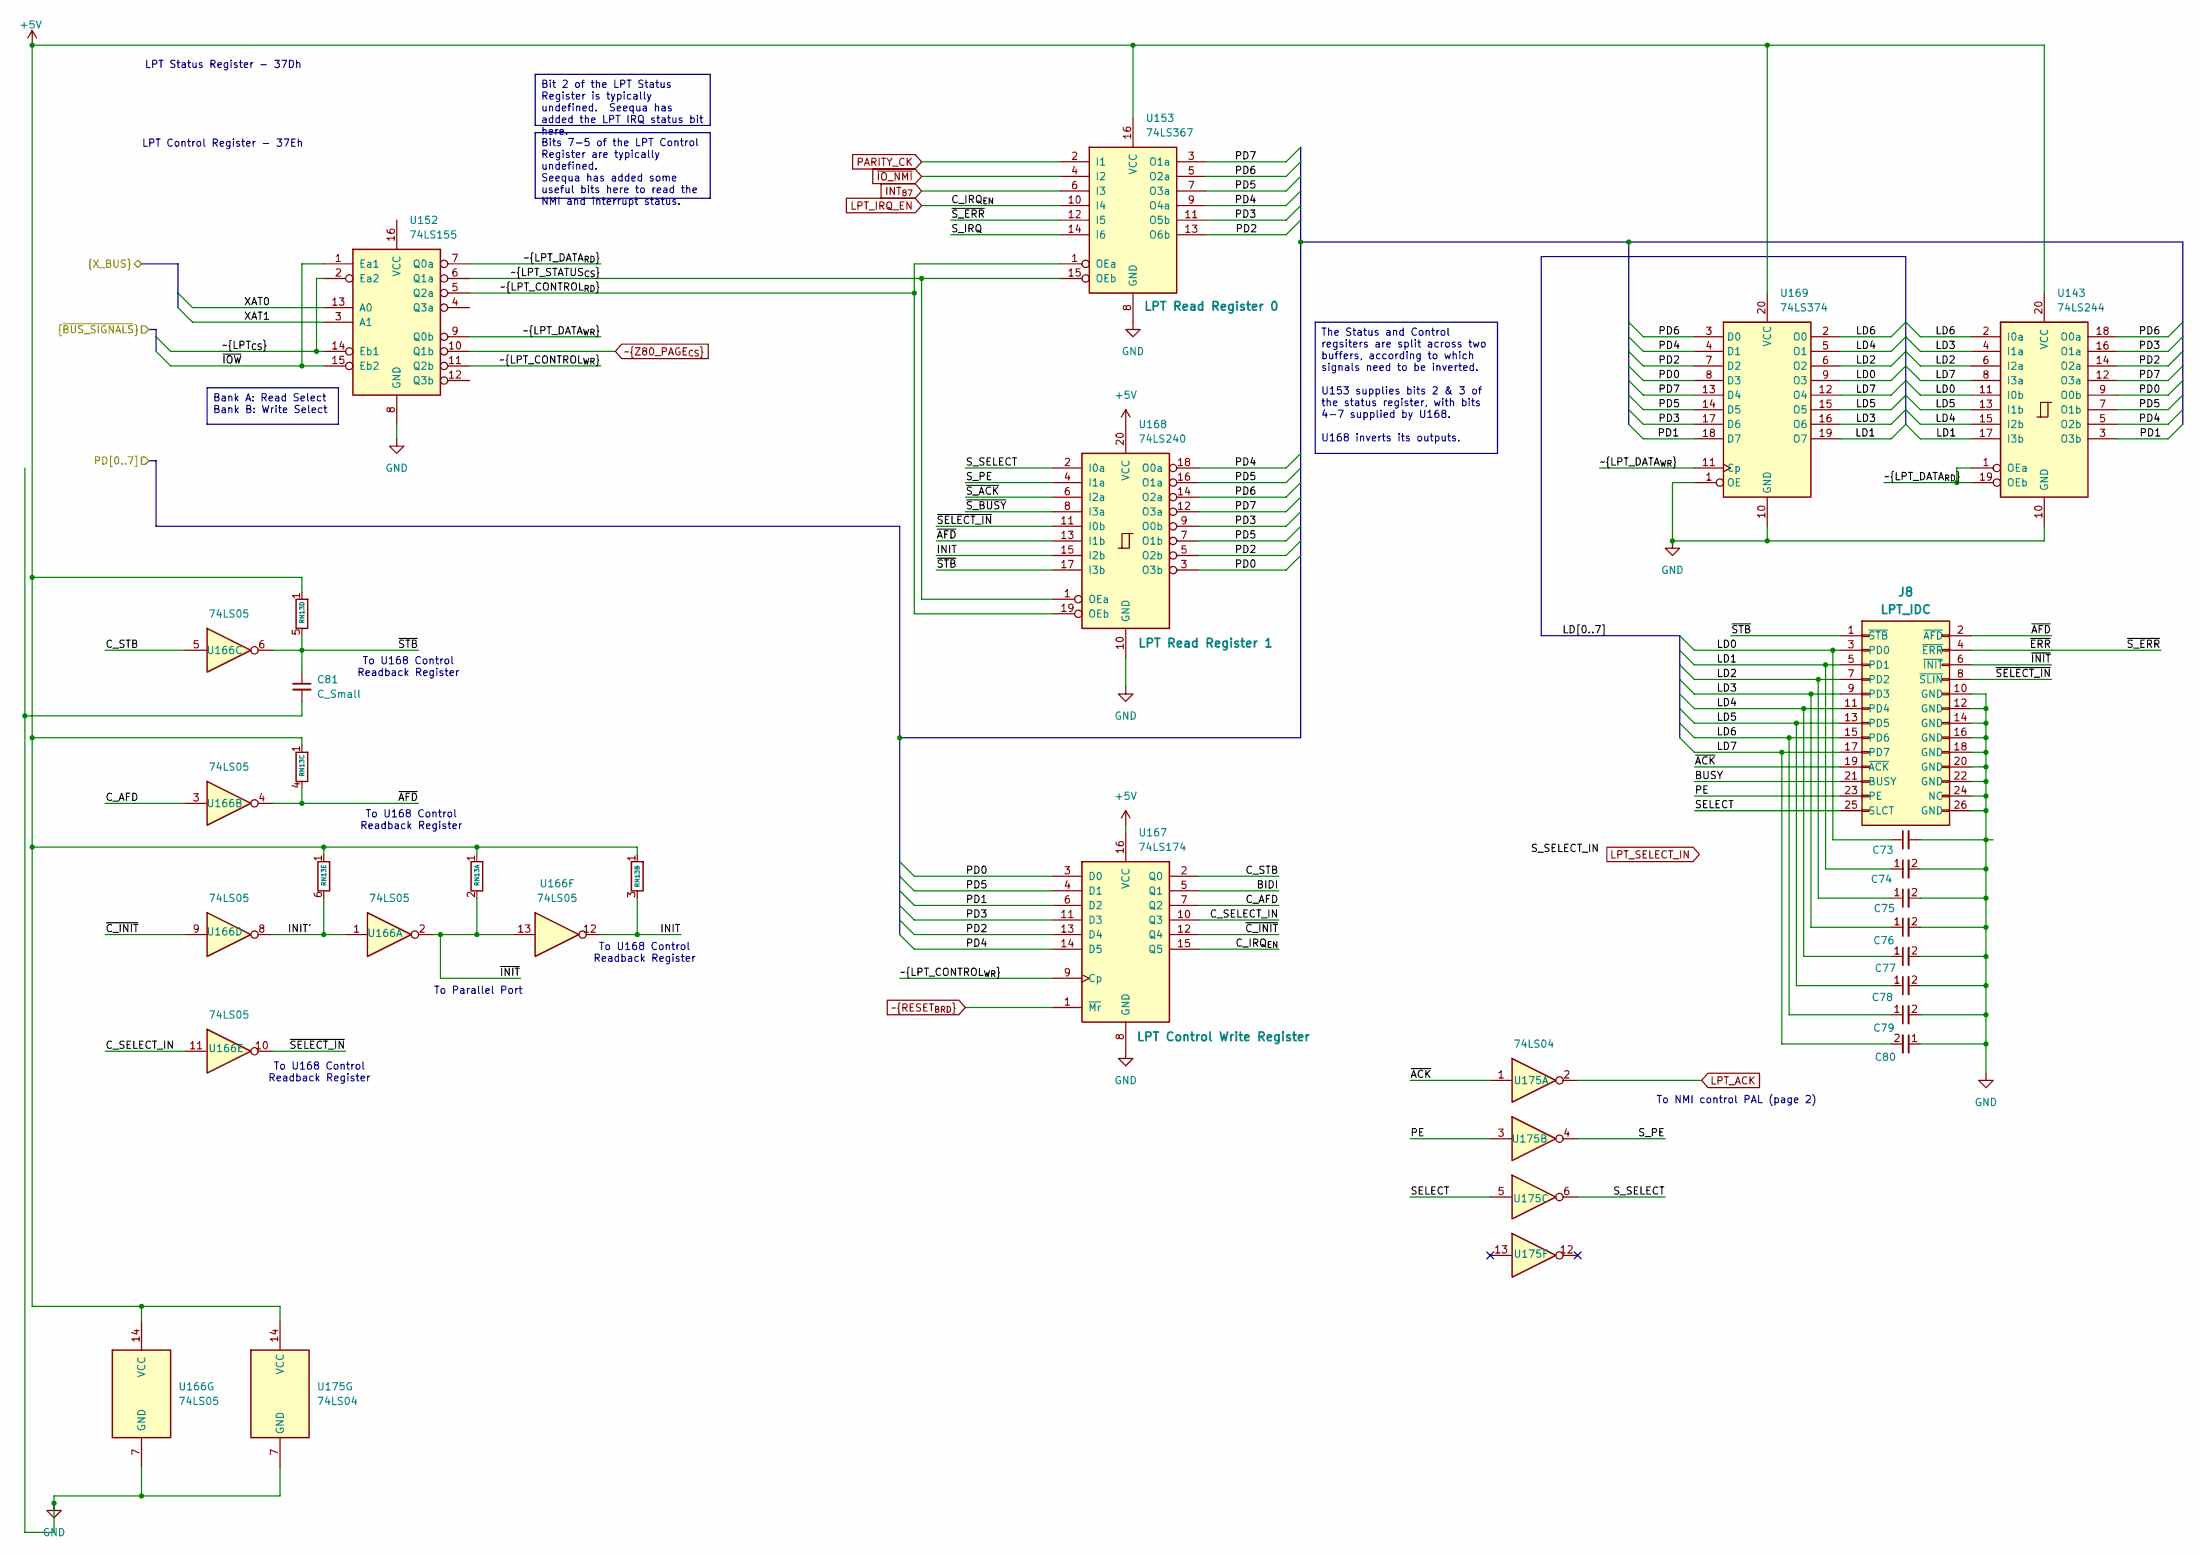
[picture p28: schematic parallel.kicad_sch]

Parts:
C73, C74, C75, C76, C77, C78, C79, C80: C_Small; C_Seequa_Filter_6mm
C81: C_Small; C_Seequa_Bypass_6.5mm
J8: LPT_IDC; PinHeader_2x13_P2.54mm_Vertical
RN13: R_Network05_Split; R_Array_SIP6
U143: 74LS244; DIP-20_W7.62mm
U152: 74LS155; DIP-16_W7.62mm
U153: 74LS367; DIP-16_W7.62mm
U166: 74LS05; DIP-14_W7.62mm
U167: 74LS174; DIP-16_W7.62mm
U168: 74LS240; DIP-20_W7.62mm
U169: 74LS374; DIP-20_W7.62mm
U175: 74LS04; DIP-14_W7.62mm

Connections:
+5V: RN13.1 (R1), U143.20 (VCC), U153.16 (VCC), U166.14 (VCC), U167.16 (VCC), U168.20 (VCC), U169.20 (VCC), U175.14 (VCC)
BIDI: U167.5 (Q1)
BUSY: J8.21 (BUSY)
C_AFD: U166.3, U167.7 (Q2)
C_SELECT_IN: U166.11, U167.10 (Q3)
C_STB: U166.5, U167.2 (Q0)
GND: C73.2, C74.2, C75.2, C76.2, C77.2, C78.2, C79.2, C80.1, C81.2, J8.10 (GND), J8.12 (GND), J8.14 (GND), J8.16 (GND), J8.18 (GND), J8.20 (GND), J8.22 (GND), J8.24 (NC), J8.26 (GND), U143.10 (GND), U152.8 (GND), U153.8 (GND), U166.7 (GND), U167.8 (GND), U168.10 (GND), U169.1 (OE), U169.10 (GND), U175.7 (GND)
INIT: RN13.3 (R2.2), U166.12, U168.15 (I2b)
INIT': RN13.6 (R5.2), U166.1, U166.8
INT_{87}: U153.6 (I3)
LD0: C73.1, J8.3 (PD0), U143.11 (I0b), U169.9 (O3)
LD1: C74.1, J8.5 (PD1), U143.17 (I3b), U169.19 (O7)
LD2: C75.1, J8.7 (PD2), U143.6 (I2a), U169.6 (O2)
LD3: C76.1, J8.9 (PD3), U143.4 (I1a), U169.16 (O6)
LD4: C77.1, J8.11 (PD4), U143.15 (I2b), U169.5 (O1)
LD5: C78.1, J8.13 (PD5), U143.13 (I1b), U169.15 (O5)
LD6: C79.1, J8.15 (PD6), U143.2 (I0a), U169.2 (O0)
LD7: C80.2, J8.17 (PD7), U143.8 (I3a), U169.12 (O4)
LPT_ACK: U175.2
LPT_IRQ_EN: U153.10 (I4), U167.15 (Q5)
PARITY_CK: U153.2 (I1)
PD0: U143.9 (O0b), U167.3 (D0), U168.3 (O3b), U169.8 (D3)
PD1: U143.3 (O3b), U167.6 (D2), U169.18 (D7)
PD2: U143.14 (O2a), U153.13 (O6b), U167.13 (D4), U168.5 (O2b), U169.7 (D2)
PD3: U143.16 (O1a), U153.11 (O5b), U167.11 (D3), U168.9 (O0b), U169.17 (D6)
PD4: U143.5 (O2b), U153.9 (O4a), U167.14 (D5), U168.18 (O0a), U169.4 (D1)
PD5: U143.7 (O1b), U153.7 (O3a), U167.4 (D1), U168.7 (O1b), U168.16 (O1a), U169.14 (D5)
PD6: U143.18 (O0a), U153.5 (O2a), U168.14 (O2a), U169.3 (D0)
PD7: U143.12 (O3a), U153.3 (O1a), U168.12 (O3a), U169.13 (D4)
PE: J8.23 (PE), U175.3
SELECT: J8.25 (SLCT), U175.5
S_IRQ: U153.14 (I6)
S_PE: U168.4 (I1a), U175.4
S_SELECT: U168.2 (I0a), U175.6
XAT0: U152.13 (A0)
XAT1: U152.3 (A1)
~ACK: J8.19 (~ACK), U175.1
~AFD: J8.2 (~AFD), RN13.4 (R3.2), U166.4, U168.13 (I1b)
~C_INIT: U166.9, U167.12 (Q4)
~ERR: J8.4 (~ERR), U153.12 (I5)
~INIT: J8.6 (~INIT), RN13.2 (R1.2), U166.2, U166.13
~IOW: U152.1 (Ea1), U152.15 (Eb2)
~IO_NMI: U153.4 (I2)
~LPT_CONTROL_{RD}: U152.5 (Q2a), U153.1 (OEa), U168.19 (OEb)
~LPT_CONTROL_{WR}: U152.11 (Q2b), U167.9 (Cp)
~LPT_DATA_{RD}: U143.1 (OEa), U143.19 (OEb), U152.7 (Q0a)
~LPT_DATA_{WR}: U152.9 (Q0b), U169.11 (Cp)
~LPT_STATUS_{CS}: U152.6 (Q1a), U153.15 (OEb), U168.1 (OEa)
~LPT_{CS}: U152.2 (Ea2), U152.14 (Eb1)
~RESET_{BRD}: U167.1 (~Mr)
~SELECT_IN: J8.8 (~SLIN), U166.10, U168.11 (I0b)
~STB: C81.1, J8.1 (~STB), RN13.5 (R4.2), U166.6, U168.17 (I3b)
~S_ACK: U168.6 (I2a)
~S_BUSY: U168.8 (I3a)
~Z80_PAGE_{CS}: U152.10 (Q1b)

Notes on the sheet:
To Parallel Port
To U168 Control Readback Register
LPT Control Register - 37Eh
LPT Status Register - 37Dh
To NMI control PAL (page 2)
The Status and Control regsiters are split across two buffers, according to which signals need to be inverted. U153 supplies bits 2 & 3 of the status register, with bits 4-7 supplied by U168. U168 inverts its outputs.
Bits 7-5 of the LPT Control Register are typically undefined. Seequa has added some useful bits here to read the NMI and interrupt status.
Bank A: Read Select Bank B: Write Select
Bit 2 of the LPT Status Register is typically undefined. Seequa has added the LPT IRQ status bit here.
