dbalsom/seequa_chameleon/kicad/parts.kicad_sch

## KiCad design kicad/parts.kicad_sch (2026-05-13)

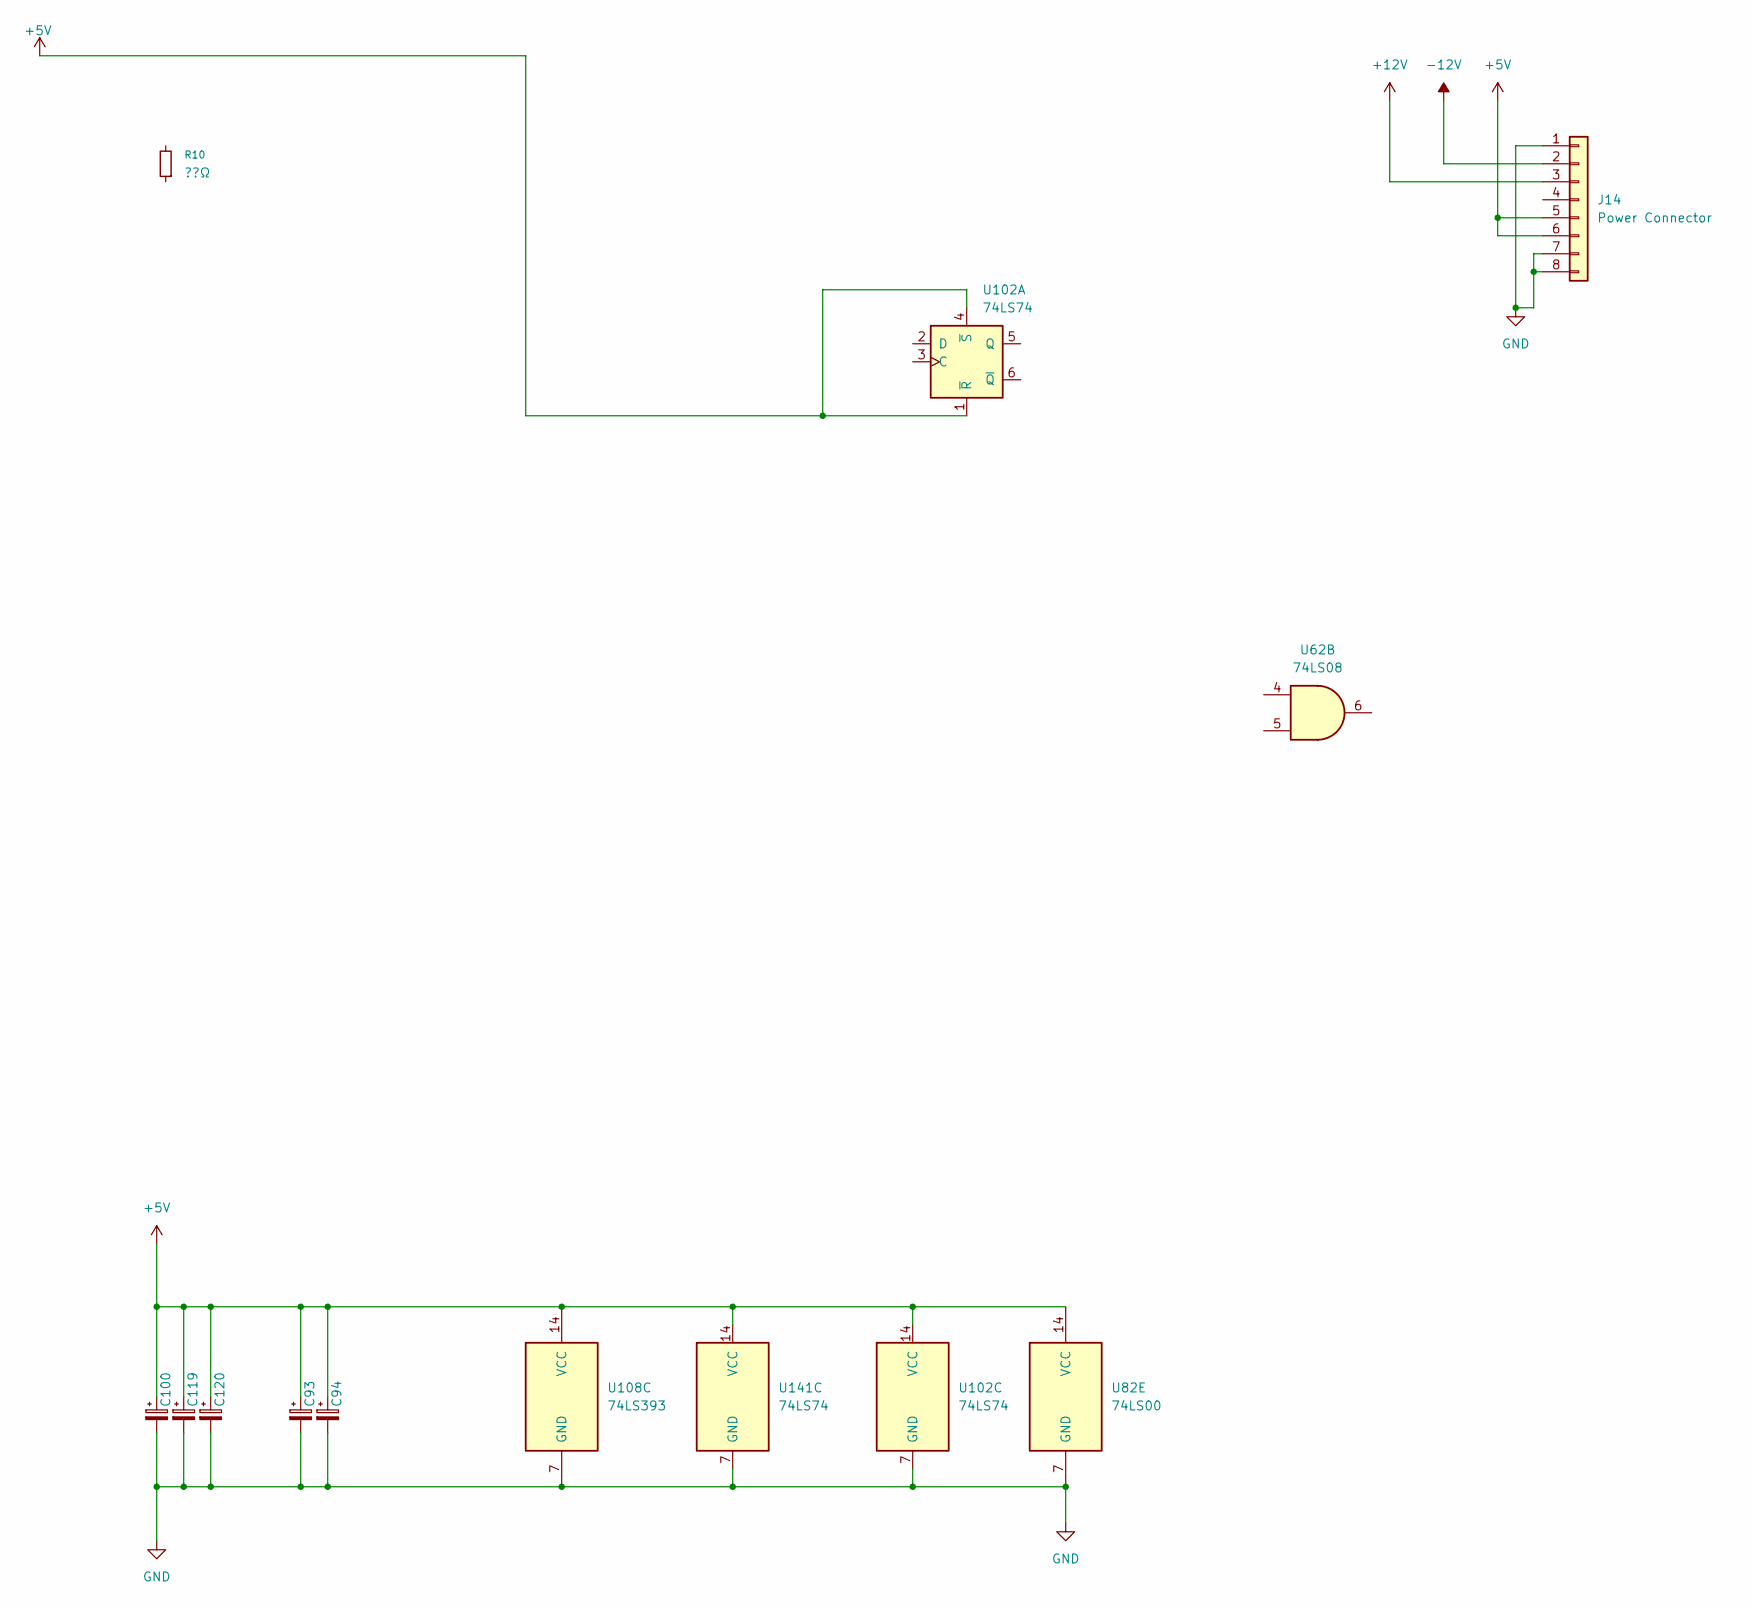
[picture p29: schematic parts.kicad_sch]

Parts:
C93, C94, C100, C119, C120: 0.1uF; C_Seequa_Bypass_2.54mm
J14: Power Connector; JST_VH_B8PS-VH_1x08_P3.96mm_Horizontal
R10: ??Ω; R_Seequa_Resistor
U62: 74LS08; DIP-14_W7.62mm
U82: 74LS00; DIP-14_W7.62mm
U102, U141: 74LS74; DIP-14_W7.62mm
U108: 74LS393; DIP-14_W7.62mm

Connections:
+5V: C93.1, C94.1, C100.1, C119.1, C120.1, J14.5, J14.6, U82.14 (VCC), U102.1 (~R), U102.4 (~S), U102.14 (VCC), U108.14 (VCC), U141.14 (VCC)
+12V: J14.3
-12V: J14.2
GND: C93.2, C94.2, C100.2, C119.2, C120.2, J14.1, J14.7, J14.8, U82.7 (GND), U102.7 (GND), U108.7 (GND), U141.7 (GND)
