dbalsom/seequa_chameleon/kicad/pic.kicad_sch

## KiCad design kicad/pic.kicad_sch (2026-05-13)

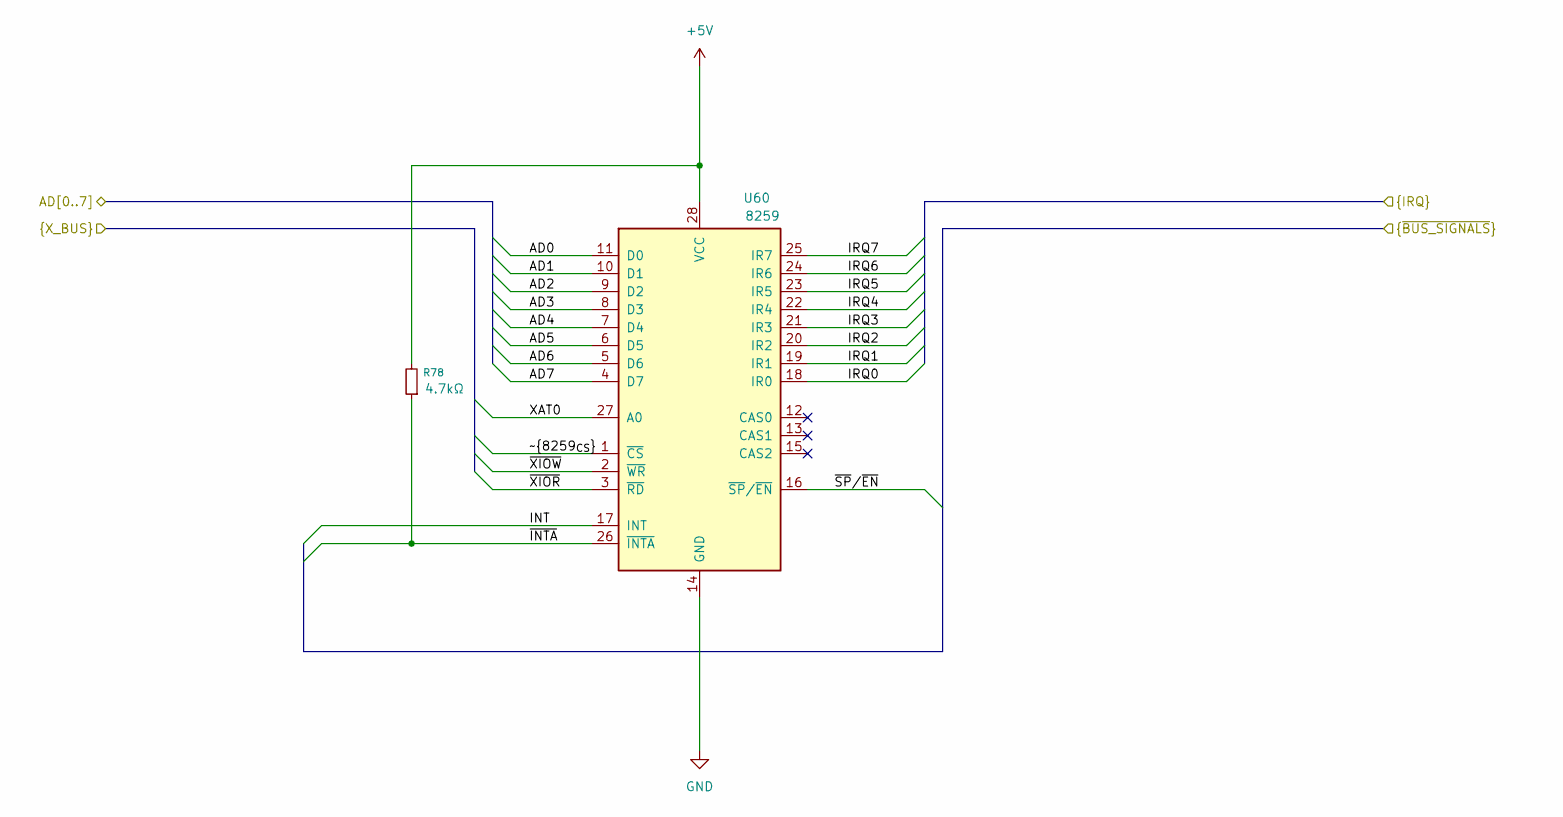
[picture p30: schematic pic.kicad_sch]

Parts:
R78: 4.7kΩ; R_Seequa_Resistor
U60: 8259; DIP-28_W15.24mm

Connections:
+5V: R78.2, U60.28 (VCC)
AD0: U60.11 (D0)
AD1: U60.10 (D1)
AD2: U60.9 (D2)
AD3: U60.8 (D3)
AD4: U60.7 (D4)
AD5: U60.6 (D5)
AD6: U60.5 (D6)
AD7: U60.4 (D7)
GND: U60.14 (GND)
INT: U60.17 (INT)
IRQ0: U60.18 (IR0)
IRQ1: U60.19 (IR1)
IRQ2: U60.20 (IR2)
IRQ3: U60.21 (IR3)
IRQ4: U60.22 (IR4)
IRQ5: U60.23 (IR5)
IRQ6: U60.24 (IR6)
IRQ7: U60.25 (IR7)
XAT0: U60.27 (A0)
~8259_{CS}: U60.1 (~CS)
~INTA: R78.1, U60.26 (~INTA)
~SP/~EN: U60.16 (~SP/~EN)
~XIOR: U60.3 (~RD)
~XIOW: U60.2 (~WR)
