dbalsom/seequa_chameleon/kicad/ram.kicad_sch

## KiCad design kicad/ram.kicad_sch (2026-05-13)

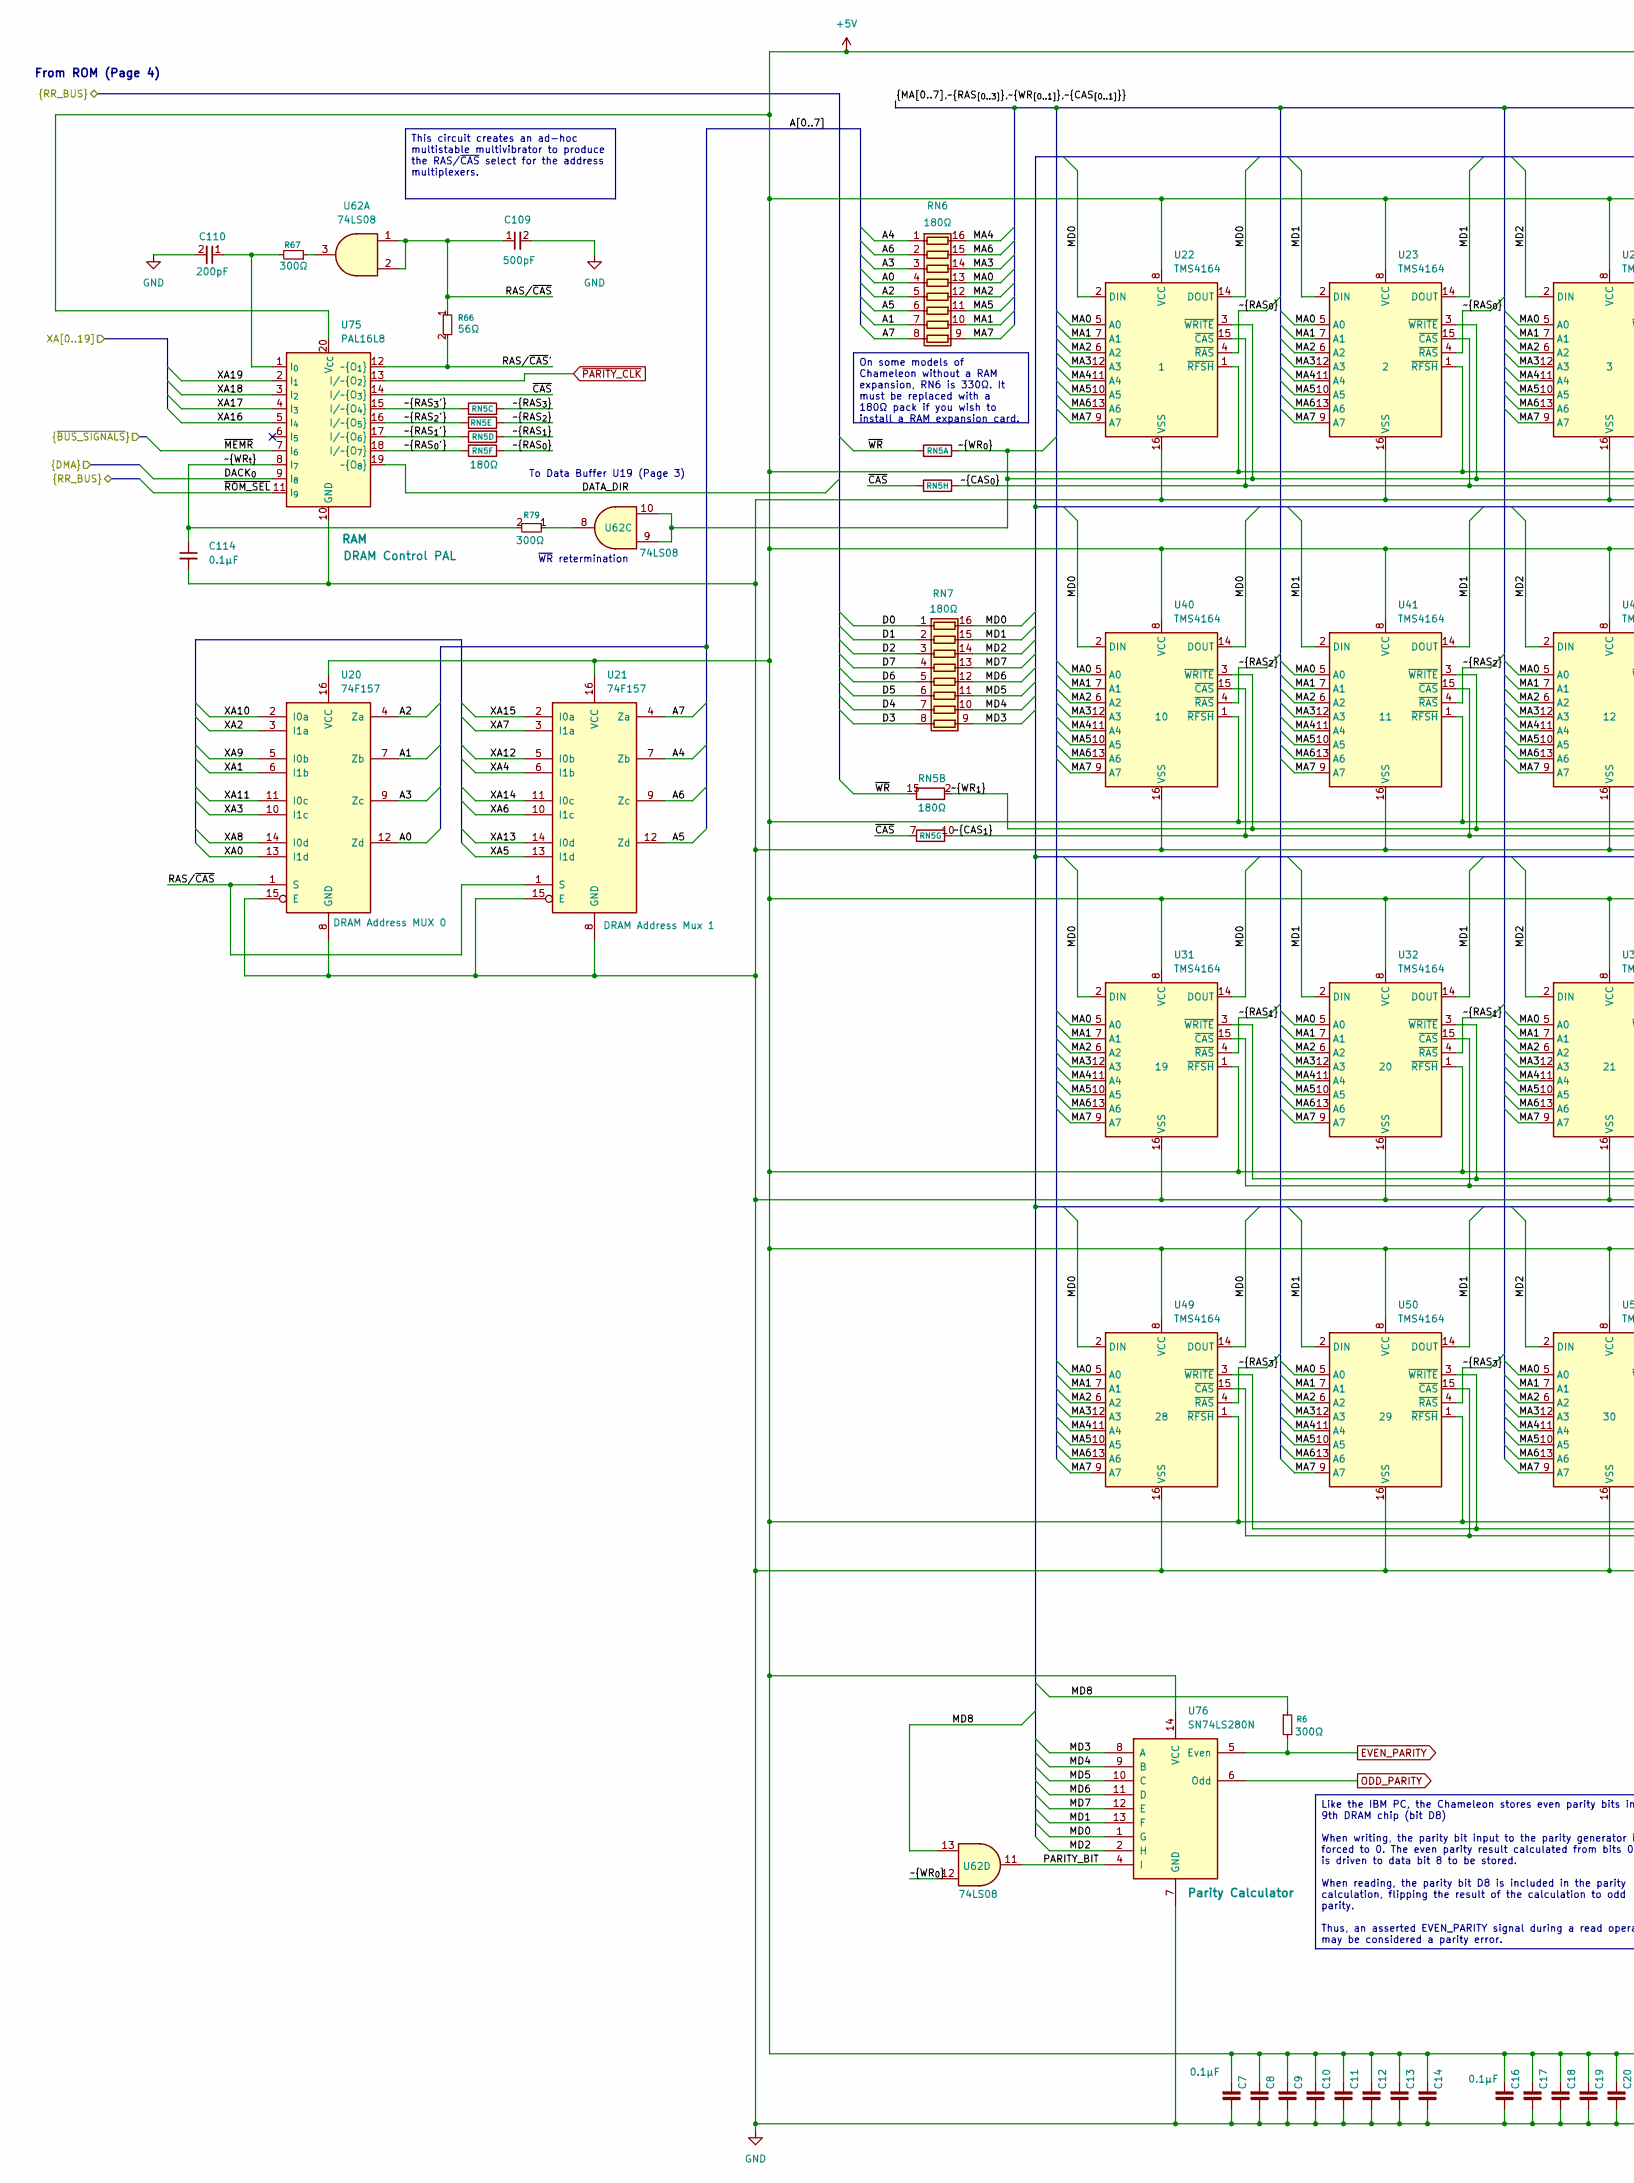
[picture p31: schematic ram.kicad_sch, part in row 1, column 1]

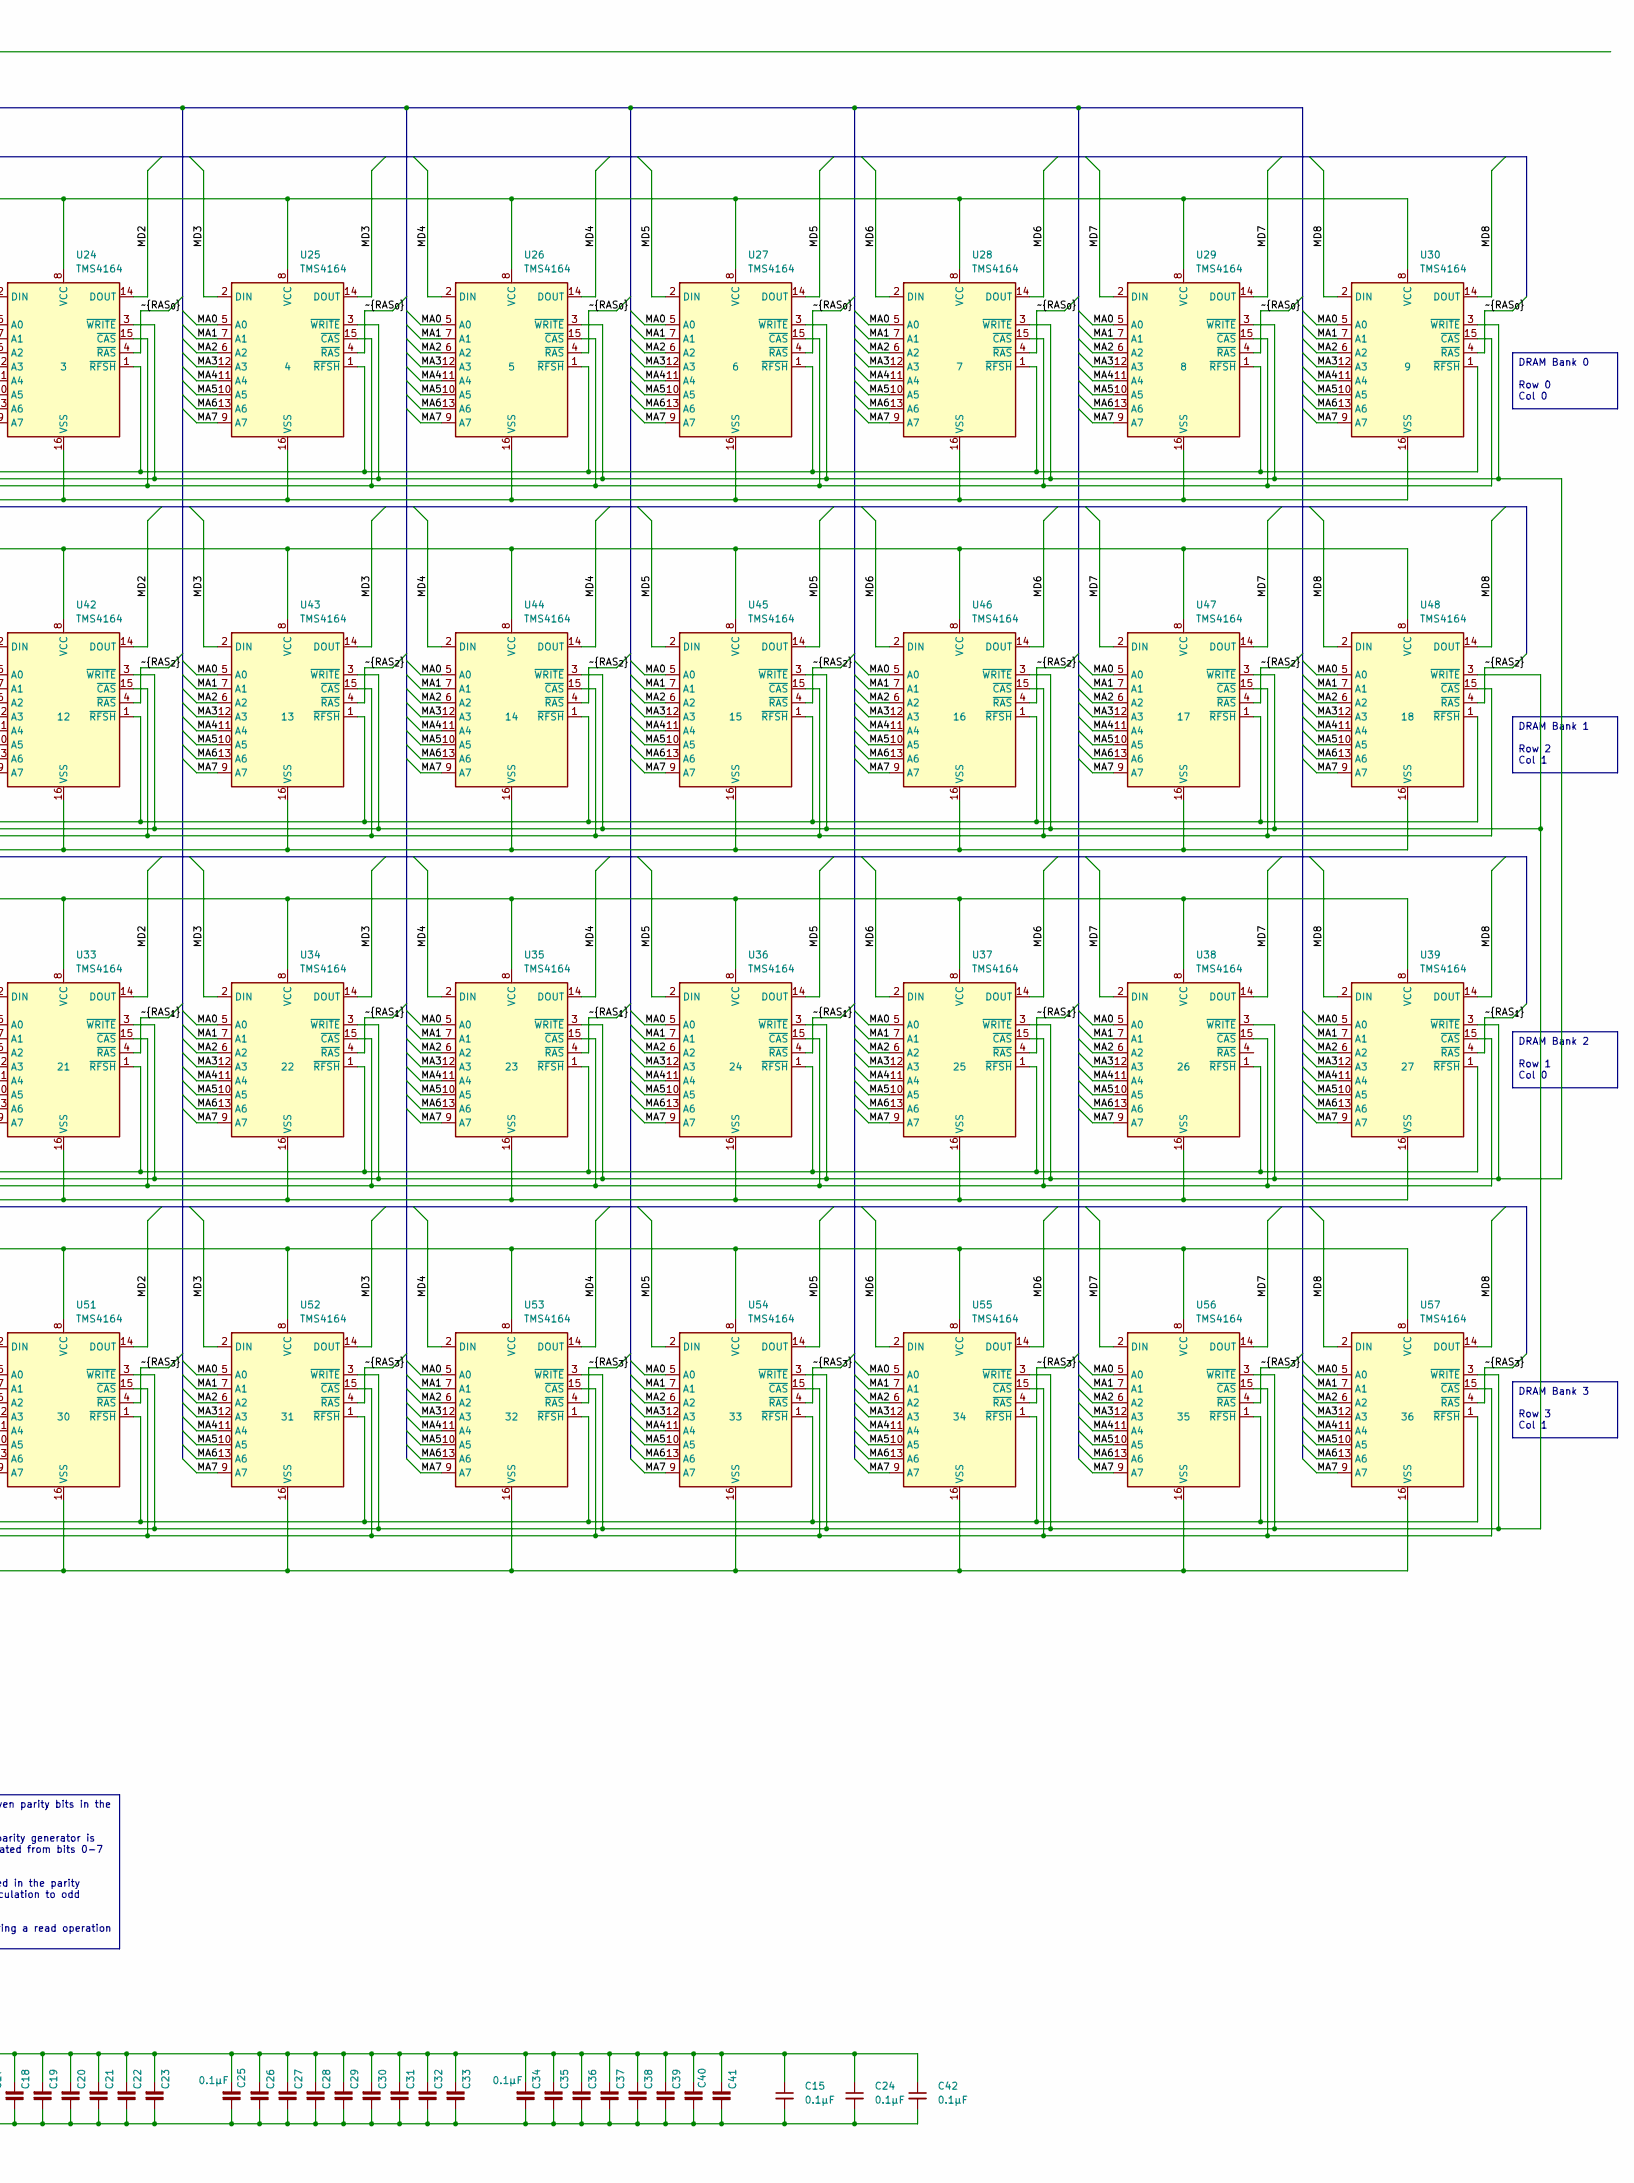
[picture p32: schematic ram.kicad_sch, part in row 1, column 2]

Parts:
C7, C15, C16, C24, C25, C34, C42: 0.1µF; C_Seequa_Bypass_Film_5mm
C8, C9, C10, C11, C12, C13, C14, C17, C18, C19, C20, C21, C22, C23, C26, C27, C28, C29, C30, C31, C32, C33, C35, C36, C37, C38, C39, C40, C41: C_Bypass_5mm; C_Seequa_Bypass_Film_5mm
C109: 500pF; C_Seequa_Bypass_6.5mm
C110: 200pF; C_Seequa_Bypass_6.5mm
C114: 0.1µF; C_Seequa_Bypass_6.5mm
R6, R67, R79: 300Ω; R_Seequa_Resistor
R66: 56Ω; R_Seequa_Resistor
RN5, RN6, RN7: 180Ω; DIP-16_W7.62mm
U20, U21: 74F157; DIP-16_W7.62mm
U22, U23, U24, U25, U26, U27, U28, U29, U30, U31, U32, U33, U34, U35, U36, U37, U38, U39, U40, U41, U42, U43, U44, U45, U46, U47, U48, U49, U50, U51, U52, U53, U54, U55, U56, U57: TMS4164; DIP-16_W7.62mm
U62: 74LS08; DIP-14_W7.62mm
U75: PAL16L8; DIP-20_W7.62mm
U76: SN74LS280N; DIP-14_W7.62mm

Connections:
+5V: C7.1, C8.1, C9.1, C10.1, C11.1, C12.1, C13.1, C14.1, C15.1, C16.1, C17.1, C18.1, C19.1, C20.1, C21.1, C22.1, C23.1, C24.1, C25.1, C26.1, C27.1, C28.1, C29.1, C30.1, C31.1, C32.1, C33.1, C34.1, C35.1, C36.1, C37.1, C38.1, C39.1, C40.1, C41.1, C42.1, U20.16 (VCC), U21.16 (VCC), U22.1 (~RFSH), U22.8 (VCC), U23.1 (~RFSH), U23.8 (VCC), U24.1 (~RFSH), U24.8 (VCC), U25.1 (~RFSH), U25.8 (VCC), U26.1 (~RFSH), U26.8 (VCC), U27.1 (~RFSH), U27.8 (VCC), U28.1 (~RFSH), U28.8 (VCC), U29.1 (~RFSH), U29.8 (VCC), U30.1 (~RFSH), U30.8 (VCC), U31.1 (~RFSH), U31.8 (VCC), U32.1 (~RFSH), U32.8 (VCC), U33.1 (~RFSH), U33.8 (VCC), U34.1 (~RFSH), U34.8 (VCC), U35.1 (~RFSH), U35.8 (VCC), U36.1 (~RFSH), U36.8 (VCC), U37.1 (~RFSH), U37.8 (VCC), U38.1 (~RFSH), U38.8 (VCC), U39.1 (~RFSH), U39.8 (VCC), U40.1 (~RFSH), U40.8 (VCC), U41.1 (~RFSH), U41.8 (VCC), U42.1 (~RFSH), U42.8 (VCC), U43.1 (~RFSH), U43.8 (VCC), U44.1 (~RFSH), U44.8 (VCC), U45.1 (~RFSH), U45.8 (VCC), U46.1 (~RFSH), U46.8 (VCC), U47.1 (~RFSH), U47.8 (VCC), U48.1 (~RFSH), U48.8 (VCC), U49.1 (~RFSH), U49.8 (VCC), U50.1 (~RFSH), U50.8 (VCC), U51.1 (~RFSH), U51.8 (VCC), U52.1 (~RFSH), U52.8 (VCC), U53.1 (~RFSH), U53.8 (VCC), U54.1 (~RFSH), U54.8 (VCC), U55.1 (~RFSH), U55.8 (VCC), U56.1 (~RFSH), U56.8 (VCC), U57.1 (~RFSH), U57.8 (VCC), U75.20 (V_{CC}), U76.14 (VCC)
A0: RN6.4 (R4.1), U20.12 (Zd)
A1: RN6.7 (R7.1), U20.7 (Zb)
A2: RN6.5 (R5.1), U20.4 (Za)
A3: RN6.3 (R3.1), U20.9 (Zc)
A4: RN6.1 (R1.1), U21.7 (Zb)
A5: RN6.6 (R6.1), U21.12 (Zd)
A6: RN6.2 (R2.1), U21.9 (Zc)
A7: RN6.8 (R8.1), U21.4 (Za)
D0: RN7.1 (R1.1)
D1: RN7.2 (R2.1)
D2: RN7.3 (R3.1)
D3: RN7.8 (R8.1)
D4: RN7.7 (R7.1)
D5: RN7.6 (R6.1)
D6: RN7.5 (R5.1)
D7: RN7.4 (R4.1)
DACK_{0}: U75.9 (I_{8})
DATA_DIR: U75.19 (~O_{8})
EVEN_PARITY: R6.2, U76.5 (Even)
GND: C7.2, C8.2, C9.2, C10.2, C11.2, C12.2, C13.2, C14.2, C15.2, C16.2, C17.2, C18.2, C19.2, C20.2, C21.2, C22.2, C23.2, C24.2, C25.2, C26.2, C27.2, C28.2, C29.2, C30.2, C31.2, C32.2, C33.2, C34.2, C35.2, C36.2, C37.2, C38.2, C39.2, C40.2, C41.2, C42.2, C109.2, C110.2, C114.2, U20.8 (GND), U20.15 (E), U21.8 (GND), U21.15 (E), U22.16 (VSS), U23.16 (VSS), U24.16 (VSS), U25.16 (VSS), U26.16 (VSS), U27.16 (VSS), U28.16 (VSS), U29.16 (VSS), U30.16 (VSS), U31.16 (VSS), U32.16 (VSS), U33.16 (VSS), U34.16 (VSS), U35.16 (VSS), U36.16 (VSS), U37.16 (VSS), U38.16 (VSS), U39.16 (VSS), U40.16 (VSS), U41.16 (VSS), U42.16 (VSS), U43.16 (VSS), U44.16 (VSS), U45.16 (VSS), U46.16 (VSS), U47.16 (VSS), U48.16 (VSS), U49.16 (VSS), U50.16 (VSS), U51.16 (VSS), U52.16 (VSS), U53.16 (VSS), U54.16 (VSS), U55.16 (VSS), U56.16 (VSS), U57.16 (VSS), U75.10 (GND), U76.7 (GND)
MA0: RN6.13 (R4.2), U22.5 (A0), U23.5 (A0), U24.5 (A0), U25.5 (A0), U26.5 (A0), U27.5 (A0), U28.5 (A0), U29.5 (A0), U30.5 (A0), U31.5 (A0), U32.5 (A0), U33.5 (A0), U34.5 (A0), U35.5 (A0), U36.5 (A0), U37.5 (A0), U38.5 (A0), U39.5 (A0), U40.5 (A0), U41.5 (A0), U42.5 (A0), U43.5 (A0), U44.5 (A0), U45.5 (A0), U46.5 (A0), U47.5 (A0), U48.5 (A0), U49.5 (A0), U50.5 (A0), U51.5 (A0), U52.5 (A0), U53.5 (A0), U54.5 (A0), U55.5 (A0), U56.5 (A0), U57.5 (A0)
MA1: RN6.10 (R7.2), U22.7 (A1), U23.7 (A1), U24.7 (A1), U25.7 (A1), U26.7 (A1), U27.7 (A1), U28.7 (A1), U29.7 (A1), U30.7 (A1), U31.7 (A1), U32.7 (A1), U33.7 (A1), U34.7 (A1), U35.7 (A1), U36.7 (A1), U37.7 (A1), U38.7 (A1), U39.7 (A1), U40.7 (A1), U41.7 (A1), U42.7 (A1), U43.7 (A1), U44.7 (A1), U45.7 (A1), U46.7 (A1), U47.7 (A1), U48.7 (A1), U49.7 (A1), U50.7 (A1), U51.7 (A1), U52.7 (A1), U53.7 (A1), U54.7 (A1), U55.7 (A1), U56.7 (A1), U57.7 (A1)
MA2: RN6.12 (R5.2), U22.6 (A2), U23.6 (A2), U24.6 (A2), U25.6 (A2), U26.6 (A2), U27.6 (A2), U28.6 (A2), U29.6 (A2), U30.6 (A2), U31.6 (A2), U32.6 (A2), U33.6 (A2), U34.6 (A2), U35.6 (A2), U36.6 (A2), U37.6 (A2), U38.6 (A2), U39.6 (A2), U40.6 (A2), U41.6 (A2), U42.6 (A2), U43.6 (A2), U44.6 (A2), U45.6 (A2), U46.6 (A2), U47.6 (A2), U48.6 (A2), U49.6 (A2), U50.6 (A2), U51.6 (A2), U52.6 (A2), U53.6 (A2), U54.6 (A2), U55.6 (A2), U56.6 (A2), U57.6 (A2)
MA3: RN6.14 (R3.2), U22.12 (A3), U23.12 (A3), U24.12 (A3), U25.12 (A3), U26.12 (A3), U27.12 (A3), U28.12 (A3), U29.12 (A3), U30.12 (A3), U31.12 (A3), U32.12 (A3), U33.12 (A3), U34.12 (A3), U35.12 (A3), U36.12 (A3), U37.12 (A3), U38.12 (A3), U39.12 (A3), U40.12 (A3), U41.12 (A3), U42.12 (A3), U43.12 (A3), U44.12 (A3), U45.12 (A3), U46.12 (A3), U47.12 (A3), U48.12 (A3), U49.12 (A3), U50.12 (A3), U51.12 (A3), U52.12 (A3), U53.12 (A3), U54.12 (A3), U55.12 (A3), U56.12 (A3), U57.12 (A3)
MA4: RN6.16 (R1.2), U22.11 (A4), U23.11 (A4), U24.11 (A4), U25.11 (A4), U26.11 (A4), U27.11 (A4), U28.11 (A4), U29.11 (A4), U30.11 (A4), U31.11 (A4), U32.11 (A4), U33.11 (A4), U34.11 (A4), U35.11 (A4), U36.11 (A4), U37.11 (A4), U38.11 (A4), U39.11 (A4), U40.11 (A4), U41.11 (A4), U42.11 (A4), U43.11 (A4), U44.11 (A4), U45.11 (A4), U46.11 (A4), U47.11 (A4), U48.11 (A4), U49.11 (A4), U50.11 (A4), U51.11 (A4), U52.11 (A4), U53.11 (A4), U54.11 (A4), U55.11 (A4), U56.11 (A4), U57.11 (A4)
MA5: RN6.11 (R6.2), U22.10 (A5), U23.10 (A5), U24.10 (A5), U25.10 (A5), U26.10 (A5), U27.10 (A5), U28.10 (A5), U29.10 (A5), U30.10 (A5), U31.10 (A5), U32.10 (A5), U33.10 (A5), U34.10 (A5), U35.10 (A5), U36.10 (A5), U37.10 (A5), U38.10 (A5), U39.10 (A5), U40.10 (A5), U41.10 (A5), U42.10 (A5), U43.10 (A5), U44.10 (A5), U45.10 (A5), U46.10 (A5), U47.10 (A5), U48.10 (A5), U49.10 (A5), U50.10 (A5), U51.10 (A5), U52.10 (A5), U53.10 (A5), U54.10 (A5), U55.10 (A5), U56.10 (A5), U57.10 (A5)
MA6: RN6.15 (R2.2), U22.13 (A6), U23.13 (A6), U24.13 (A6), U25.13 (A6), U26.13 (A6), U27.13 (A6), U28.13 (A6), U29.13 (A6), U30.13 (A6), U31.13 (A6), U32.13 (A6), U33.13 (A6), U34.13 (A6), U35.13 (A6), U36.13 (A6), U37.13 (A6), U38.13 (A6), U39.13 (A6), U40.13 (A6), U41.13 (A6), U42.13 (A6), U43.13 (A6), U44.13 (A6), U45.13 (A6), U46.13 (A6), U47.13 (A6), U48.13 (A6), U49.13 (A6), U50.13 (A6), U51.13 (A6), U52.13 (A6), U53.13 (A6), U54.13 (A6), U55.13 (A6), U56.13 (A6), U57.13 (A6)
MA7: RN6.9 (R8.2), U22.9 (A7), U23.9 (A7), U24.9 (A7), U25.9 (A7), U26.9 (A7), U27.9 (A7), U28.9 (A7), U29.9 (A7), U30.9 (A7), U31.9 (A7), U32.9 (A7), U33.9 (A7), U34.9 (A7), U35.9 (A7), U36.9 (A7), U37.9 (A7), U38.9 (A7), U39.9 (A7), U40.9 (A7), U41.9 (A7), U42.9 (A7), U43.9 (A7), U44.9 (A7), U45.9 (A7), U46.9 (A7), U47.9 (A7), U48.9 (A7), U49.9 (A7), U50.9 (A7), U51.9 (A7), U52.9 (A7), U53.9 (A7), U54.9 (A7), U55.9 (A7), U56.9 (A7), U57.9 (A7)
MD0: RN7.16 (R1.2), U22.2 (DIN), U22.14 (DOUT), U31.2 (DIN), U31.14 (DOUT), U40.2 (DIN), U40.14 (DOUT), U49.2 (DIN), U49.14 (DOUT), U76.1 (G)
MD1: RN7.15 (R2.2), U23.2 (DIN), U23.14 (DOUT), U32.2 (DIN), U32.14 (DOUT), U41.2 (DIN), U41.14 (DOUT), U50.2 (DIN), U50.14 (DOUT), U76.13 (F)
MD2: RN7.14 (R3.2), U24.2 (DIN), U24.14 (DOUT), U33.2 (DIN), U33.14 (DOUT), U42.2 (DIN), U42.14 (DOUT), U51.2 (DIN), U51.14 (DOUT), U76.2 (H)
MD3: RN7.9 (R8.2), U25.2 (DIN), U25.14 (DOUT), U34.2 (DIN), U34.14 (DOUT), U43.2 (DIN), U43.14 (DOUT), U52.2 (DIN), U52.14 (DOUT), U76.8 (A)
MD4: RN7.10 (R7.2), U26.2 (DIN), U26.14 (DOUT), U35.2 (DIN), U35.14 (DOUT), U44.2 (DIN), U44.14 (DOUT), U53.2 (DIN), U53.14 (DOUT), U76.9 (B)
MD5: RN7.11 (R6.2), U27.2 (DIN), U27.14 (DOUT), U36.2 (DIN), U36.14 (DOUT), U45.2 (DIN), U45.14 (DOUT), U54.2 (DIN), U54.14 (DOUT), U76.10 (C)
MD6: RN7.12 (R5.2), U28.2 (DIN), U28.14 (DOUT), U37.2 (DIN), U37.14 (DOUT), U46.2 (DIN), U46.14 (DOUT), U55.2 (DIN), U55.14 (DOUT), U76.11 (D)
MD7: RN7.13 (R4.2), U29.2 (DIN), U29.14 (DOUT), U38.2 (DIN), U38.14 (DOUT), U47.2 (DIN), U47.14 (DOUT), U56.2 (DIN), U56.14 (DOUT), U76.12 (E)
MD8: R6.1, U30.2 (DIN), U30.14 (DOUT), U39.2 (DIN), U39.14 (DOUT), U48.2 (DIN), U48.14 (DOUT), U57.2 (DIN), U57.14 (DOUT), U62.13
unnamed: C110.1, R67.2, U75.1 (I_{0})
unnamed: R67.1, U62.3
unnamed: R79.1, U62.8
unnamed: U31.15 (~CAS), U32.15 (~CAS), U33.15 (~CAS), U34.15 (~CAS), U35.15 (~CAS), U36.15 (~CAS), U37.15 (~CAS), U38.15 (~CAS), U39.15 (~CAS)
unnamed: U49.15 (~CAS), U50.15 (~CAS), U51.15 (~CAS), U52.15 (~CAS), U53.15 (~CAS), U54.15 (~CAS), U55.15 (~CAS), U56.15 (~CAS), U57.15 (~CAS)
ODD_PARITY: U76.6 (Odd)
PARITY_BIT: U62.11, U76.4 (I)
RAS/~CAS': R66.2, U75.12 (~O_{1})
RAS/~CAS: C109.1, R66.1, U20.1 (S), U21.1 (S), U62.1, U62.2
XA0: U20.13 (I1d)
XA1: U20.6 (I1b)
XA2: U20.3 (I1a)
XA3: U20.10 (I1c)
XA4: U21.6 (I1b)
XA5: U21.13 (I1d)
XA6: U21.10 (I1c)
XA7: U21.3 (I1a)
XA8: U20.14 (I0d)
XA9: U20.5 (I0b)
XA10: U20.2 (I0a)
XA11: U20.11 (I0c)
XA12: U21.5 (I0b)
XA13: U21.14 (I0d)
XA14: U21.11 (I0c)
XA15: U21.2 (I0a)
XA16: U75.5 (I_{4})
XA17: U75.4 (I_{3})
XA18: U75.3 (I_{2})
XA19: U75.2 (I_{1})
~CAS_{0}: RN5.9 (R8.2), U22.15 (~CAS), U23.15 (~CAS), U24.15 (~CAS), U25.15 (~CAS), U26.15 (~CAS), U27.15 (~CAS), U28.15 (~CAS), U29.15 (~CAS), U30.15 (~CAS)
~CAS_{1}: RN5.10 (R7.2), U40.15 (~CAS), U41.15 (~CAS), U42.15 (~CAS), U43.15 (~CAS), U44.15 (~CAS), U45.15 (~CAS), U46.15 (~CAS), U47.15 (~CAS), U48.15 (~CAS)
~CAS: RN5.7 (R7.1), RN5.8 (R8.1), U75.14 (I/~O_{3})
~MEMR: U75.7 (I_{6})
~PARITY_CLK: U75.13 (I/~O_{2})
~RAS_{0'}: RN5.11 (R6.2), U75.18 (I/~O_{7})
~RAS_{0}: RN5.6 (R6.1), U22.4 (~RAS), U23.4 (~RAS), U24.4 (~RAS), U25.4 (~RAS), U26.4 (~RAS), U27.4 (~RAS), U28.4 (~RAS), U29.4 (~RAS), U30.4 (~RAS)
~RAS_{1'}: RN5.4 (R4.1), U75.17 (I/~O_{6})
~RAS_{1}: RN5.13 (R4.2), U31.4 (~RAS), U32.4 (~RAS), U33.4 (~RAS), U34.4 (~RAS), U35.4 (~RAS), U36.4 (~RAS), U37.4 (~RAS), U39.4 (~RAS)
~RAS_{2'}: RN5.12 (R5.2), U75.16 (I/~O_{5})
~RAS_{2}: RN5.5 (R5.1), U40.4 (~RAS), U41.4 (~RAS), U42.4 (~RAS), U43.4 (~RAS), U44.4 (~RAS), U45.4 (~RAS), U46.4 (~RAS), U47.4 (~RAS), U48.4 (~RAS)
~RAS_{3'}: RN5.3 (R3.1), U75.15 (I/~O_{4})
~RAS_{3}: RN5.14 (R3.2), U49.4 (~RAS), U50.4 (~RAS), U51.4 (~RAS), U52.4 (~RAS), U53.4 (~RAS), U54.4 (~RAS), U55.4 (~RAS), U56.4 (~RAS), U57.4 (~RAS)
~ROM_SEL: U75.11 (I_{9})
~WR_{0}: RN5.1 (R1.1), U22.3 (~WRITE), U23.3 (~WRITE), U24.3 (~WRITE), U25.3 (~WRITE), U26.3 (~WRITE), U27.3 (~WRITE), U28.3 (~WRITE), U29.3 (~WRITE), U30.3 (~WRITE), U31.3 (~WRITE), U32.3 (~WRITE), U33.3 (~WRITE), U34.3 (~WRITE), U35.3 (~WRITE), U36.3 (~WRITE), U37.3 (~WRITE), U38.3 (~WRITE), U39.3 (~WRITE), U62.9, U62.10, U62.12
~WR_{1}: RN5.2 (R2.1), U40.3 (~WRITE), U41.3 (~WRITE), U42.3 (~WRITE), U43.3 (~WRITE), U44.3 (~WRITE), U45.3 (~WRITE), U46.3 (~WRITE), U47.3 (~WRITE), U48.3 (~WRITE), U49.3 (~WRITE), U50.3 (~WRITE), U51.3 (~WRITE), U52.3 (~WRITE), U53.3 (~WRITE), U54.3 (~WRITE), U55.3 (~WRITE), U56.3 (~WRITE), U57.3 (~WRITE)
~WR_{t}: C114.1, R79.2, U75.8 (I_{7})
~WR: RN5.15 (R2.2), RN5.16 (R1.2)

Notes on the sheet:
~{WR} retermination
To Data Buffer U19 (Page 3)
From ROM (Page 4)
DRAM Bank 1 Row 2 Col 1
Like the IBM PC, the Chameleon stores even parity bits in the 9th DRAM chip (bit D8) When writing, the parity bit input to the parity generator is forced to 0. The even parity result calculated from bits 0-7 is driven to data bit 8 to be stored. When reading, the parity bit D8 is included in the pa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
DRAM Bank 2 Row 1 Col 0
This circuit creates an ad-hoc multistable multivibrator to produce the RAS/~{CAS} select for the address multiplexers.
DRAM Bank 0 Row 0 Col 0
DRAM Bank 3 Row 3 Col 1
On some models of Chameleon without a RAM expansion, RN6 is 330Ω. It must be replaced with a 180Ω pack if you wish to install a RAM expansion card.
