dbalsom/seequa_chameleon/kicad/rasterization.kicad_sch

## KiCad design kicad/rasterization.kicad_sch (2026-05-13)

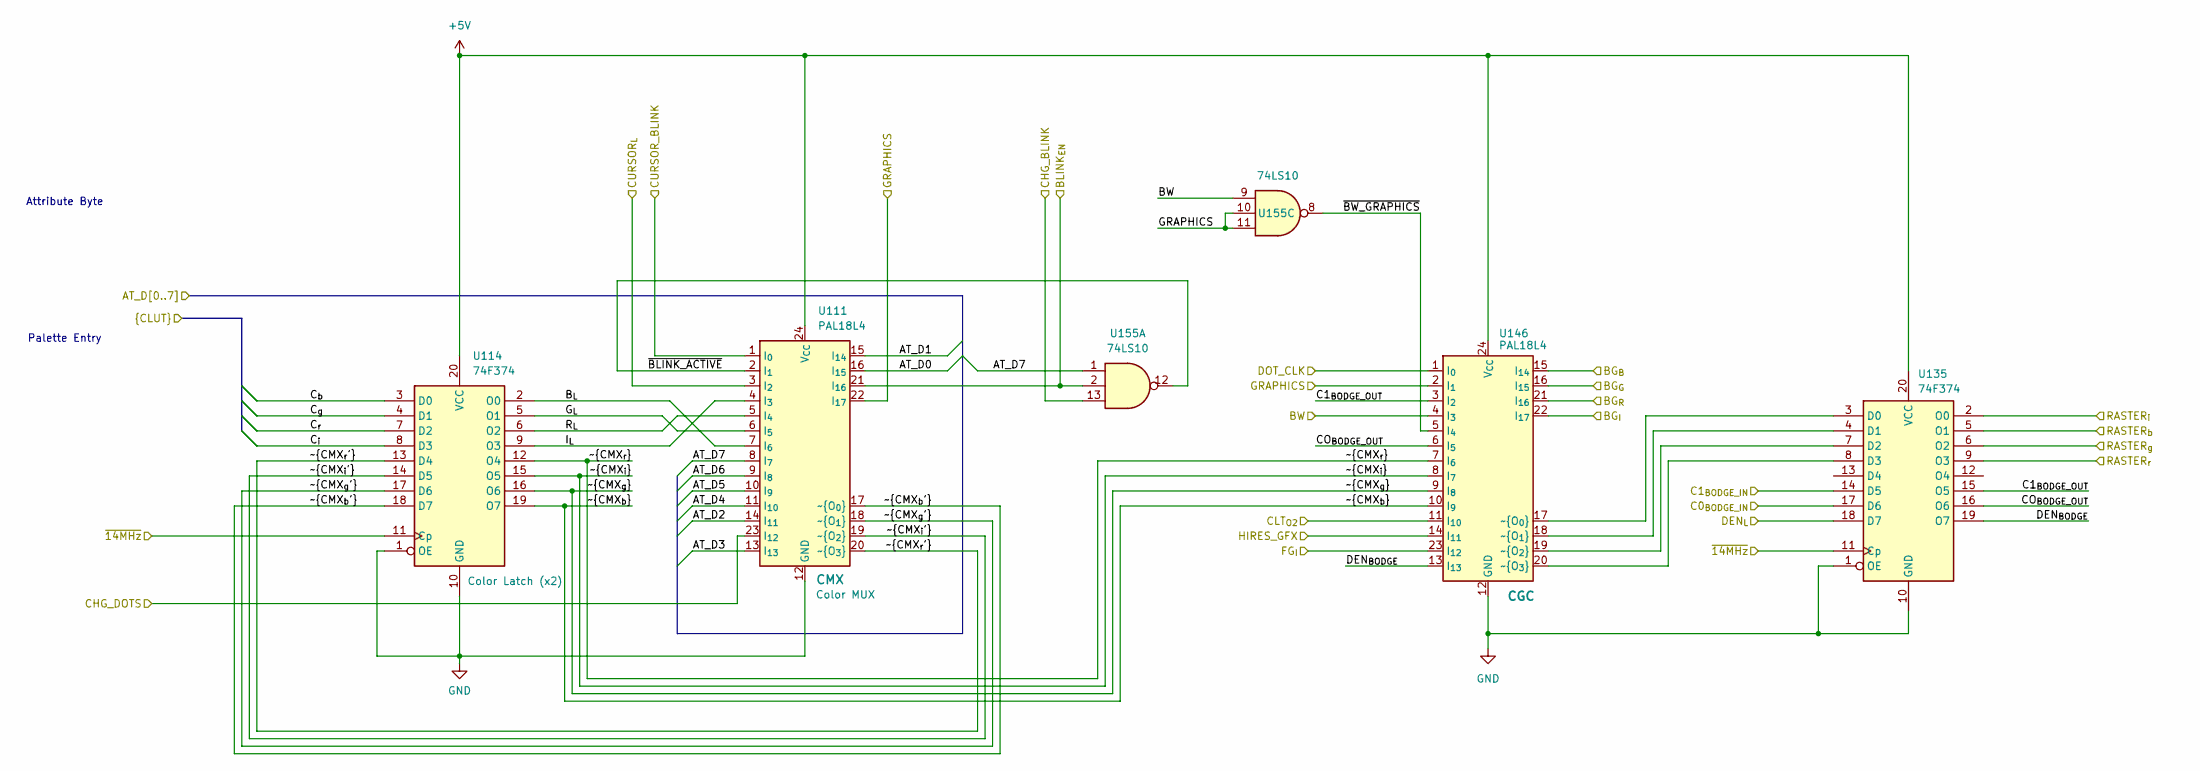
[picture p33: schematic rasterization.kicad_sch]

Parts:
U111, U146: PAL18L4; DIP-24_W7.62mm
U114, U135: 74F374; DIP-20_W7.62mm
U155: 74LS10; DIP-14_W7.62mm

Connections:
+5V: U111.24 (V_{CC}), U114.20 (VCC), U135.20 (VCC), U146.24 (V_{CC})
AT_D0: U111.16 (I_{15})
AT_D1: U111.15 (I_{14})
AT_D2: U111.14 (I_{11})
AT_D3: U111.13 (I_{13})
AT_D4: U111.11 (I_{10})
AT_D5: U111.10 (I_{9})
AT_D6: U111.9 (I_{8})
AT_D7: U111.8 (I_{7}), U155.1
BG_{B}: U146.15 (I_{14})
BG_{G}: U146.16 (I_{15})
BG_{I}: U146.22 (I_{17})
BG_{R}: U146.21 (I_{16})
BLINK_{EN}: U111.21 (I_{16}), U155.2
BW: U146.4 (I_{3}), U155.9
B_{L}: U111.7 (I_{6}), U114.2 (O0)
C0_{BODGE_IN}: U135.17 (D6)
C1_{BODGE_IN}: U135.14 (D5)
C1_{BODGE_OUT}: U135.15 (O5), U146.3 (I_{2})
CHG_BLINK: U155.13
CHG_DOTS: U111.23 (I_{12})
CLT_{O2}: U146.11 (I_{10})
CO_{BODGE_OUT}: U135.16 (O6), U146.6 (I_{5})
CURSOR_BLINK: U111.1 (I_{0})
CURSOR_{L}: U111.3 (I_{2})
C_{b}: U114.3 (D0)
C_{g}: U114.4 (D1)
C_{i}: U114.8 (D3)
C_{r}: U114.7 (D2)
DEN_{BODGE}: U135.19 (O7), U146.13 (I_{13})
DEN_{L}: U135.18 (D7)
DOT_CLK: U146.1 (I_{0})
FG_{I}: U146.23 (I_{12})
GND: U111.12 (GND), U114.1 (OE), U114.10 (GND), U135.1 (OE), U135.10 (GND), U146.12 (GND)
GRAPHICS: U111.22 (I_{17}), U146.2 (I_{1}), U155.10, U155.11
G_{L}: U111.6 (I_{5}), U114.5 (O1)
HIRES_GFX: U146.14 (I_{11})
I_{L}: U111.4 (I_{3}), U114.9 (O3)
unnamed: U135.3 (D0), U146.17 (~O_{0})
unnamed: U135.4 (D1), U146.18 (~O_{1})
unnamed: U135.7 (D2), U146.19 (~O_{2})
unnamed: U135.8 (D3), U146.20 (~O_{3})
RASTER_{b}: U135.5 (O1)
RASTER_{g}: U135.6 (O2)
RASTER_{i}: U135.2 (O0)
RASTER_{r}: U135.9 (O3)
R_{L}: U111.5 (I_{4}), U114.6 (O2)
~14MHz: U114.11 (Cp), U135.11 (Cp)
~BLINK_ACTIVE: U111.2 (I_{1}), U155.12
~BW_GRAPHICS: U146.5 (I_{4}), U155.8
~CMX_{b'}: U111.17 (~O_{0}), U114.18 (D7)
~CMX_{b}: U114.19 (O7), U146.10 (I_{9})
~CMX_{g'}: U111.18 (~O_{1}), U114.17 (D6)
~CMX_{g}: U114.16 (O6), U146.9 (I_{8})
~CMX_{i'}: U111.19 (~O_{2}), U114.14 (D5)
~CMX_{i}: U114.15 (O5), U146.8 (I_{7})
~CMX_{r'}: U111.20 (~O_{3}), U114.13 (D4)
~CMX_{r}: U114.12 (O4), U146.7 (I_{6})

Notes on the sheet:
Palette Entry
Attribute Byte
