dbalsom/seequa_chameleon/kicad/rom.kicad_sch

## KiCad design kicad/rom.kicad_sch (2026-05-13)

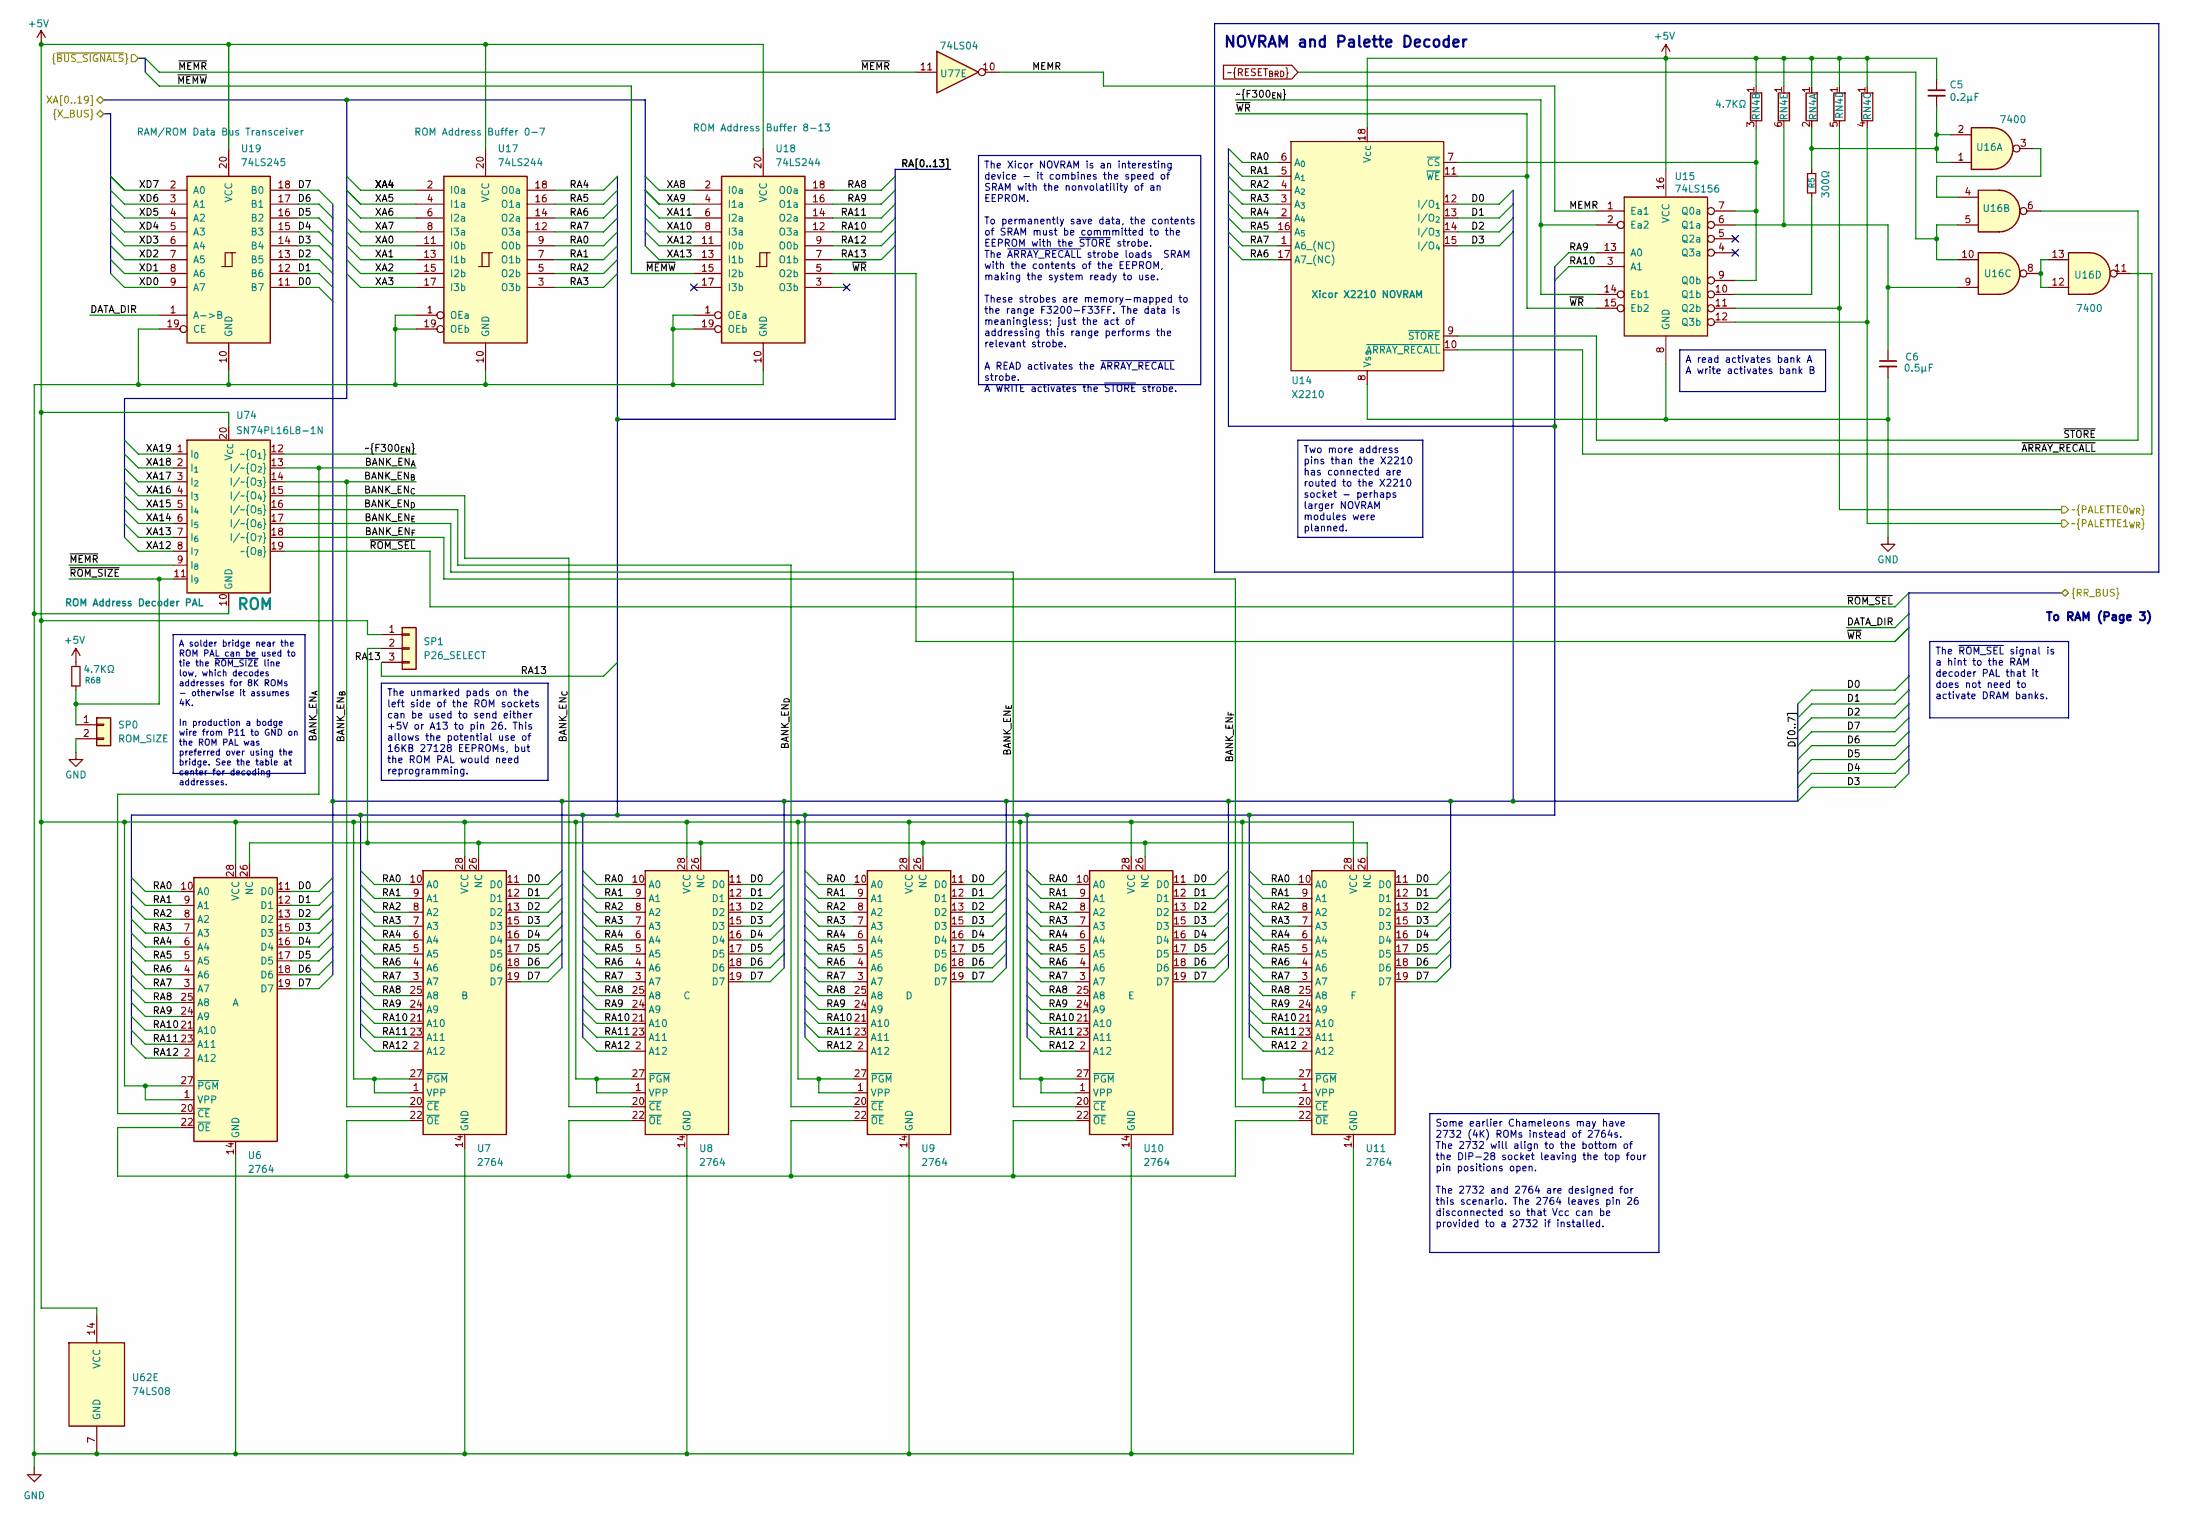
[picture p34: schematic rom.kicad_sch]

Parts:
C5: 0.2µF; C_Seequa_Bypass_6.5mm
C6: 0.5µF; C_Seequa_Bypass_6.5mm
R5: 300Ω; R_Seequa_Resistor
R68: 4.7KΩ; R_Seequa_Resistor
RN4: 4.7KΩ; R_Array_SIP6
SP0: ROM_SIZE; PinHeader_1x02_P2.54mm_Vertical
SP1: P26_SELECT; PinHeader_1x03_P2.54mm_Vertical
U6, U7, U8, U9, U10, U11: 2764; DIP-28_W15.24mm
U14: X2210; DIP-18_W7.62mm_Socket
U15: 74LS156; DIP-16_W7.62mm
U16: 7400; DIP-14_W7.62mm
U17, U18: 74LS244; DIP-20_W7.62mm
U19: 74LS245; DIP-20_W7.62mm
U62: 74LS08; DIP-14_W7.62mm
U74: SN74PL16L8-1N; DIP-20_W7.62mm
U77: 74LS04; DIP-14_W7.62mm

Connections:
+5V: C5.1, R68.2, RN4.1 (R1), SP1.1, U6.1 (VPP), U6.27 (~PGM), U6.28 (VCC), U7.1 (VPP), U7.27 (~PGM), U7.28 (VCC), U8.1 (VPP), U8.27 (~PGM), U8.28 (VCC), U9.1 (VPP), U9.27 (~PGM), U9.28 (VCC), U10.1 (VPP), U10.27 (~PGM), U10.28 (VCC), U11.1 (VPP), U11.27 (~PGM), U11.28 (VCC), U14.18 (Vcc), U15.16 (VCC), U17.20 (VCC), U18.20 (VCC), U19.20 (VCC), U62.14 (VCC), U74.20 (V_{CC})
BANK_EN_{A}: U6.20 (~CE), U74.13 (I/~O_{2})
BANK_EN_{B}: U7.20 (~CE), U74.14 (I/~O_{3})
BANK_EN_{C}: U8.20 (~CE), U74.15 (I/~O_{4})
BANK_EN_{D}: U9.20 (~CE), U74.16 (I/~O_{5})
BANK_EN_{E}: U10.20 (~CE), U74.17 (I/~O_{6})
BANK_EN_{F}: U11.20 (~CE), U74.18 (I/~O_{7})
D0: U6.11 (D0), U7.11 (D0), U8.11 (D0), U9.11 (D0), U10.11 (D0), U11.11 (D0), U14.12 (I/O_{1}), U19.11 (B7)
D1: U6.12 (D1), U7.12 (D1), U8.12 (D1), U9.12 (D1), U10.12 (D1), U11.12 (D1), U14.13 (I/O_{2}), U19.12 (B6)
D2: U6.13 (D2), U7.13 (D2), U8.13 (D2), U9.13 (D2), U10.13 (D2), U11.13 (D2), U14.14 (I/O_{3}), U19.13 (B5)
D3: U6.15 (D3), U7.15 (D3), U8.15 (D3), U9.15 (D3), U10.15 (D3), U11.15 (D3), U14.15 (I/O_{4}), U19.14 (B4)
D4: U6.16 (D4), U7.16 (D4), U8.16 (D4), U9.16 (D4), U10.16 (D4), U11.16 (D4), U19.15 (B3)
D5: U6.17 (D5), U7.17 (D5), U8.17 (D5), U9.17 (D5), U10.17 (D5), U11.17 (D5), U19.16 (B2)
D6: U6.18 (D6), U7.18 (D6), U8.18 (D6), U9.18 (D6), U10.18 (D6), U11.18 (D6), U19.17 (B1)
D7: U6.19 (D7), U7.19 (D7), U8.19 (D7), U9.19 (D7), U10.19 (D7), U11.19 (D7), U19.18 (B0)
DATA_DIR: U19.1 (A->B)
GND: C6.2, SP0.2, U6.14 (GND), U7.14 (GND), U8.14 (GND), U9.14 (GND), U10.14 (GND), U11.14 (GND), U14.8 (Vss), U15.8 (GND), U17.1 (OEa), U17.10 (GND), U17.19 (OEb), U18.1 (OEa), U18.10 (GND), U18.19 (OEb), U19.10 (GND), U19.19 (CE), U62.7 (GND), U74.10 (GND)
MEMR: U15.1 (Ea1), U77.10
unnamed: C5.2, R5.1, RN4.2 (R1.2), U16.1, U16.2
unnamed: C6.1, RN4.6 (R5.2), U15.6 (Q1a), U16.9
unnamed: R5.2, U15.10 (Q1b)
unnamed: RN4.3 (R2.2), U14.7 (~CS), U15.7 (Q0a), U15.9 (Q0b)
unnamed: SP1.2, U6.26 (NC), U7.26 (NC), U8.26 (NC), U9.26 (NC), U10.26 (NC), U11.26 (NC)
unnamed: U6.22 (~OE), U7.22 (~OE), U8.22 (~OE), U9.22 (~OE), U10.22 (~OE), U11.22 (~OE)
unnamed: U16.3, U16.4
unnamed: U16.8, U16.12, U16.13
RA0: U6.10 (A0), U7.10 (A0), U8.10 (A0), U9.10 (A0), U10.10 (A0), U11.10 (A0), U14.6 (A_{0}), U17.9 (O0b)
RA1: U6.9 (A1), U7.9 (A1), U8.9 (A1), U9.9 (A1), U10.9 (A1), U11.9 (A1), U14.5 (A_{1}), U17.7 (O1b)
RA2: U6.8 (A2), U7.8 (A2), U8.8 (A2), U9.8 (A2), U10.8 (A2), U11.8 (A2), U14.4 (A_{2}), U17.5 (O2b)
RA3: U6.7 (A3), U7.7 (A3), U8.7 (A3), U9.7 (A3), U10.7 (A3), U11.7 (A3), U14.3 (A_{3}), U17.3 (O3b)
RA4: U6.6 (A4), U7.6 (A4), U8.6 (A4), U9.6 (A4), U10.6 (A4), U11.6 (A4), U14.2 (A_{4}), U17.18 (O0a)
RA5: U6.5 (A5), U7.5 (A5), U8.5 (A5), U9.5 (A5), U10.5 (A5), U11.5 (A5), U14.16 (A_{5}), U17.16 (O1a)
RA6: U6.4 (A6), U7.4 (A6), U8.4 (A6), U9.4 (A6), U10.4 (A6), U11.4 (A6), U14.17 (A7_(NC)), U17.14 (O2a)
RA7: U6.3 (A7), U7.3 (A7), U8.3 (A7), U9.3 (A7), U10.3 (A7), U11.3 (A7), U14.1 (A6_(NC)), U17.12 (O3a)
RA8: U6.25 (A8), U7.25 (A8), U8.25 (A8), U9.25 (A8), U10.25 (A8), U11.25 (A8), U18.18 (O0a)
RA9: U6.24 (A9), U7.24 (A9), U8.24 (A9), U9.24 (A9), U10.24 (A9), U11.24 (A9), U15.13 (A0), U18.16 (O1a)
RA10: U6.21 (A10), U7.21 (A10), U8.21 (A10), U9.21 (A10), U10.21 (A10), U11.21 (A10), U15.3 (A1), U18.12 (O3a)
RA11: U6.23 (A11), U7.23 (A11), U8.23 (A11), U9.23 (A11), U10.23 (A11), U11.23 (A11), U18.14 (O2a)
RA12: U6.2 (A12), U7.2 (A12), U8.2 (A12), U9.2 (A12), U10.2 (A12), U11.2 (A12), U18.9 (O0b)
RA13: SP1.3, U18.7 (O1b)
XA0: U17.11 (I0b)
XA1: U17.13 (I1b)
XA2: U17.15 (I2b)
XA3: U17.17 (I3b)
XA4: U17.2 (I0a)
XA5: U17.4 (I1a)
XA6: U17.6 (I2a)
XA7: U17.8 (I3a)
XA8: U18.2 (I0a)
XA9: U18.4 (I1a)
XA10: U18.8 (I3a)
XA11: U18.6 (I2a)
XA12: U18.11 (I0b), U74.8 (I_{7})
XA13: U18.13 (I1b), U74.7 (I_{6})
XA14: U74.6 (I_{5})
XA15: U74.5 (I_{4})
XA16: U74.4 (I_{3})
XA17: U74.3 (I_{2})
XA18: U74.2 (I_{1})
XA19: U74.1 (I_{0})
XD0: U19.9 (A7)
XD1: U19.8 (A6)
XD2: U19.7 (A5)
XD3: U19.6 (A4)
XD4: U19.5 (A3)
XD5: U19.4 (A2)
XD6: U19.3 (A1)
XD7: U19.2 (A0)
~ARRAY_RECALL: U14.10 (~ARRAY_RECALL), U16.11
~F300_{EN}: U15.2 (Ea2), U15.14 (Eb1), U74.12 (~O_{1})
~MEMR: U74.9 (I_{8}), U77.11
~MEMW: U18.15 (I2b)
~PALETTE0_{WR}: RN4.5 (R4.2), U15.11 (Q2b)
~PALETTE1_{WR}: RN4.4 (R3.2), U15.12 (Q3b)
~RESET_{BRD}: U16.5, U16.10
~ROM_SEL: U74.19 (~O_{8})
~ROM_SIZE: R68.1, SP0.1, U74.11 (I_{9})
~STORE: U14.9 (~STORE), U16.6
~WR: U14.11 (~WE), U15.15 (Eb2), U18.5 (O2b)

Notes on the sheet:
NOVRAM and Palette Decoder
To RAM (Page 3)
The unmarked pads on the left side of the ROM sockets can be used to send either +5V or A13 to pin 26. This allows the potential use of 16KB 27128 EEPROMs, but the ROM PAL would need reprogramming.
Two more address pins than the X2210 has connected are routed to the X2210 socket - perhaps larger NOVRAM modules were planned.
Some earlier Chameleons may have 2732 (4K) ROMs instead of 2764s. The 2732 will align to the bottom of the DIP-28 socket leaving the top four pin positions open. The 2732 and 2764 are designed for this scenario. The 2764 leaves pin 26 disconnected so that Vcc can be provided to a 2732 if installed.
The ~{ROM_SEL} signal is a hint to the RAM decoder PAL that it does not need to activate DRAM banks.
A solder bridge near the ROM PAL can be used to tie the ~{ROM_SIZE} line low, which decodes addresses for 8K ROMs - otherwise it assumes 4K. In production a bodge wire from P11 to GND on the ROM PAL was preferred over using the bridge. See the table at center for decoding addresses.
The Xicor NOVRAM is an interesting device - it combines the speed of SRAM with the nonvolatility of an EEPROM. To permanently save data, the contents of SRAM must be commmitted to the EEPROM with the ~{STORE} strobe. The ~{ARRAY_RECALL} strobe loads SRAM with the contents of the EEPROM, making the 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
A read activates bank A A write activates bank B
