dbalsom/seequa_chameleon/kicad/serial.kicad_sch

## KiCad design kicad/serial.kicad_sch (2026-05-13)

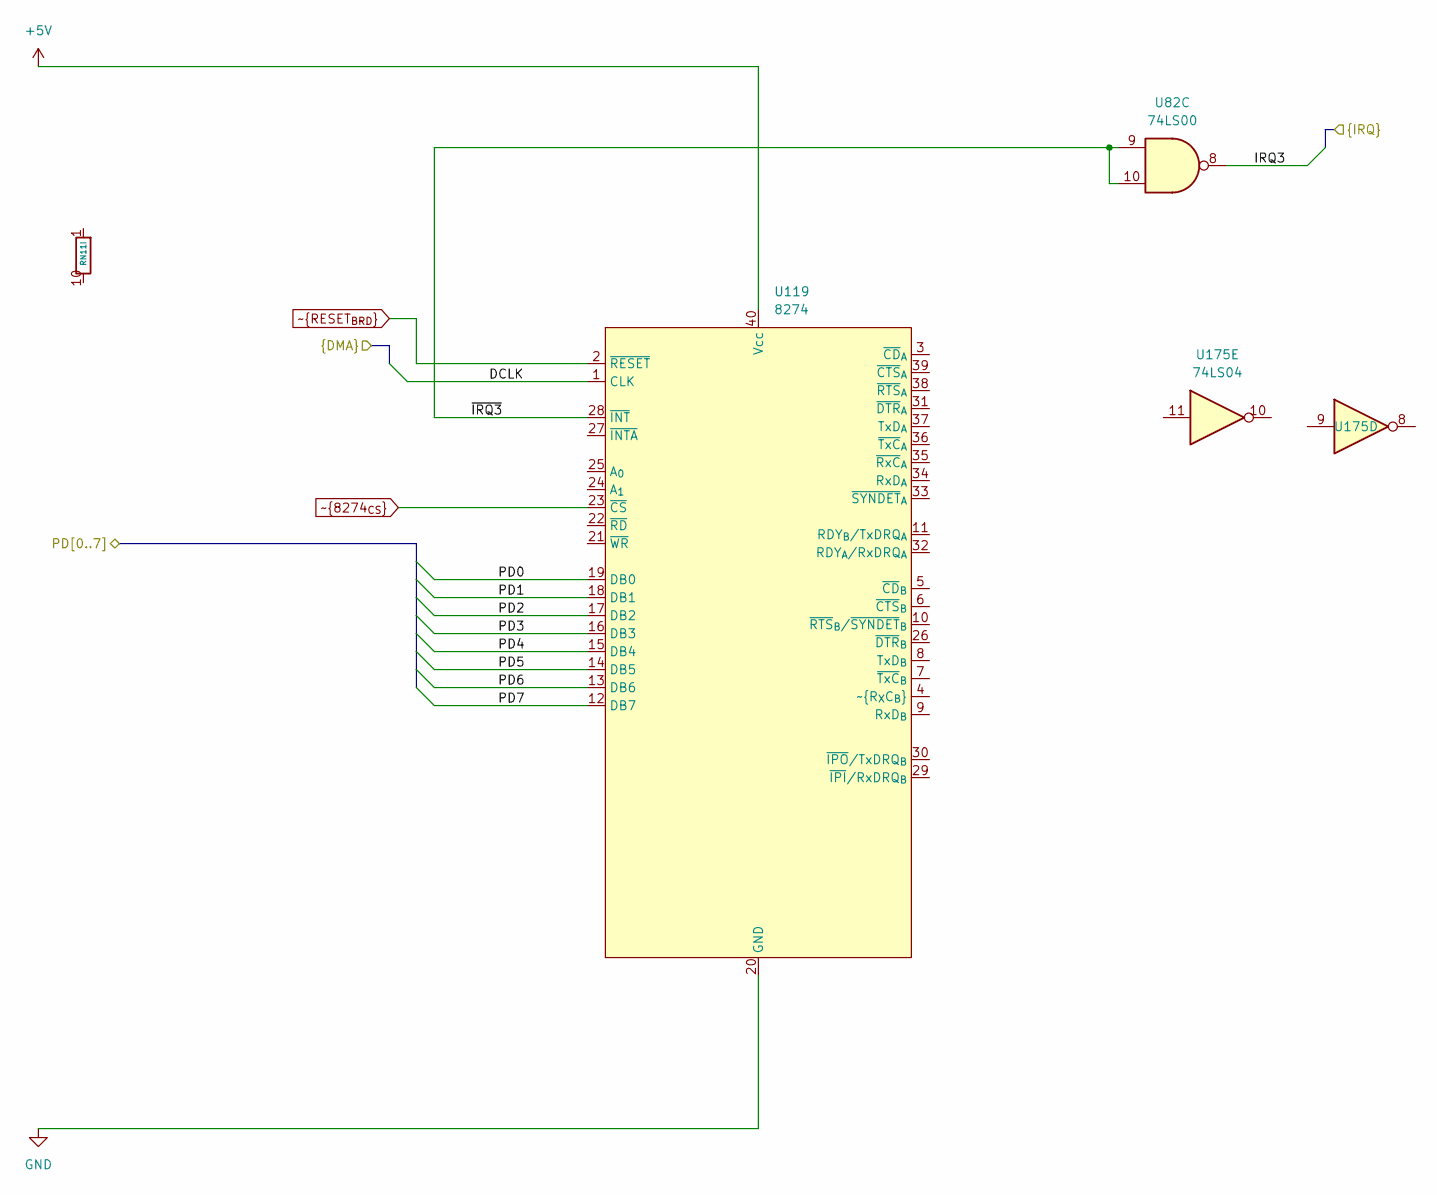
[picture p35: schematic serial.kicad_sch]

Parts:
RN11: 4.7kΩ; R_Array_SIP10
U82: 74LS00; DIP-14_W7.62mm
U119: 8274; DIP-40_W15.24mm_Socket
U175: 74LS04; DIP-14_W7.62mm

Connections:
+5V: U119.40 (Vcc)
DCLK: U119.1 (CLK)
GND: U119.20 (GND)
IRQ3: U82.8
PD0: U119.19 (DB0)
PD1: U119.18 (DB1)
PD2: U119.17 (DB2)
PD3: U119.16 (DB3)
PD4: U119.15 (DB4)
PD5: U119.14 (DB5)
PD6: U119.13 (DB6)
PD7: U119.12 (DB7)
~8274_{CS}: U119.23 (~CS)
~IRQ3: U82.9, U82.10, U119.28 (~INT)
~RESET_{BRD}: U119.2 (~RESET)
