dbalsom/seequa_chameleon/kicad/speaker.kicad_sch

## KiCad design kicad/speaker.kicad_sch (2026-02-23)

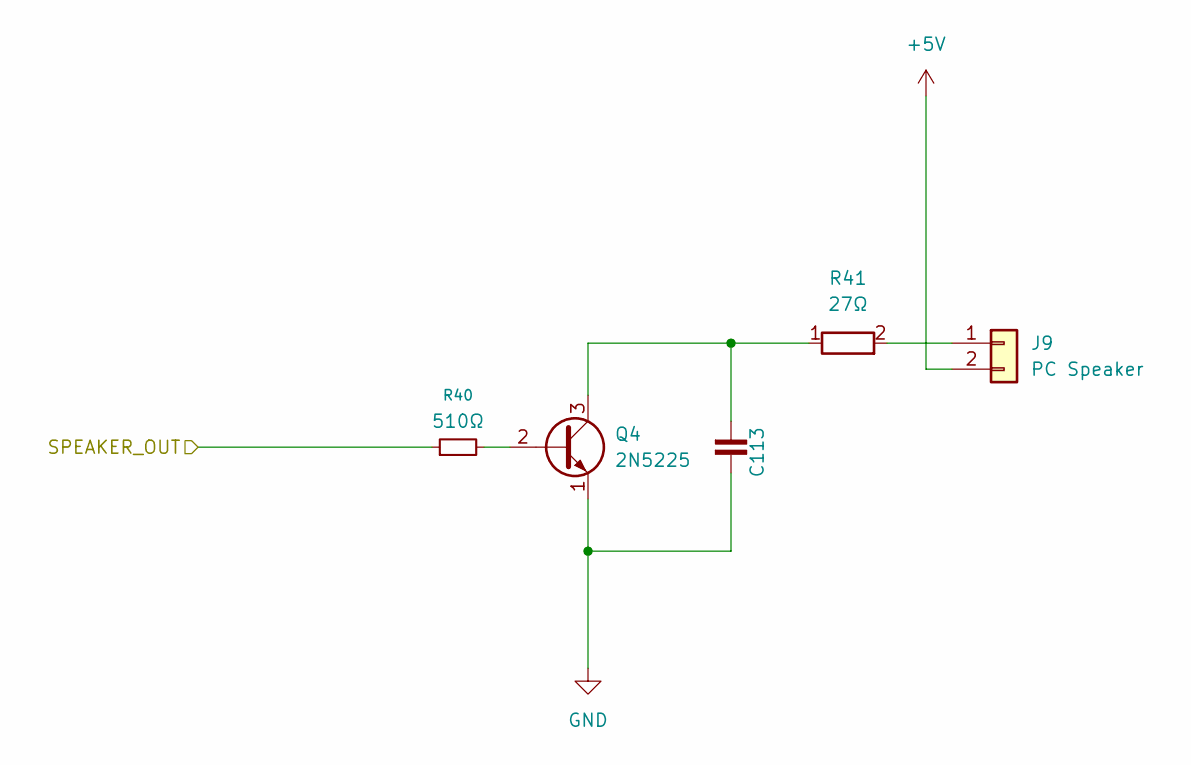
[picture p36: schematic speaker.kicad_sch]

Parts:
C113: C_Bypass_5mm; C_Seequa_Bypass_3.8mm
J9: PC Speaker; PinHeader_1x02_P2.54mm_Horizontal
Q4: 2N5225; TO-92L_Inline_Wide
R40: 510Ω; R_Seequa_Resistor
R41: 27Ω; R_Axial_DIN0516_L15.5mm_D5.0mm_P20.32mm_Horizontal

Connections:
+5V: J9.2
GND: C113.2, Q4.1 (E)
unnamed: C113.1, Q4.3 (C), R41.1
unnamed: J9.1, R41.2
unnamed: Q4.2 (B), R40.2
SPEAKER_OUT: R40.1
