dbalsom/seequa_chameleon/kicad/vc-1.kicad_sch

## KiCad design kicad/vc-1.kicad_sch (2026-05-13)

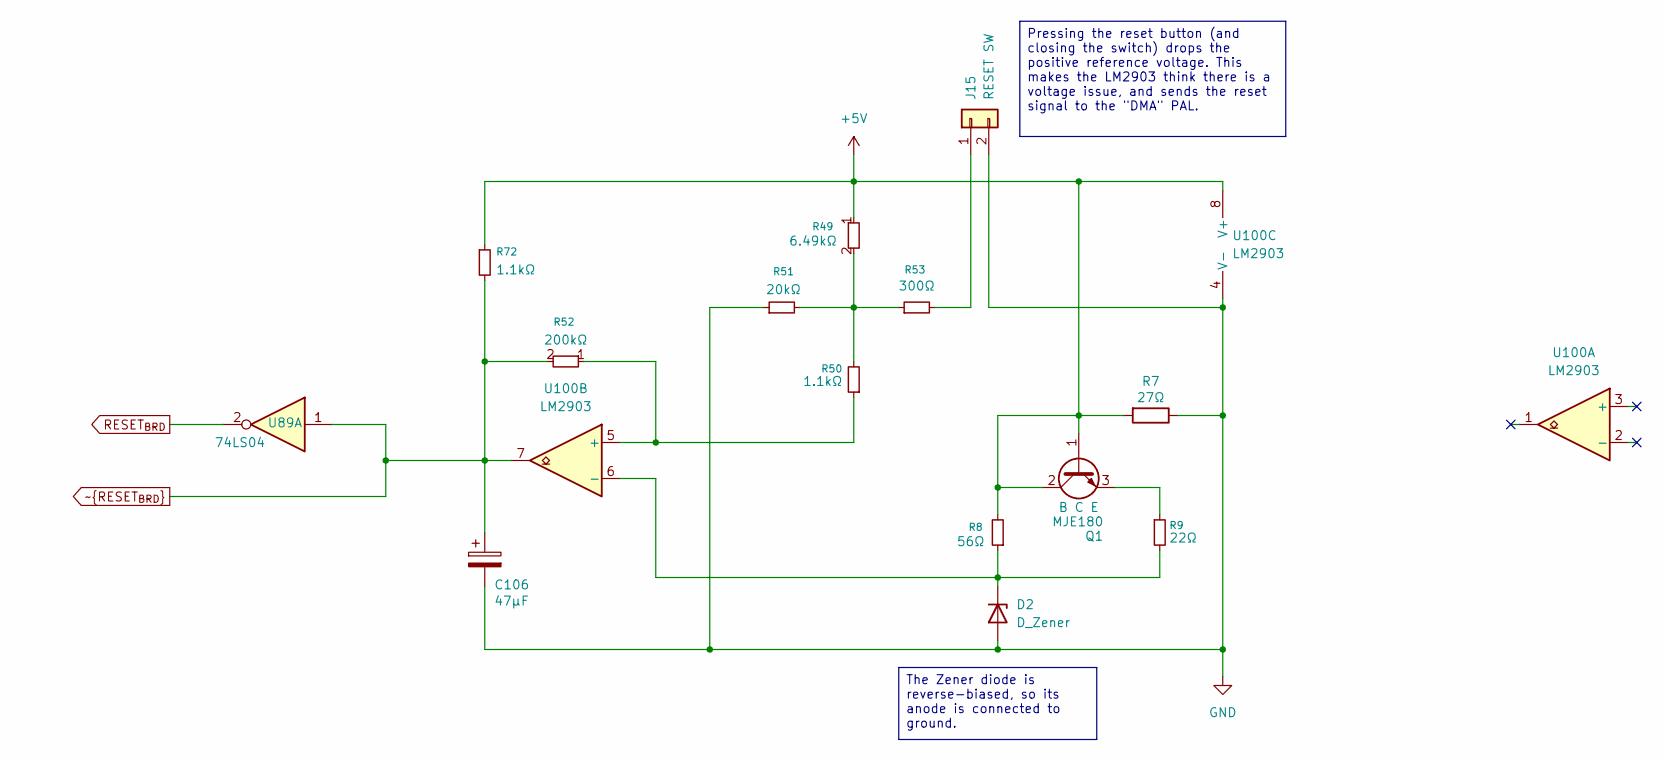
[picture p37: schematic vc-1.kicad_sch]

Parts:
C106: 47µF; C_Radial_D6.3mm_H11.0mm_P2.50mm
D2: D_Zener; D_A-405_P12.70mm_Horizontal
J15: RESET SW; PinHeader_2x01_P2.54mm_Vertical
Q1: MJE180; TO-126-3_Vertical
R7: 27Ω; R_Axial_DIN0516_L15.5mm_D5.0mm_P20.32mm_Horizontal
R8: 56Ω; R_Seequa_Resistor
R9: 22Ω; R_Seequa_Resistor
R49: 6.49kΩ; R_Seequa_Resistor
R50, R72: 1.1kΩ; R_Seequa_Resistor
R51: 20kΩ; R_Seequa_Resistor
R52: 200kΩ; R_Seequa_Resistor
R53: 300Ω; R_Seequa_Resistor
U89: 74LS04; DIP-14_W7.62mm
U100: LM2903; DIP-8_W7.62mm

Connections:
+5V: Q1.1 (B), Q1.2 (C), R7.2, R8.2, R49.1, R72.1, U100.8 (V+)
GND: C106.2, D2.2 (A), J15.2, R7.1, R51.1, U100.4 (V-)
unnamed: D2.1 (K), R8.1, R9.2, U100.6 (-)
unnamed: J15.1, R53.2
unnamed: Q1.3 (E), R9.1
unnamed: R49.2, R50.2, R51.2, R53.1
unnamed: R50.1, R52.1, U100.5 (+)
RESET_{BRD}: U89.2
~RESET_{BRD}: C106.1, R52.2, R72.2, U89.1, U100.7

Notes on the sheet:
Pressing the reset button (and closing the switch) drops the positive reference voltage. This makes the LM2903 think there is a voltage issue, and sends the reset signal to the "DMA" PAL.
The Zener diode is reverse-biased, so its anode is connected to ground.
