dbalsom/seequa_chameleon/kicad/video.kicad_sch

## KiCad design kicad/video.kicad_sch (2026-05-13)

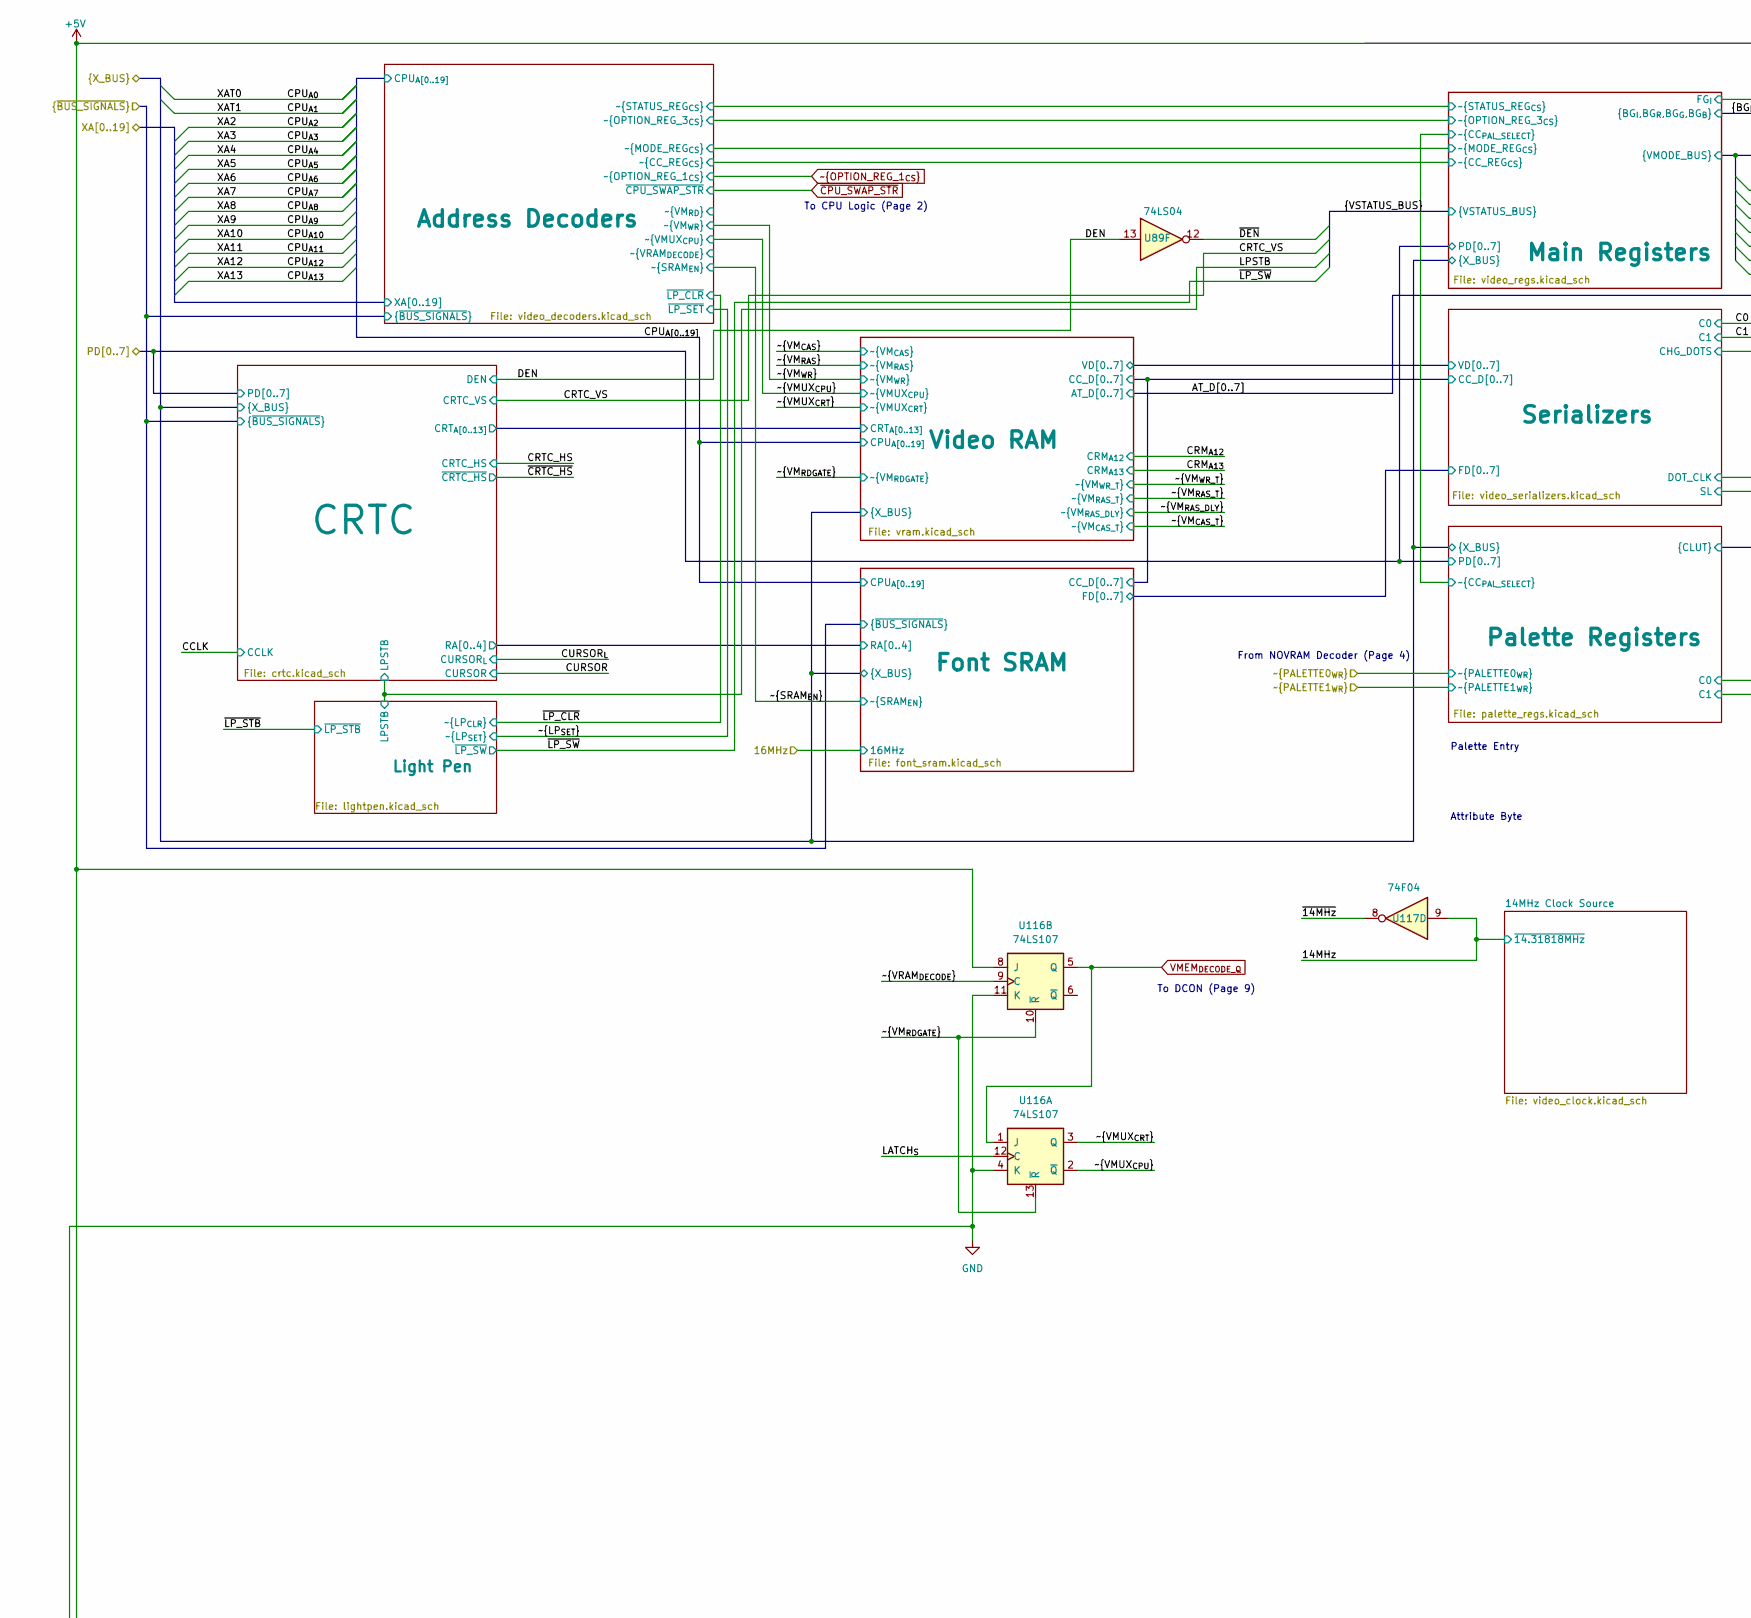
[picture p38: schematic video.kicad_sch, part in row 1, column 1]

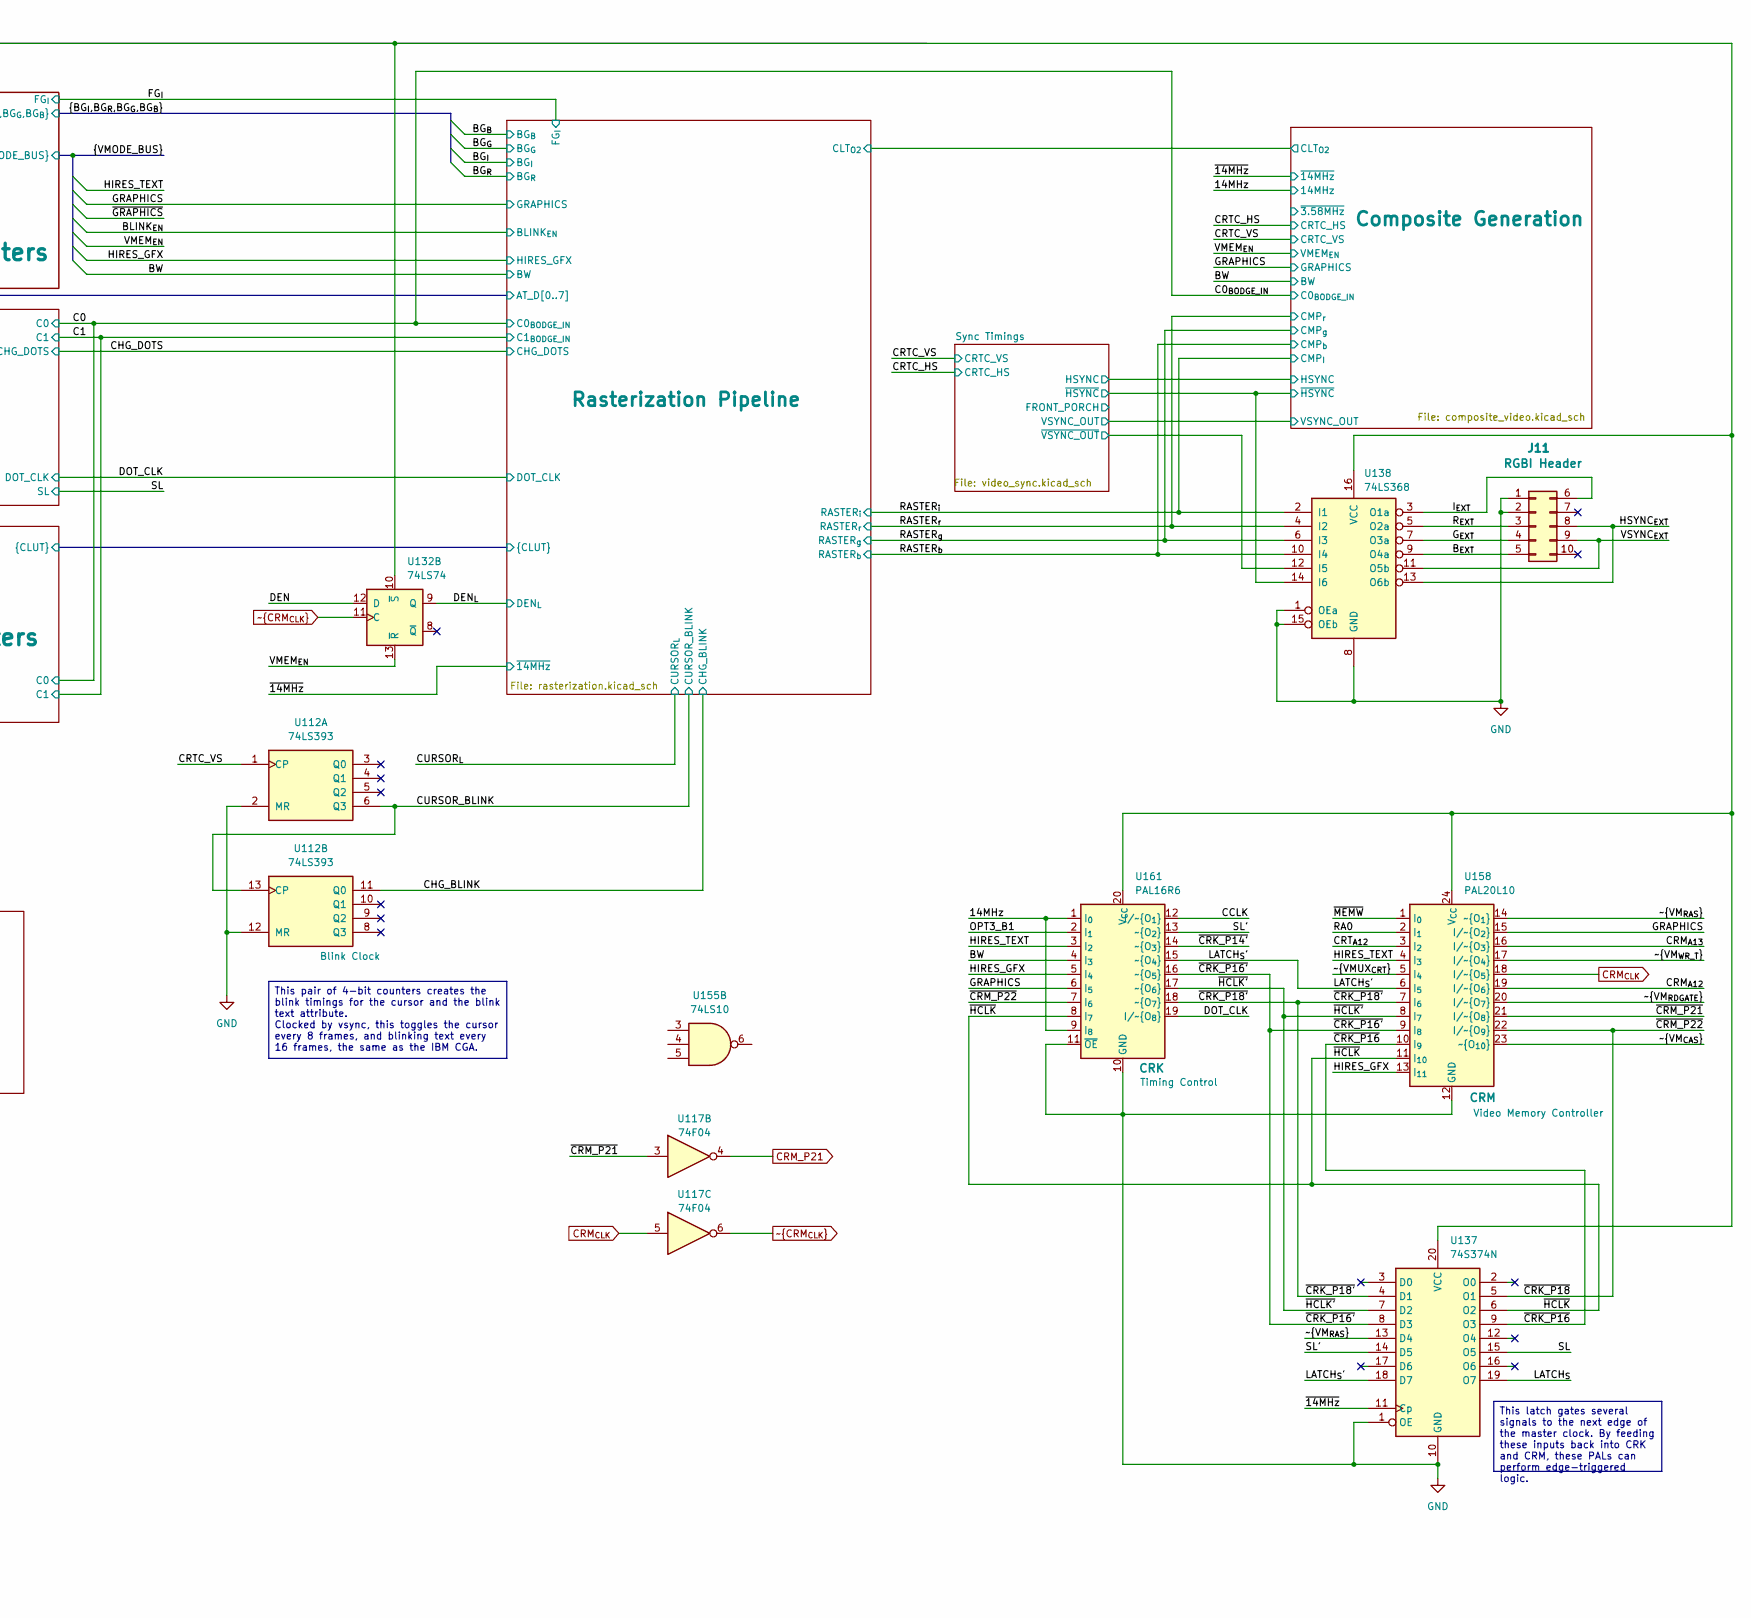
[picture p39: schematic video.kicad_sch, part in row 1, column 2]

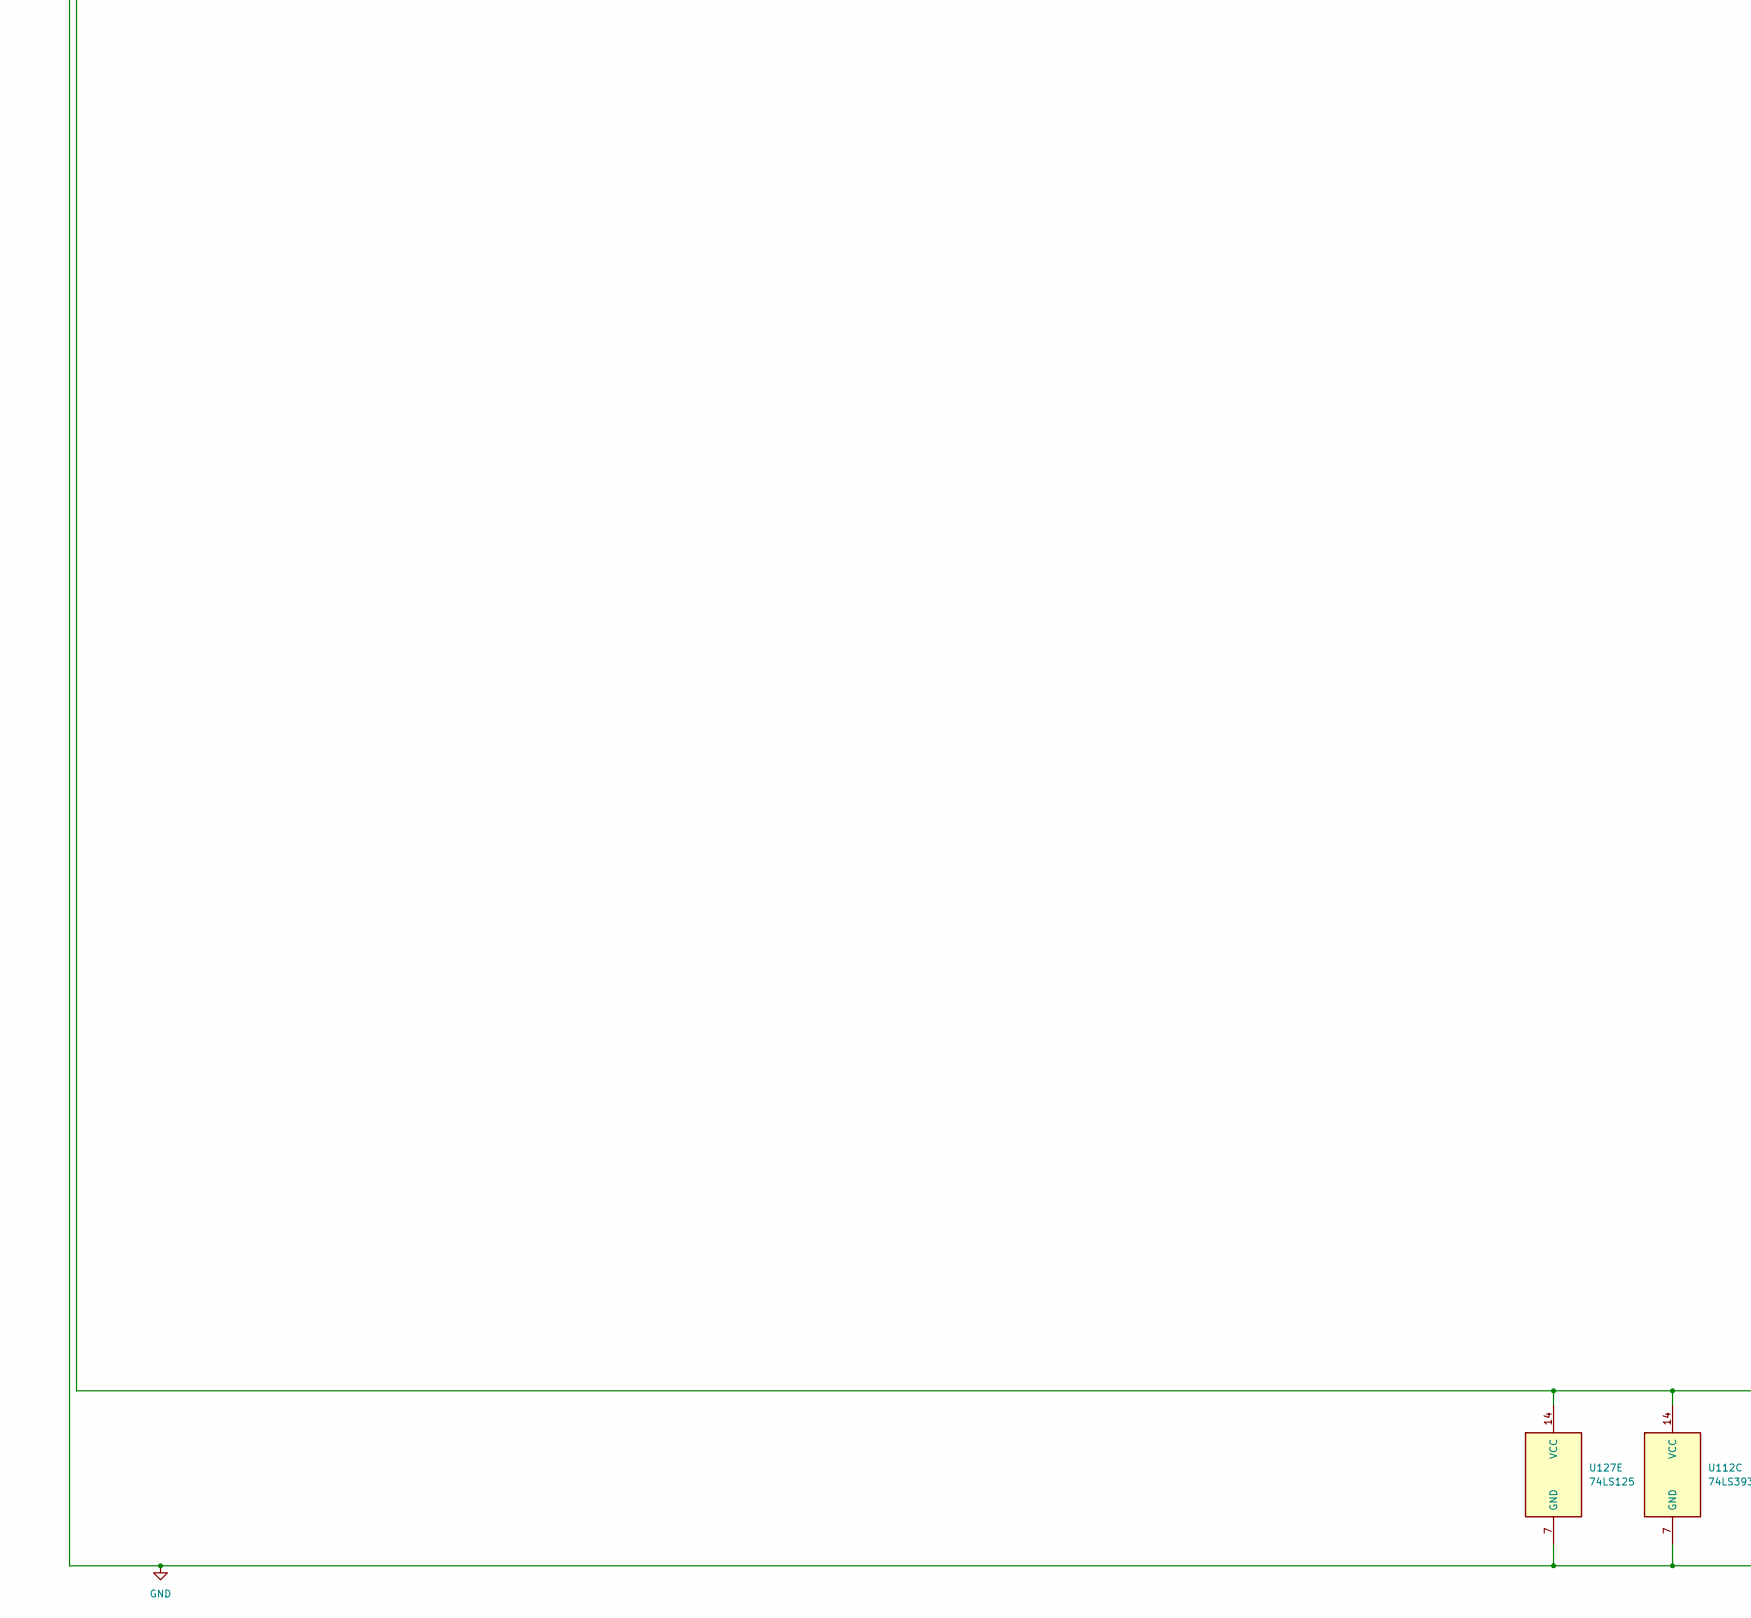
[picture p40: schematic video.kicad_sch, part in row 2, column 1]

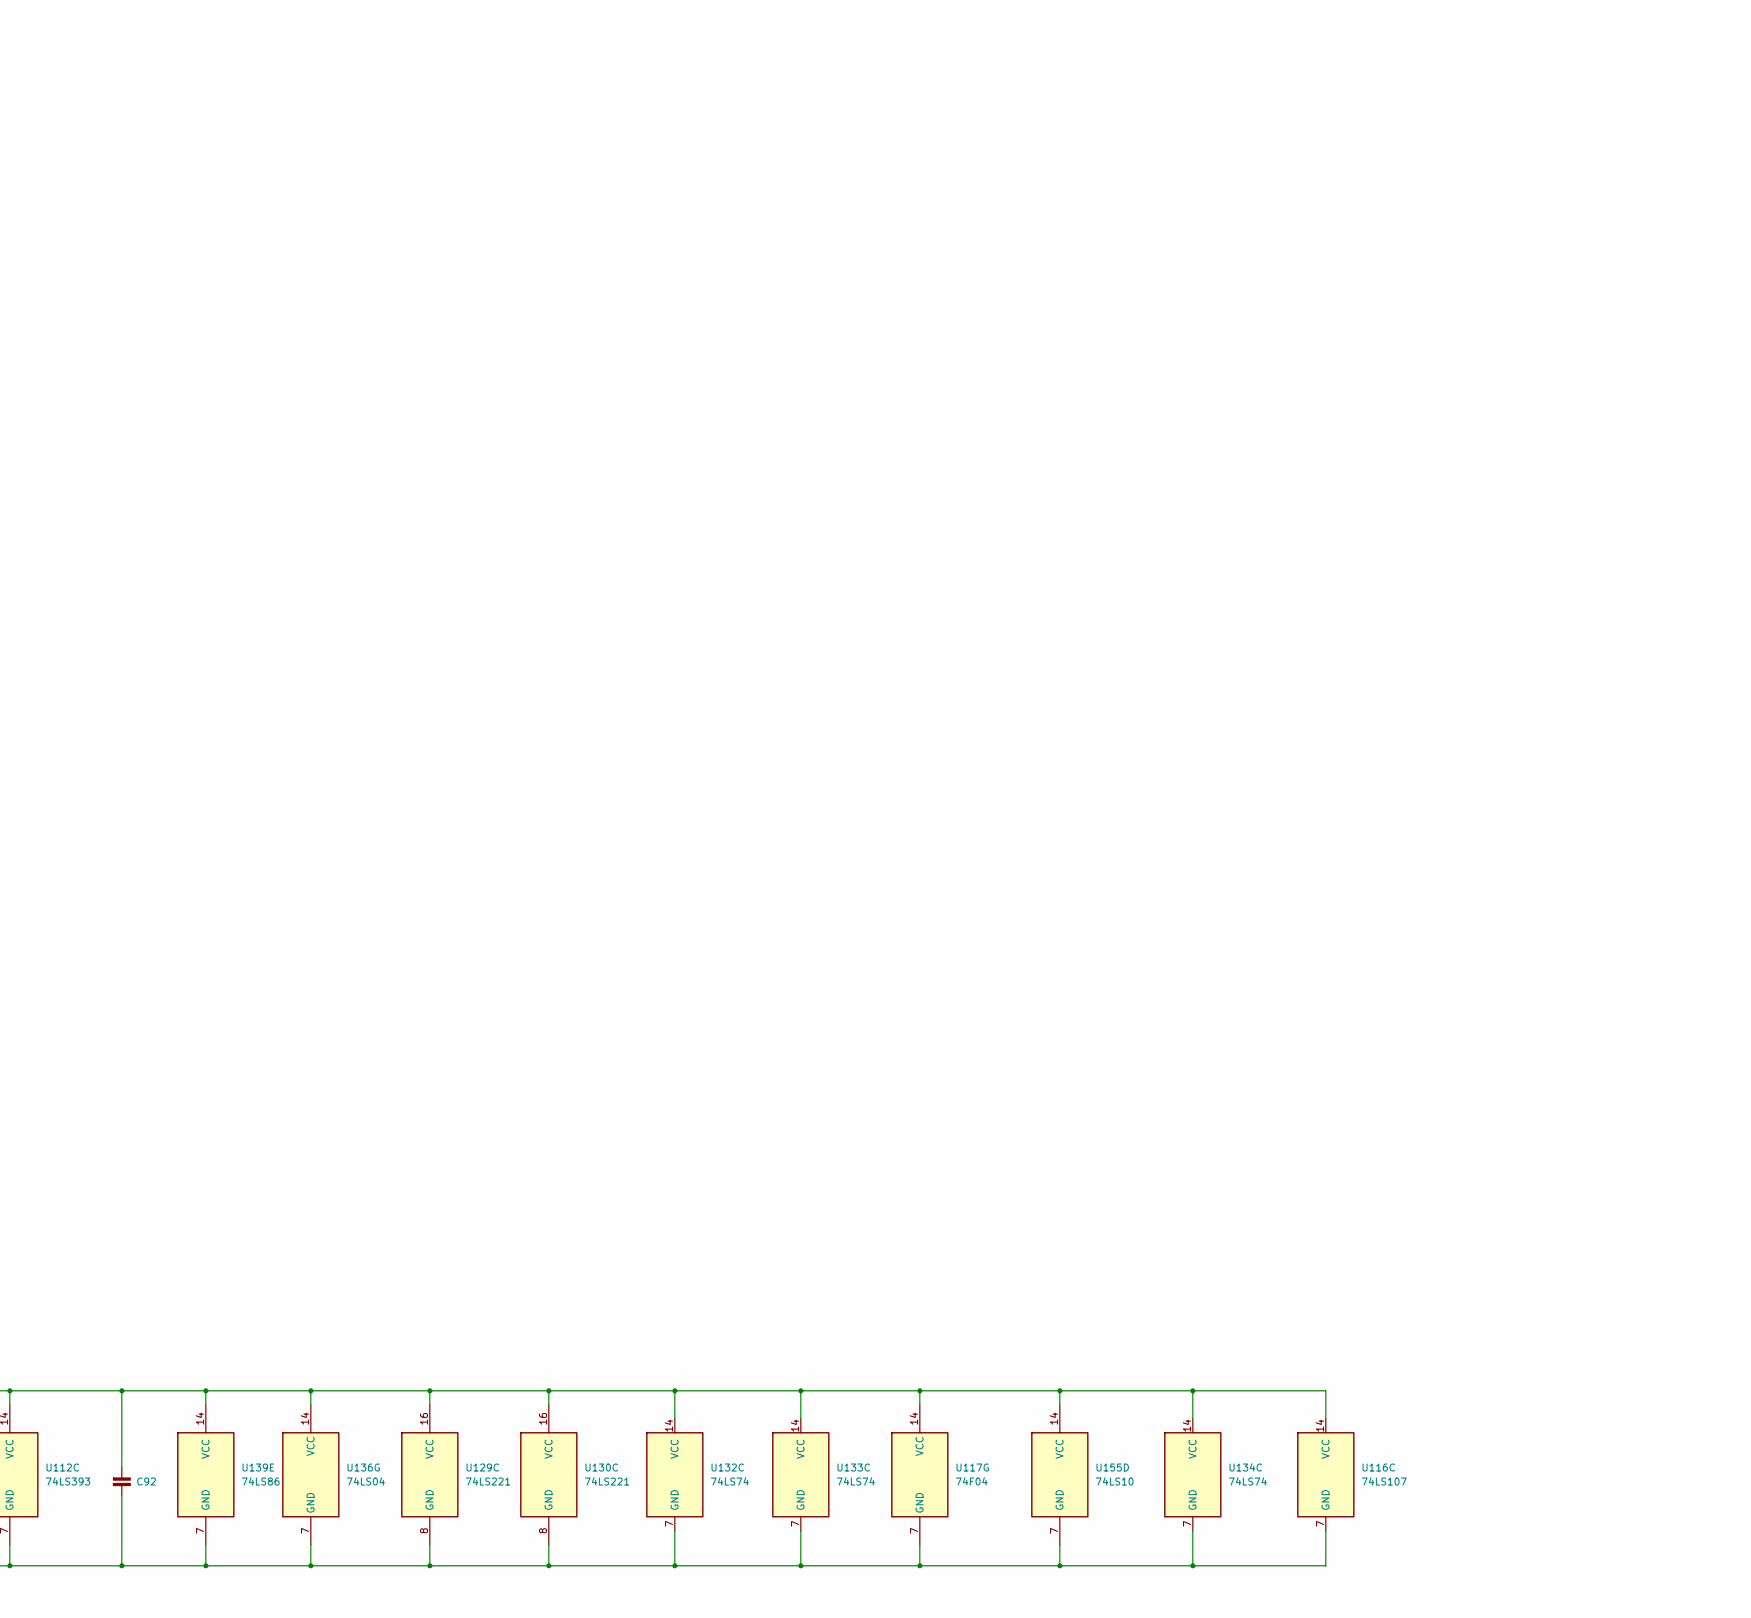
[picture p41: schematic video.kicad_sch, part in row 2, column 2]

Parts:
C92: C_Bypass_Ceramic_2.54mm; C_Seequa_Bypass_2.54mm
J11: Conn_02x05e; PinHeader_CGA_Vertical
U89, U136: 74LS04; DIP-14_W7.62mm
U112: 74LS393; DIP-14_W7.62mm
U116: 74LS107; DIP-14_W7.62mm
U117: 74F04; DIP-14_W7.62mm
U127: 74LS125; DIP-14_W7.62mm
U129, U130: 74LS221; DIP-16_W7.62mm
U132, U133, U134: 74LS74; DIP-14_W7.62mm
U137: 74S374N; DIP-20_W7.62mm
U138: 74LS368; DIP-16_W7.62mm
U139: 74LS86; DIP-14_W7.62mm
U155: 74LS10; DIP-14_W7.62mm
U158: PAL20L10; DIP-24_W7.62mm
U161: PAL16R6; DIP-20_W7.62mm_Socket

Connections:
14MHz: U117.9, U161.1 (I_{0}), U161.9 (I_{8})
+5V: C92.1, U112.14 (VCC), U116.8 (J), U116.14 (VCC), U117.14 (VCC), U127.14 (VCC), U129.16 (VCC), U130.16 (VCC), U132.10 (~S), U132.14 (VCC), U133.14 (VCC), U134.14 (VCC), U136.14 (VCC), U137.20 (VCC), U138.16 (VCC), U139.14 (VCC), U155.14 (VCC), U158.24 (V_{CC}), U161.20 (V_{CC})
BW: U161.4 (I_{3})
B_{EXT}: J11.5, U138.9 (O4a)
CCLK: U161.12 (I/~O_{1})
CHG_BLINK: U112.11 (Q0)
CRM_P21: U117.4
CRM_{A12}: U158.19 (I/~O_{6})
CRM_{A13}: U158.16 (I/~O_{3})
CRM_{CLK}: U117.5, U158.18 (I/~O_{5})
CRTC_VS: U112.1 (CP)
CRT_{A12}: U158.3 (I_{2})
CURSOR_BLINK: U112.6 (Q3), U112.13 (CP)
DEN: U89.13, U132.12 (D)
DEN_{L}: U132.9 (Q)
DOT_CLK: U161.19 (I/~O_{8})
GND: C92.2, J11.1, J11.2, U112.2 (MR), U112.7 (GND), U112.12 (MR), U116.4 (K), U116.7 (GND), U116.11 (K), U117.7 (GND), U127.7 (GND), U129.8 (GND), U130.8 (GND), U132.7 (GND), U133.7 (GND), U134.7 (GND), U136.7 (GND), U137.1 (OE), U137.10 (GND), U138.1 (OEa), U138.8 (GND), U138.15 (OEb), U139.7 (GND), U155.7 (GND), U158.12 (GND), U161.10 (GND), U161.11 (~OE)
GRAPHICS: U158.15 (I/~O_{2}), U161.6 (I_{5})
G_{EXT}: J11.4, U138.7 (O3a)
HIRES_GFX: U158.13 (I_{11}), U161.5 (I_{4})
HIRES_TEXT: U158.4 (I_{3}), U161.3 (I_{2})
HSYNC_{EXT}: J11.8, U138.13 (O6b)
I_{EXT}: J11.6, U138.3 (O1a)
LATCH_{S}: U116.12 (C), U137.19 (O7)
LATCH_{S}': U137.18 (D7), U158.6 (I_{5}), U161.15 (~O_{4})
OPT3_B1: U161.2 (I_{1})
RA0: U158.2 (I_{1})
RASTER_{b}: U138.10 (I4)
RASTER_{g}: U138.6 (I3)
RASTER_{i}: U138.2 (I1)
RASTER_{r}: U138.4 (I2)
R_{EXT}: J11.3, U138.5 (O2a)
SL: U137.15 (O5)
SL': U137.14 (D5), U161.13 (~O_{2})
VMEM_{DECODE_Q}: U116.1 (J), U116.5 (Q)
VMEM_{EN}: U132.13 (~R)
VSYNC_{EXT}: J11.9, U138.11 (O5b)
~14MHz: U117.8, U137.11 (Cp)
~CRK_P14': U161.14 (~O_{3})
~CRK_P16': U137.8 (D3), U158.9 (I_{8}), U161.16 (~O_{5})
~CRK_P16: U137.9 (O3), U158.10 (I_{9})
~CRK_P18': U137.4 (D1), U158.7 (I_{6}), U161.18 (~O_{7})
~CRK_P18: U137.5 (O1), U158.22 (I/~O_{9}), U161.7 (I_{6})
~CRM_P21: U117.3, U158.21 (I/~O_{8})
~CRM_{CLK}: U117.6, U132.11 (C)
~DEN: U89.12
~HCLK': U137.7 (D2), U158.8 (I_{7}), U161.17 (~O_{6})
~HCLK: U137.6 (O2), U158.11 (I_{10}), U161.8 (I_{7})
~HSYNC: U138.14 (I6)
~MEMW: U158.1 (I_{0})
~VMUX_{CPU}: U116.2 (~Q)
~VMUX_{CRT}: U116.3 (Q), U158.5 (I_{4})
~VM_{CAS}: U158.23 (~O_{10})
~VM_{RAS}: U137.13 (D4), U158.14 (~O_{1})
~VM_{RDGATE}: U116.10 (~R), U116.13 (~R), U158.20 (I/~O_{7})
~VM_{WR_T}: U158.17 (I/~O_{4})
~VRAM_{DECODE}: U116.9 (C)
~VSYNC_OUT: U138.12 (I5)

Notes on the sheet:
Attribute Byte
Palette Entry
To DCON (Page 9)
From NOVRAM Decoder (Page 4)
To CPU Logic (Page 2)
This latch gates several signals to the next edge of the master clock. By feeding these inputs back into CRK and CRM, these PALs can perform edge-triggered logic.
This pair of 4-bit counters creates the blink timings for the cursor and the blink text attribute. Clocked by vsync, this toggles the cursor every 8 frames, and blinking text every 16 frames, the same as the IBM CGA.
