dbalsom/seequa_chameleon/kicad/video_clock.kicad_sch

## KiCad design kicad/video_clock.kicad_sch (2026-05-13)

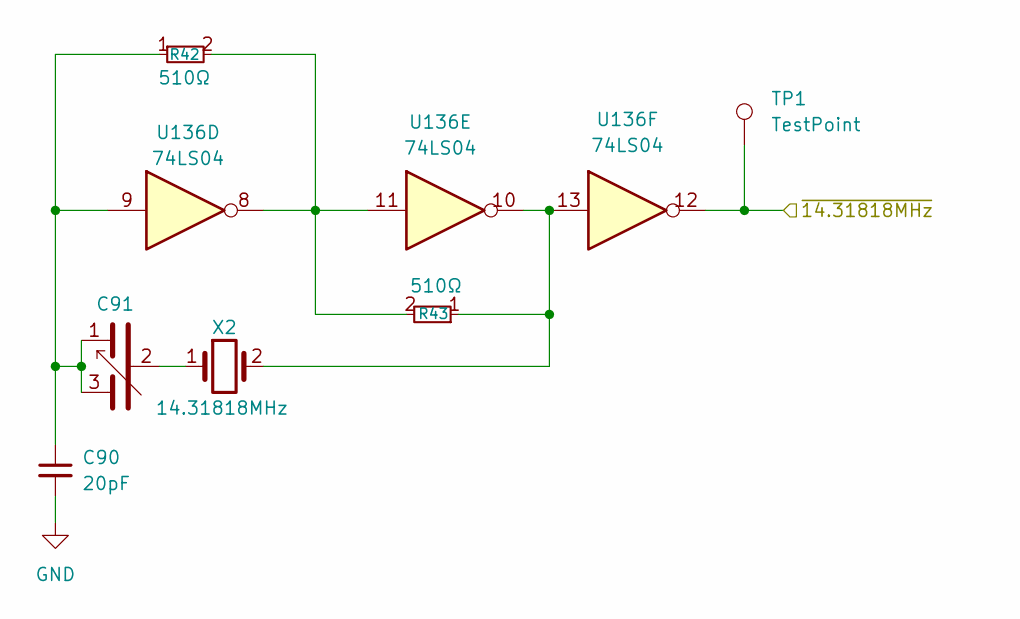
[picture p42: schematic video_clock.kicad_sch]

Parts:
C90: 20pF; C_Seequa_Bypass_6.5mm
C91: C_Trim_Differential; C_Seequa_Trimmer
R42, R43: 510Ω; R_Seequa_Resistor
TP1: TestPoint; TestPoint_Pad_D1.5mm
U136: 74LS04; DIP-14_W7.62mm
X2: 14.31818MHz; Crystal_HC49-U_Vertical

Connections:
GND: C90.2
unnamed: C90.1, C91.1, C91.3, R42.1, U136.9
unnamed: C91.2, X2.1
unnamed: R42.2, R43.2, U136.8, U136.11
unnamed: R43.1, U136.10, U136.13, X2.2
~14.31818MHz: TP1.1, U136.12
