dbalsom/seequa_chameleon/kicad/video_decoders.kicad_sch

## KiCad design kicad/video_decoders.kicad_sch (2026-05-13)

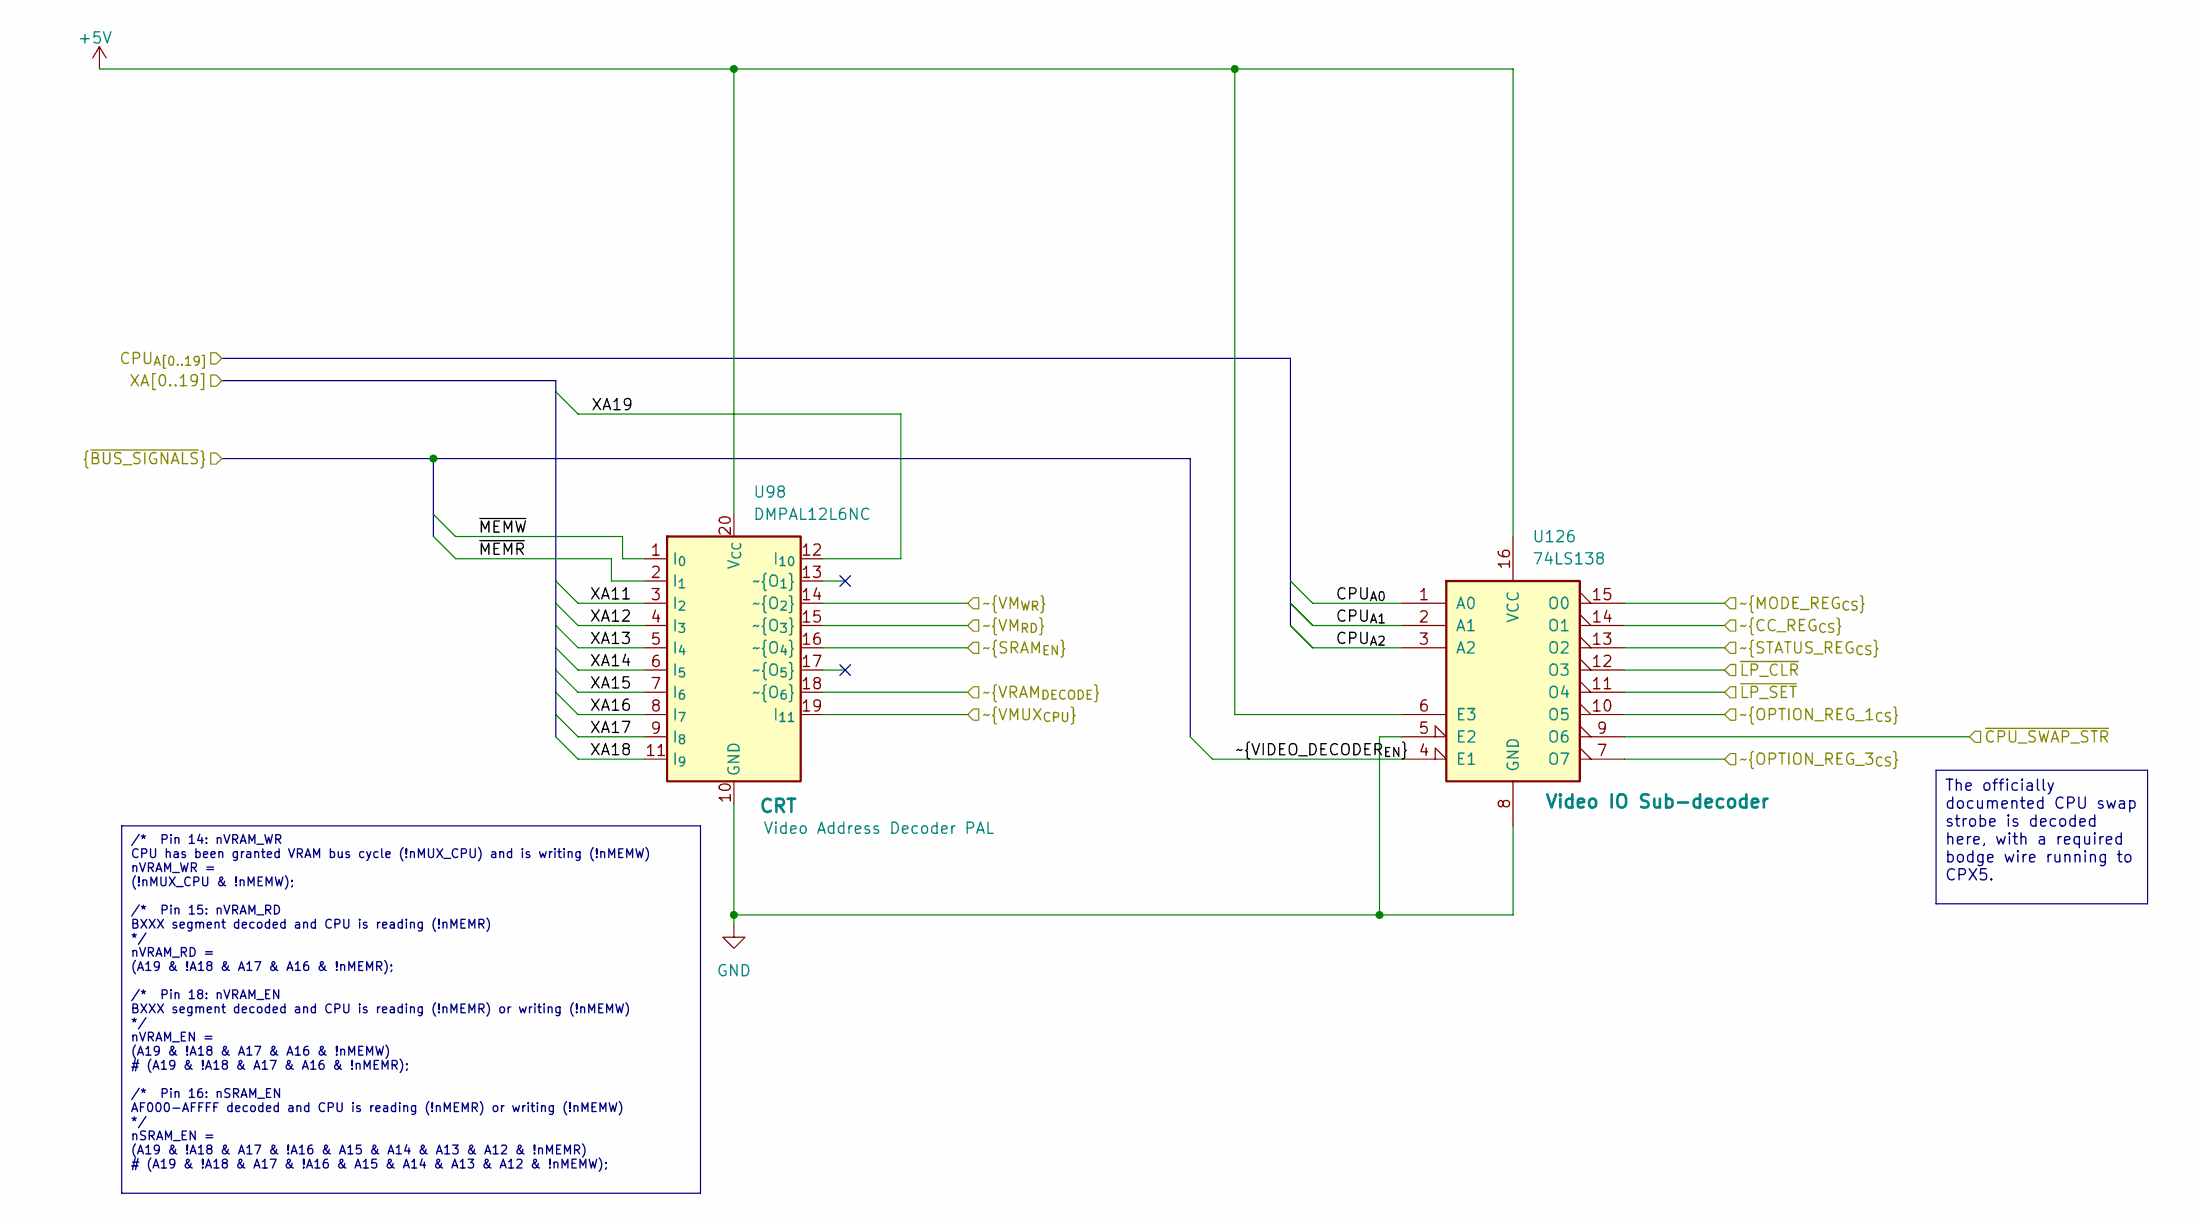
[picture p43: schematic video_decoders.kicad_sch]

Parts:
U98: DMPAL12L6NC; DIP-20_W7.62mm
U126: 74LS138; DIP-16_W7.62mm

Connections:
+5V: U98.20 (V_{CC}), U126.6 (E3), U126.16 (VCC)
CPU_{A0}: U126.1 (A0)
CPU_{A1}: U126.2 (A1)
CPU_{A2}: U126.3 (A2)
GND: U98.10 (GND), U126.5 (E2), U126.8 (GND)
XA11: U98.3 (I_{2})
XA12: U98.4 (I_{3})
XA13: U98.5 (I_{4})
XA14: U98.6 (I_{5})
XA15: U98.7 (I_{6})
XA16: U98.8 (I_{7})
XA17: U98.9 (I_{8})
XA18: U98.11 (I_{9})
XA19: U98.12 (I_{10})
~CC_REG_{CS}: U126.14 (O1)
~CPU_SWAP_STR: U126.9 (O6)
~LP_CLR: U126.12 (O3)
~LP_SET: U126.11 (O4)
~MEMR: U98.2 (I_{1})
~MEMW: U98.1 (I_{0})
~MODE_REG_{CS}: U126.15 (O0)
~OPTION_REG_1_{CS}: U126.10 (O5)
~OPTION_REG_3_{CS}: U126.7 (O7)
~SRAM_{EN}: U98.16 (~O_{4})
~STATUS_REG_{CS}: U126.13 (O2)
~VIDEO_DECODER_{EN}: U126.4 (E1)
~VMUX_{CPU}: U98.19 (I_{11})
~VM_{RD}: U98.15 (~O_{3})
~VM_{WR}: U98.14 (~O_{2})
~VRAM_{DECODE}: U98.18 (~O_{6})

Notes on the sheet:
The officially documented CPU swap strobe is decoded here, with a required bodge wire running to CPX5.
/* Pin 14: nVRAM_WR CPU has been granted VRAM bus cycle (!nMUX_CPU) and is writing (!nMEMW) nVRAM_WR = (!nMUX_CPU & !nMEMW); /* Pin 15: nVRAM_RD BXXX segment decoded and CPU is reading (!nMEMR) */ nVRAM_RD = (A19 & !A18 & A17 & A16 & !nMEMR); /* Pin 18: nVRAM_EN BXXX segment decoded and CPU is read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
