dbalsom/seequa_chameleon/kicad/video_regs.kicad_sch

## KiCad design kicad/video_regs.kicad_sch (2026-05-13)

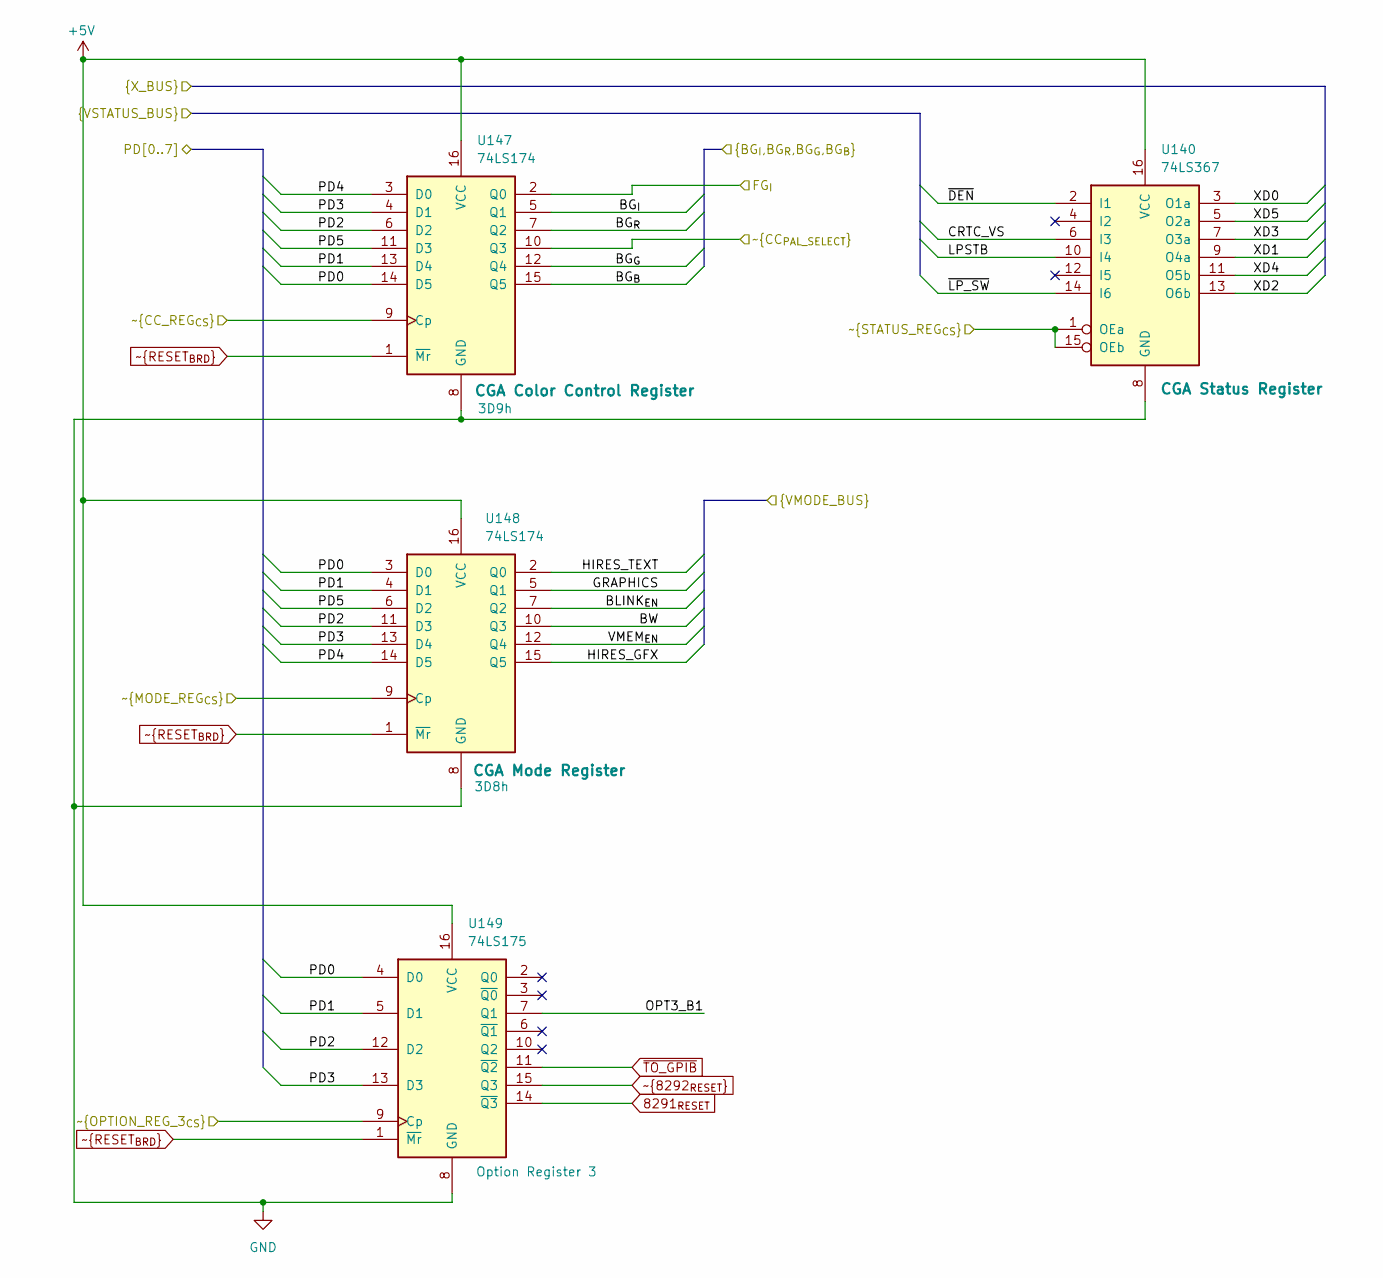
[picture p44: schematic video_regs.kicad_sch]

Parts:
U140: 74LS367; DIP-16_W7.62mm
U147, U148: 74LS174; DIP-16_W7.62mm
U149: 74LS175; DIP-16_W7.62mm

Connections:
8291_{RESET}: U149.14 (~Q3)
+5V: U140.16 (VCC), U147.16 (VCC), U148.16 (VCC), U149.16 (VCC)
BG_{B}: U147.15 (Q5)
BG_{G}: U147.12 (Q4)
BG_{I}: U147.5 (Q1)
BG_{R}: U147.7 (Q2)
BLINK_{EN}: U148.7 (Q2)
BW: U148.10 (Q3)
CRTC_VS: U140.6 (I3)
FG_{I}: U147.2 (Q0)
GND: U140.8 (GND), U147.8 (GND), U148.8 (GND), U149.8 (GND)
GRAPHICS: U148.5 (Q1)
HIRES_GFX: U148.15 (Q5)
HIRES_TEXT: U148.2 (Q0)
LPSTB: U140.10 (I4)
OPT3_B1: U149.7 (Q1)
PD0: U147.14 (D5), U148.3 (D0), U149.4 (D0)
PD1: U147.13 (D4), U148.4 (D1), U149.5 (D1)
PD2: U147.6 (D2), U148.11 (D3), U149.12 (D2)
PD3: U147.4 (D1), U148.13 (D4), U149.13 (D3)
PD4: U147.3 (D0), U148.14 (D5)
PD5: U147.11 (D3), U148.6 (D2)
VMEM_{EN}: U148.12 (Q4)
XD0: U140.3 (O1a)
XD1: U140.9 (O4a)
XD2: U140.13 (O6b)
XD3: U140.7 (O3a)
XD4: U140.11 (O5b)
XD5: U140.5 (O2a)
~8292_{RESET}: U149.15 (Q3)
~CC_REG_{CS}: U147.9 (Cp)
~CC_{PAL_SELECT}: U147.10 (Q3)
~DEN: U140.2 (I1)
~LP_SW: U140.14 (I6)
~MODE_REG_{CS}: U148.9 (Cp)
~OPTION_REG_3_{CS}: U149.9 (Cp)
~RESET_{BRD}: U147.1 (~Mr), U148.1 (~Mr), U149.1 (~Mr)
~STATUS_REG_{CS}: U140.1 (OEa), U140.15 (OEb)
~TO_GPIB: U149.11 (~Q2)
