dbalsom/seequa_chameleon/kicad/video_serializers.kicad_sch

## KiCad design kicad/video_serializers.kicad_sch (2026-05-13)

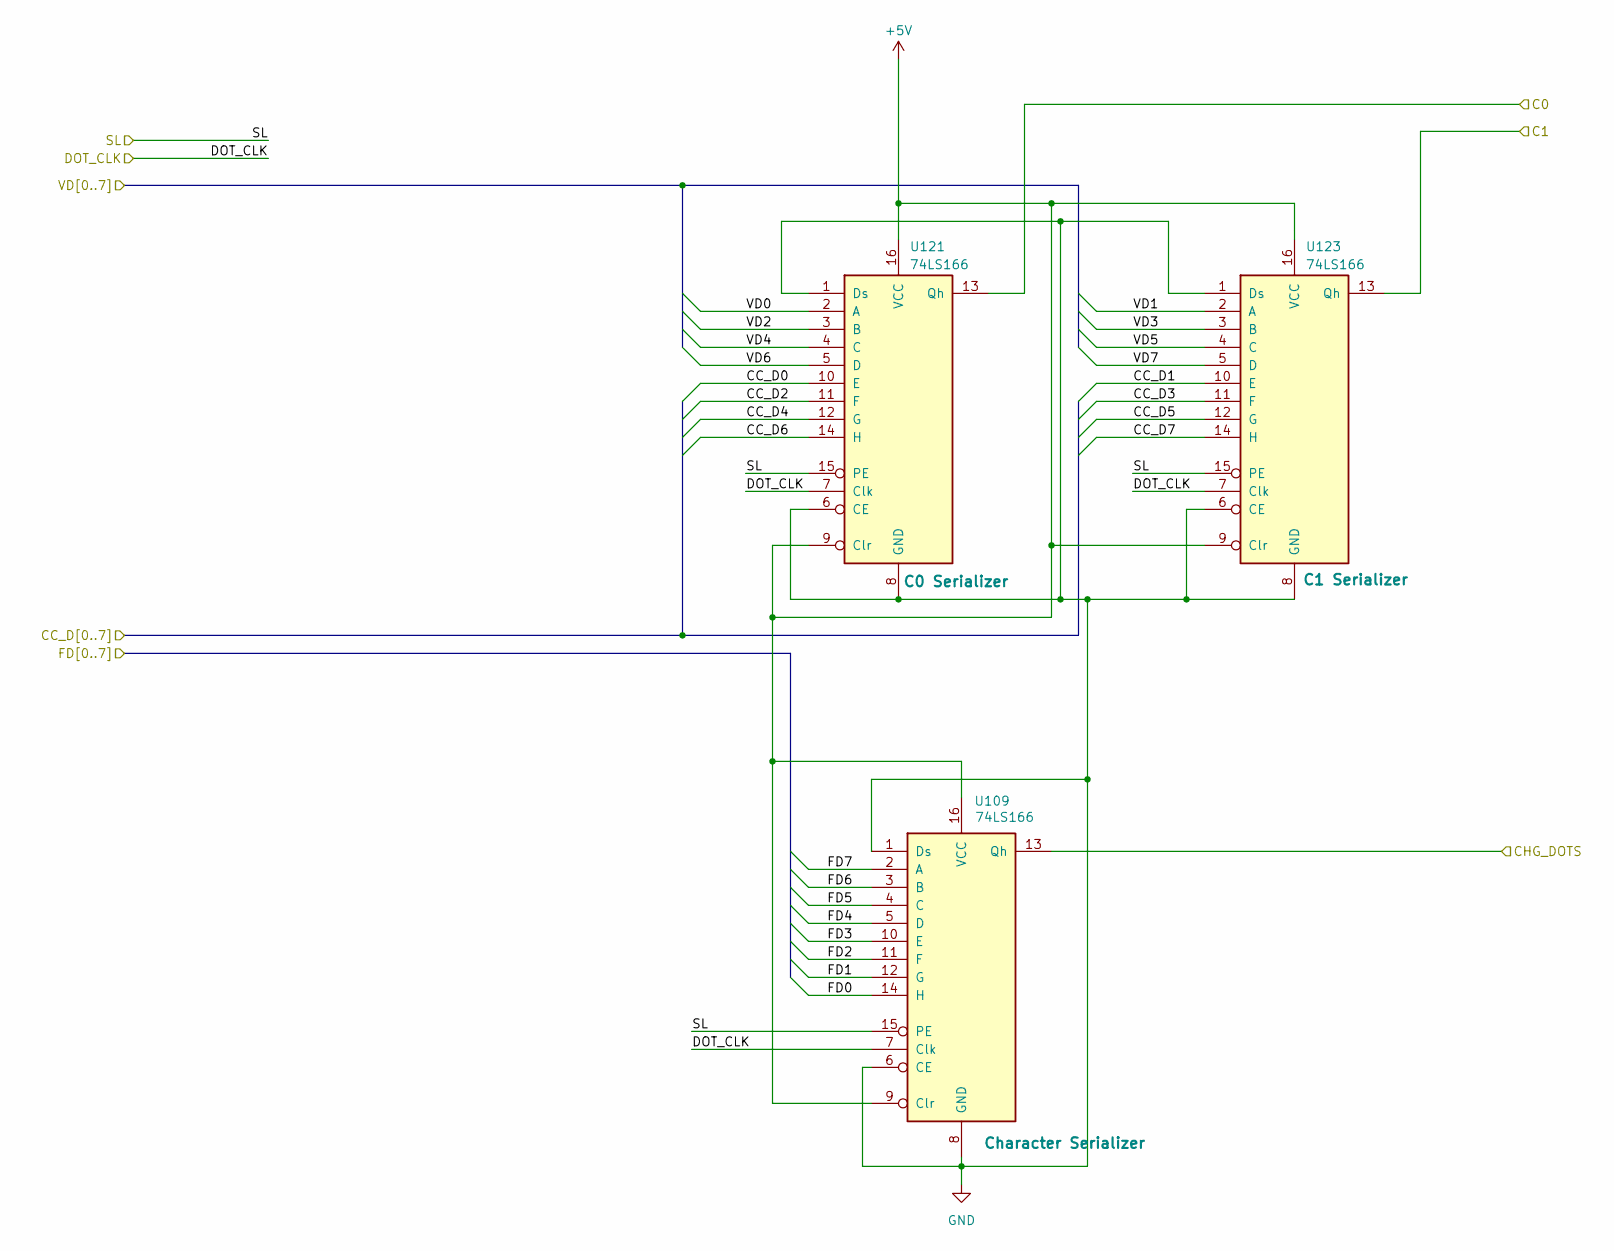
[picture p45: schematic video_serializers.kicad_sch]

Parts:
U109, U121, U123: 74LS166; DIP-16_W7.62mm

Connections:
+5V: U109.9 (Clr), U109.16 (VCC), U121.9 (Clr), U121.16 (VCC), U123.9 (Clr), U123.16 (VCC)
C0: U121.13 (Qh)
C1: U123.13 (Qh)
CC_D0: U121.10 (E)
CC_D1: U123.10 (E)
CC_D2: U121.11 (F)
CC_D3: U123.11 (F)
CC_D4: U121.12 (G)
CC_D5: U123.12 (G)
CC_D6: U121.14 (H)
CC_D7: U123.14 (H)
CHG_DOTS: U109.13 (Qh)
DOT_CLK: U109.7 (Clk), U121.7 (Clk), U123.7 (Clk)
FD0: U109.14 (H)
FD1: U109.12 (G)
FD2: U109.11 (F)
FD3: U109.10 (E)
FD4: U109.5 (D)
FD5: U109.4 (C)
FD6: U109.3 (B)
FD7: U109.2 (A)
GND: U109.1 (Ds), U109.6 (CE), U109.8 (GND), U121.1 (Ds), U121.6 (CE), U121.8 (GND), U123.1 (Ds), U123.6 (CE), U123.8 (GND)
SL: U109.15 (PE), U121.15 (PE), U123.15 (PE)
VD0: U121.2 (A)
VD1: U123.2 (A)
VD2: U121.3 (B)
VD3: U123.3 (B)
VD4: U121.4 (C)
VD5: U123.4 (C)
VD6: U121.5 (D)
VD7: U123.5 (D)
