dbalsom/seequa_chameleon/kicad/video_sync.kicad_sch

## KiCad design kicad/video_sync.kicad_sch (2026-05-13)

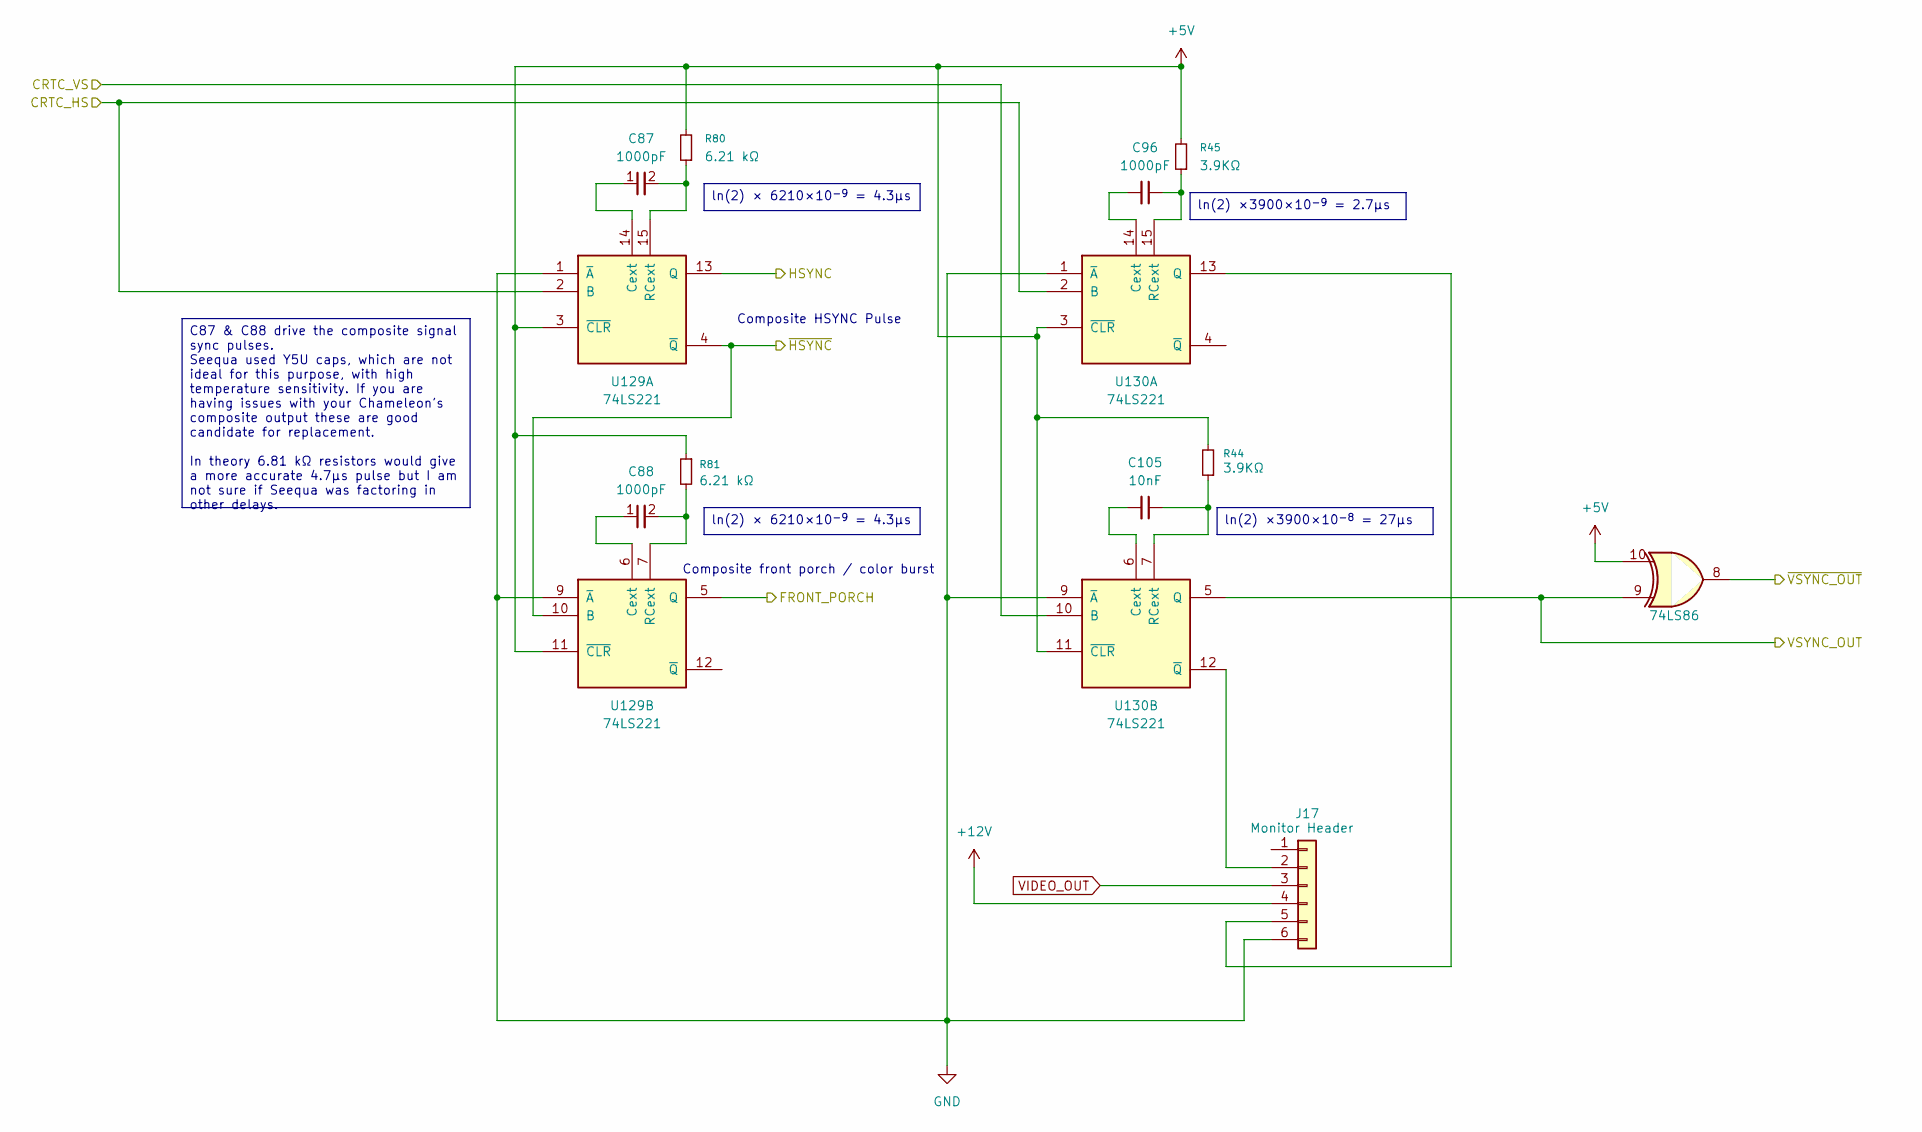
[picture p46: schematic video_sync.kicad_sch]

Parts:
C87, C88: 1000pF; C_Seequa_Bypass_6.5mm
C96: 1000pF; C_Axial_L3.8mm_D2.6mm_P10.00mm_Horizontal
C105: 10nF; C_Axial_L3.8mm_D2.6mm_P10.00mm_Horizontal
J17: Monitor Header; PinHeader_1x06_P2.54mm_Horizontal
R44, R45: 3.9KΩ; R_Seequa_Resistor
R80, R81: 6.21 kΩ; R_Seequa_Resistor
U129, U130: 74LS221; DIP-16_W7.62mm
U139: 74LS86; DIP-14_W7.62mm

Connections:
+5V: R44.2, R45.2, R80.2, R81.1, U129.3 (~CLR), U129.11 (~CLR), U130.3 (~CLR), U130.11 (~CLR), U139.10
+12V: J17.4
CRTC_HS: U129.2 (B), U130.2 (B)
CRTC_VS: U130.10 (B)
FRONT_PORCH: U129.5 (Q)
GND: J17.6, U129.1 (~A), U129.9 (~A), U130.1 (~A), U130.9 (~A)
HSYNC: U129.13 (Q)
unnamed: C87.1, U129.14 (Cext)
unnamed: C87.2, R80.1, U129.15 (RCext)
unnamed: C88.1, U129.6 (Cext)
unnamed: C88.2, R81.2, U129.7 (RCext)
unnamed: C96.1, R45.1, U130.15 (RCext)
unnamed: C96.2, U130.14 (Cext)
unnamed: C105.1, R44.1, U130.7 (RCext)
unnamed: C105.2, U130.6 (Cext)
unnamed: J17.2, U130.12 (~Q)
unnamed: J17.5, U130.13 (Q)
VIDEO_OUT: J17.3
VSYNC_OUT: U130.5 (Q), U139.9
~HSYNC: U129.4 (~Q), U129.10 (B)
~VSYNC_OUT: U139.8

Notes on the sheet:
Composite front porch / color burst
Composite HSYNC Pulse
C87 & C88 drive the composite signal sync pulses. Seequa used Y5U caps, which are not ideal for this purpose, with high temperature sensitivity. If you are having issues with your Chameleon's composite output these are good candidate for replacement. In theory 6.81 kΩ resistors would give a more ac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
ln(2) ×3900×10^{−9} = 2.7μs
ln(2) × 6210×10^{−9} = 4.3μs
ln(2) ×3900×10^{−8} = 27μs
