dbalsom/seequa_chameleon/kicad/vram.kicad_sch

## KiCad design kicad/vram.kicad_sch (2026-05-13)

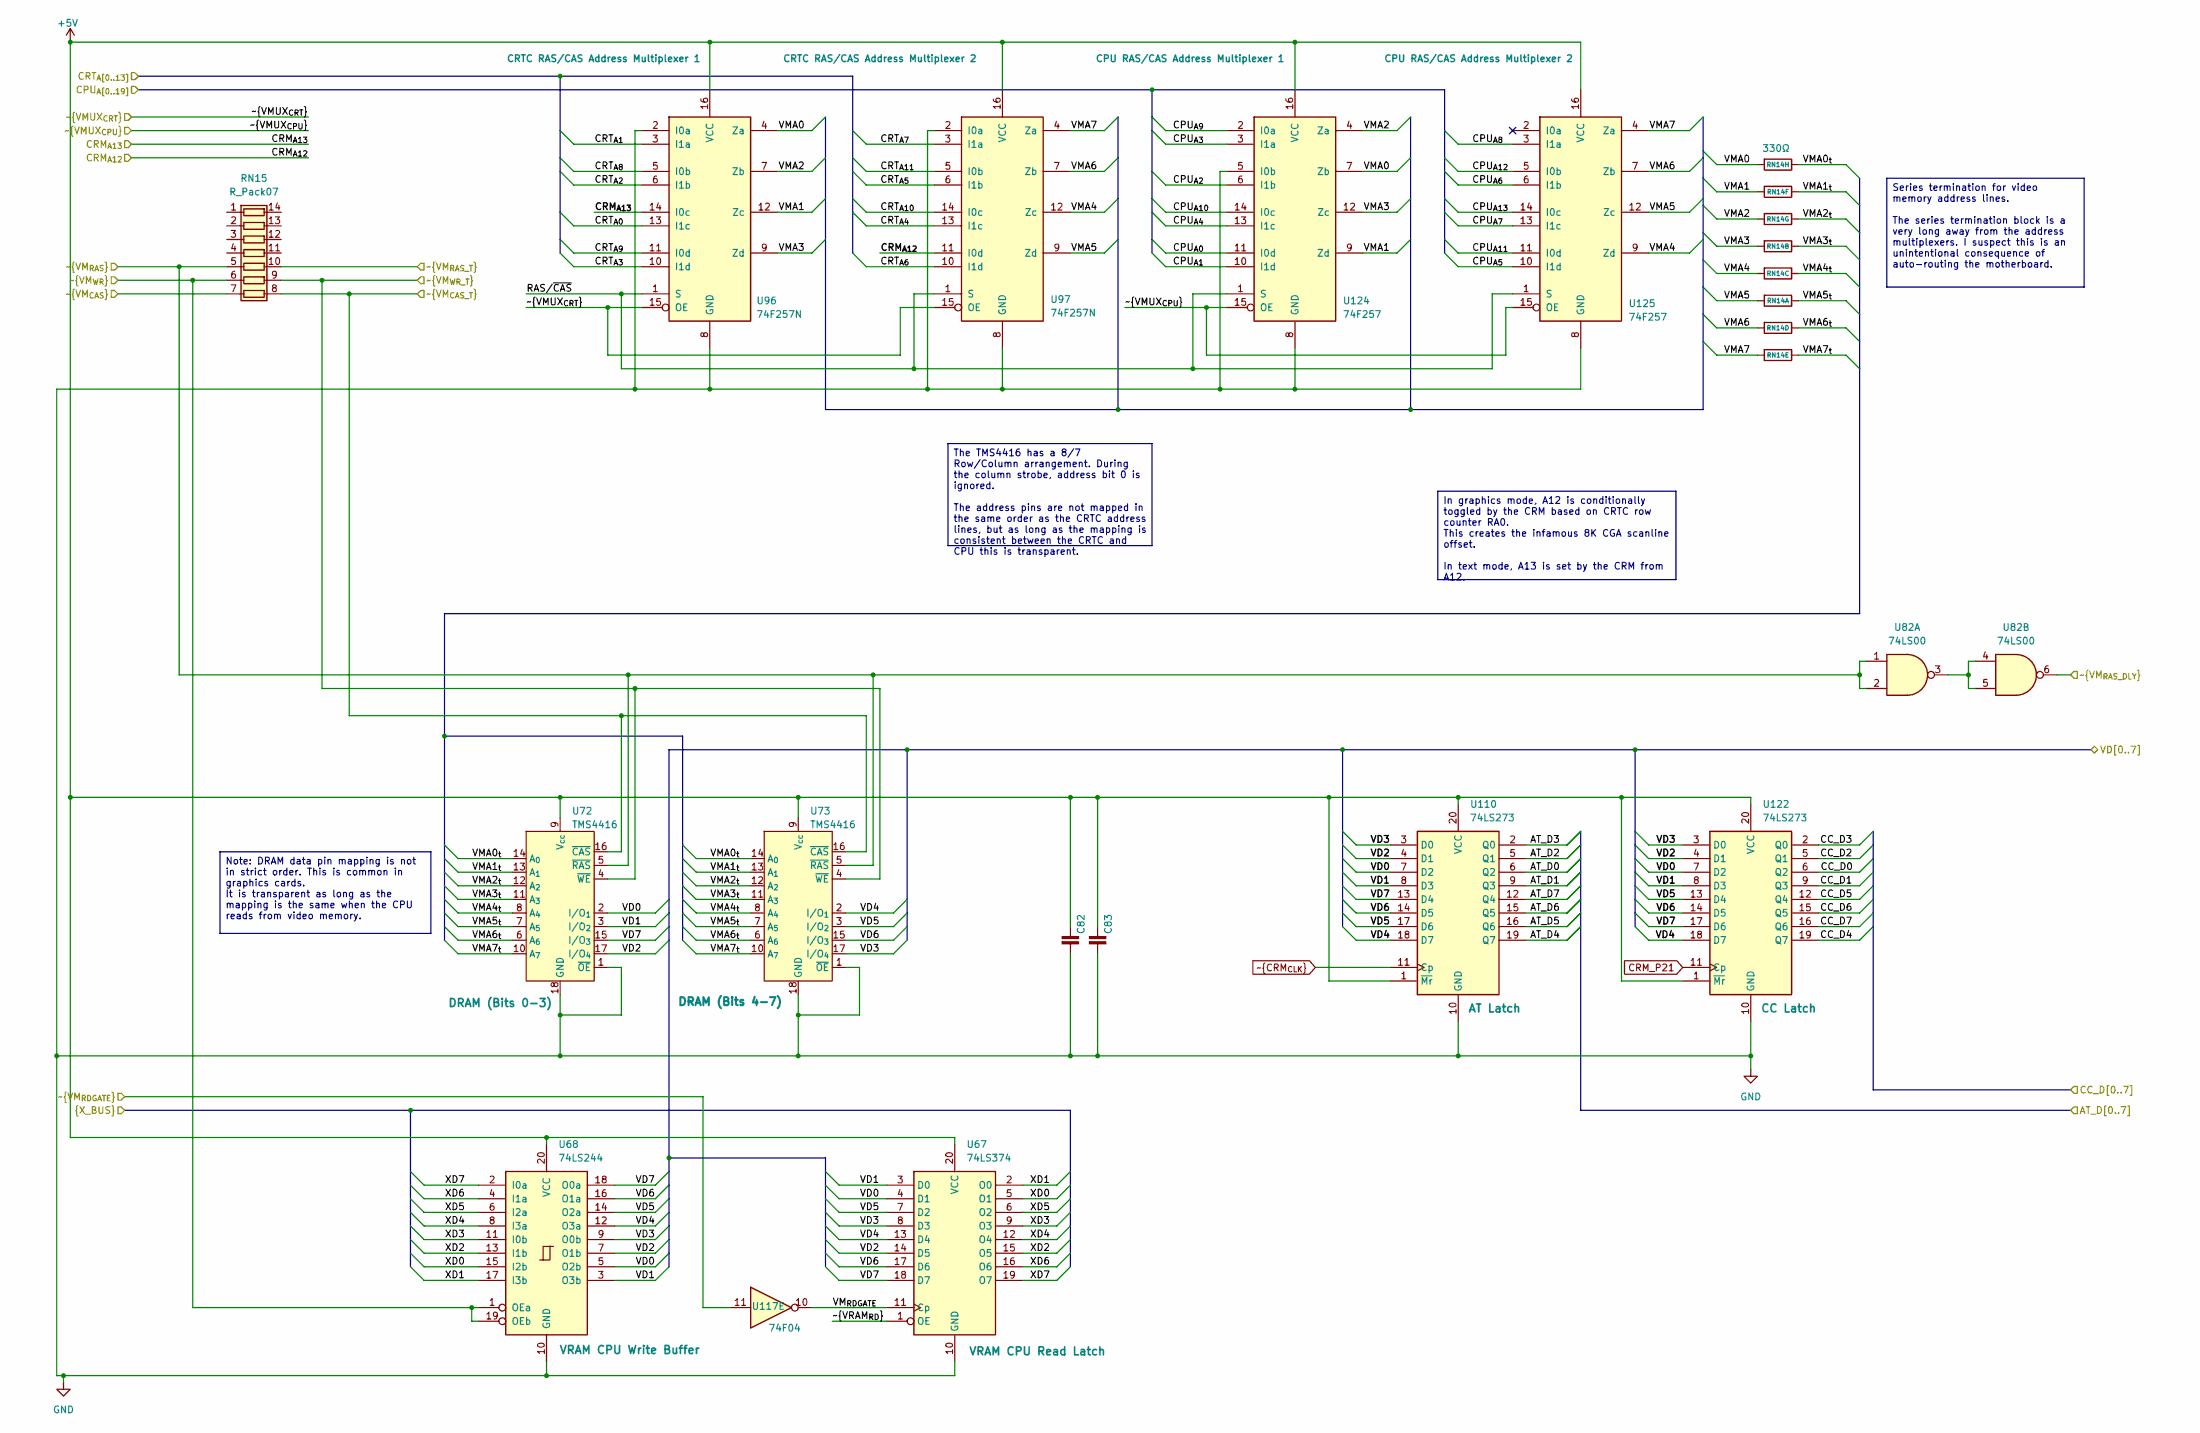
[picture p47: schematic vram.kicad_sch]

Parts:
C82, C83: C_Bypass_5mm; C_Seequa_Bypass_Film_5mm
RN14: 330Ω; DIP-16_W7.62mm
RN15: R_Pack07; DIP-14_W7.62mm
U67: 74LS374; DIP-20_W7.62mm
U68: 74LS244; DIP-20_W7.62mm
U72, U73: TMS4416; DIP-18_W7.62mm
U82: 74LS00; DIP-14_W7.62mm
U96, U97: 74F257N; DIP-16_W7.62mm
U110, U122: 74LS273; DIP-20_W7.62mm
U117: 74F04; DIP-14_W7.62mm
U124, U125: 74F257; DIP-16_W7.62mm

Connections:
+5V: C82.1, C83.1, U67.20 (VCC), U68.20 (VCC), U72.9 (V_{cc}), U73.9 (V_{cc}), U96.16 (VCC), U97.16 (VCC), U110.1 (~Mr), U110.20 (VCC), U122.1 (~Mr), U122.20 (VCC), U124.16 (VCC), U125.16 (VCC)
AT_D0: U110.6 (Q2)
AT_D1: U110.9 (Q3)
AT_D2: U110.5 (Q1)
AT_D3: U110.2 (Q0)
AT_D4: U110.19 (Q7)
AT_D5: U110.16 (Q6)
AT_D6: U110.15 (Q5)
AT_D7: U110.12 (Q4)
CC_D0: U122.6 (Q2)
CC_D1: U122.9 (Q3)
CC_D2: U122.5 (Q1)
CC_D3: U122.2 (Q0)
CC_D4: U122.19 (Q7)
CC_D5: U122.12 (Q4)
CC_D6: U122.15 (Q5)
CC_D7: U122.16 (Q6)
CPU_{A0}: U124.11 (I0d)
CPU_{A1}: U124.10 (I1d)
CPU_{A2}: U124.6 (I1b)
CPU_{A3}: U124.3 (I1a)
CPU_{A4}: U124.13 (I1c)
CPU_{A5}: U125.10 (I1d)
CPU_{A6}: U125.6 (I1b)
CPU_{A7}: U125.13 (I1c)
CPU_{A8}: U125.3 (I1a)
CPU_{A9}: U124.2 (I0a)
CPU_{A10}: U124.14 (I0c)
CPU_{A11}: U125.11 (I0d)
CPU_{A12}: U125.5 (I0b)
CPU_{A13}: U125.14 (I0c)
CRM_P21: U122.11 (Cp)
CRM_{A12}: U97.11 (I0d)
CRM_{A13}: U96.14 (I0c)
CRT_{A0}: U96.13 (I1c)
CRT_{A1}: U96.3 (I1a)
CRT_{A2}: U96.6 (I1b)
CRT_{A3}: U96.10 (I1d)
CRT_{A4}: U97.13 (I1c)
CRT_{A5}: U97.6 (I1b)
CRT_{A6}: U97.10 (I1d)
CRT_{A7}: U97.3 (I1a)
CRT_{A8}: U96.5 (I0b)
CRT_{A9}: U96.11 (I0d)
CRT_{A10}: U97.14 (I0c)
CRT_{A11}: U97.5 (I0b)
GND: C82.2, C83.2, U67.10 (GND), U68.10 (GND), U72.1 (~OE), U72.18 (GND), U73.1 (~OE), U73.18 (GND), U96.2 (I0a), U96.8 (GND), U97.2 (I0a), U97.8 (GND), U110.10 (GND), U122.10 (GND), U124.5 (I0b), U124.8 (GND), U125.8 (GND)
unnamed: U82.3, U82.4, U82.5
RAS/~CAS: U96.1 (S), U97.1 (S), U124.1 (S), U125.1 (S)
VD0: U67.4 (D1), U68.5 (O2b), U72.2 (I/O_{1}), U110.7 (D2), U122.7 (D2)
VD1: U67.3 (D0), U68.3 (O3b), U72.3 (I/O_{2}), U110.8 (D3), U122.8 (D3)
VD2: U67.14 (D5), U68.7 (O1b), U72.17 (I/O_{4}), U110.4 (D1), U122.4 (D1)
VD3: U67.8 (D3), U68.9 (O0b), U73.17 (I/O_{4}), U110.3 (D0), U122.3 (D0)
VD4: U67.13 (D4), U68.12 (O3a), U73.2 (I/O_{1}), U110.18 (D7), U122.18 (D7)
VD5: U67.7 (D2), U68.14 (O2a), U73.3 (I/O_{2}), U110.17 (D6), U122.13 (D4)
VD6: U67.17 (D6), U68.16 (O1a), U73.15 (I/O_{3}), U110.14 (D5), U122.14 (D5)
VD7: U67.18 (D7), U68.18 (O0a), U72.15 (I/O_{3}), U110.13 (D4), U122.17 (D6)
VMA0: RN14.9 (R8.2), U96.4 (Za), U124.7 (Zb)
VMA0_{t}: RN14.8 (R8.1), U72.14 (A_{0}), U73.14 (A_{0})
VMA1: RN14.11 (R6.2), U96.12 (Zc), U124.9 (Zd)
VMA1_{t}: RN14.6 (R6.1), U72.13 (A_{1}), U73.13 (A_{1})
VMA2: RN14.10 (R7.2), U96.7 (Zb), U124.4 (Za)
VMA2_{t}: RN14.7 (R7.1), U72.12 (A_{2}), U73.12 (A_{2})
VMA3: RN14.15 (R2.2), U96.9 (Zd), U124.12 (Zc)
VMA3_{t}: RN14.2 (R2.1), U72.11 (A_{3}), U73.11 (A_{3})
VMA4: RN14.14 (R3.2), U97.12 (Zc), U125.9 (Zd)
VMA4_{t}: RN14.3 (R3.1), U72.8 (A_{4}), U73.8 (A_{4})
VMA5: RN14.16 (R1.2), U97.9 (Zd), U125.12 (Zc)
VMA5_{t}: RN14.1 (R1.1), U72.7 (A_{5}), U73.7 (A_{5})
VMA6: RN14.13 (R4.2), U97.7 (Zb), U125.7 (Zb)
VMA6_{t}: RN14.4 (R4.1), U72.6 (A_{6}), U73.6 (A_{6})
VMA7: RN14.12 (R5.2), U97.4 (Za), U125.4 (Za)
VMA7_{t}: RN14.5 (R5.1), U72.10 (A_{7}), U73.10 (A_{7})
VM_{RDGATE}: U67.11 (Cp), U117.10
XD0: U67.5 (O1), U68.15 (I2b)
XD1: U67.2 (O0), U68.17 (I3b)
XD2: U67.15 (O5), U68.13 (I1b)
XD3: U67.9 (O3), U68.11 (I0b)
XD4: U67.12 (O4), U68.8 (I3a)
XD5: U67.6 (O2), U68.6 (I2a)
XD6: U67.16 (O6), U68.4 (I1a)
XD7: U67.19 (O7), U68.2 (I0a)
~CRM_{CLK}: U110.11 (Cp)
~VMUX_{CPU}: U124.15 (OE), U125.15 (OE)
~VMUX_{CRT}: U96.15 (OE), U97.15 (OE)
~VM_{CAS_T}: RN15.8 (R7.2), U72.16 (~CAS), U73.16 (~CAS)
~VM_{CAS}: RN15.7 (R7.1)
~VM_{RAS_DLY}: U82.6
~VM_{RAS_T}: RN15.10 (R5.2)
~VM_{RAS}: RN15.5 (R5.1), U72.5 (~RAS), U73.5 (~RAS), U82.1, U82.2
~VM_{RDGATE}: U117.11
~VM_{WR_T}: RN15.9 (R6.2), U72.4 (~WE), U73.4 (~WE)
~VM_{WR}: RN15.6 (R6.1), U68.1 (OEa), U68.19 (OEb)
~VRAM_{RD}: U67.1 (OE)

Notes on the sheet:
Series termination for video memory address lines. The series termination block is a very long away from the address multiplexers. I suspect this is an unintentional consequence of auto-routing the motherboard.
Note: DRAM data pin mapping is not in strict order. This is common in graphics cards. It is transparent as long as the mapping is the same when the CPU reads from video memory.
In graphics mode, A12 is conditionally toggled by the CRM based on CRTC row counter RA0. This creates the infamous 8K CGA scanline offset. In text mode, A13 is set by the CRM from A12.
The TMS4416 has a 8/7 Row/Column arrangement. During the column strobe, address bit 0 is ignored. The address pins are not mapped in the same order as the CRTC address lines, but as long as the mapping is consistent between the CRTC and CPU this is transparent.
