dbalsom/seequa_chameleon/(commit log)

2026-02-20 Initial upload
    [composite_video.kicad_sch, cpu.kicad_sch, dma.kicad_sch, expansion_headers.kicad_sch, fdc.kicad_sch, font_sram.kicad_sch, gameport.kicad_sch, gpib.kicad_sch]
2026-02-20 add link to kicad
2026-02-20 Fixes to clocks, keyboard controller stuff.
    [cpu.kicad_sch, dma.kicad_sch, expansion_headers.kicad_sch, keyboard.kicad_sch, parallel.kicad_sch, port_b.kicad_sch, seequa_chameleon.kicad_sch, vc-1.kicad_sch]
2026-02-23 update kicad project
    [composite_video.kicad_sch, cpu.kicad_sch, dma.kicad_sch, expansion_headers.kicad_sch, fdc.kicad_sch, font_sram.kicad_sch, gameport.kicad_sch, gpib.kicad_sch]
2026-02-26 More updates
    [composite_video.kicad_sch, cpu.kicad_sch, dma.kicad_sch, gpib.kicad_sch, lightpen.kicad_sch, palette_regs.kicad_sch, parallel.kicad_sch, ram.kicad_sch]
2026-02-28 Add parallel port, game port
    [composite_video.kicad_sch, cpu.kicad_sch, crtc.kicad_sch, dma.kicad_sch, expansion_headers.kicad_sch, fdc.kicad_sch, font_sram.kicad_sch, gameport.kicad_sch]
2026-03-06 Add RAMPlus board
    [RAMPlus_BOM.csv, bus.kicad_sch, chameleon_ram_card.kicad_pcb, chameleon_ram_card.kicad_sch, dram.kicad_sch, rtc.kicad_sch, serial.kicad_sch]
2026-05-13 Updates, chameleon logo
    [cpu.kicad_sch, expansion_headers.kicad_sch, fdc.kicad_sch, io_decode.kicad_sch, palette_regs.kicad_sch, parallel.kicad_sch, rom.kicad_sch, video.kicad_sch]
2026-05-13 A little work on composite output and GPIB
    [composite_video.kicad_sch, cpu.kicad_sch, crtc.kicad_sch, dma.kicad_sch, expansion_headers.kicad_sch, fdc.kicad_sch, gameport.kicad_sch, gpib.kicad_sch]
2026-06-09 Clean up RAMPlus board post migration
    [RAMPlus_BOM.csv, bus.kicad_sch, chameleon_ram_card.kicad_pcb, chameleon_ram_card.kicad_sch, dram.kicad_sch, rtc.kicad_sch, serial.kicad_sch]
